alfadelta10010/AlphaOneSoC/docs/soc-architecture.md

# AlphaOneSoC — SoC architecture

The SoC around FyraCore: the address map, how it boots, the bus, the memory
controller and the QSPI engine. The overriding constraints are **area** (seven
TinyTapeout tiles, roughly 21 kGE of usable standard-cell area for everything)
and **booting NOMMU M-mode Linux from 16 MB of PSRAM**. Where the two pull
apart, this document says which one won and why.

## Address map

| Region | Base | Size | Attributes | Device |
|---|---|---|---|---|
| Flash | `0x2000_0000` | 16 MB | read, execute | W25Q128JV on QSPI CS0 |
| PSRAM | `0x8000_0000` | 16 MB | read, write, execute, LR/SC, AMO | 2x 8 MB PSRAM on QSPI CS1 (A) / CS2 (B), `addr[23]` picks the chip |
| CLINT | `0x0200_0000` | 64 KB | read, write, AMO | `src/clint.v` |
| PLIC | `0x0C00_0000` | — | reserved, not implemented (accesses fault) | — |
| UART | `0x1000_0000` | 64 KB | read, write, AMO | `src/uart.v`: 16550-compatible subset, byte registers, polled (`docs/pins-and-peripherals.md`) |
| GPIO | `0x1001_0000` | 64 KB | read, write, AMO | `src/gpio.v` + `src/spi.v`: GPIO at `+0x00`-`+0x0C` and the SPI controller (tiny_spi registers) at `+0x20`-`+0x30`, decoded on `addr[5:2]` (`docs/pins-and-peripherals.md`) |
| syscon | `0x1002_0000` | 64 KB | read, write, AMO | `src/syscon.v`: reboot, power-off, reset cause, boot mode, chip ID, straps (section "syscon") |

Everything else is unmapped: an access raises an access fault (cause 1 / 5 /
7) from the core's PMA check, before anything reaches the bus. The windows are
`fyracore` parameters (`PMA_ROM_*`, `PMA_RAM_*`, `PMA_IO0_*`, `PMA_IO1_*`);
the defaults are this map.

* **Flash is read-only.** A store, AMO or SC to it is a store access fault
  (cause 7) and an LR is a load access fault (cause 5): flash has no write
  path in the QSPI engine and no reservation set.
* **LR/SC work only in PSRAM**, the one region with a reservation set.
* PSRAM is at `0x8000_0000` because that is where Linux (`PHYS_RAM_BASE`),
  Spike (`DRAM_BASE`) and KianV all put RAM.

## Boot

**The SoC boots from flash, always.** There is no boot ROM and no strap: the
reset PC (the core's `boot_addr` input, tied off in `alphaone_soc`) is
`0x2000_0000`, the first byte of flash. Whatever was last programmed there is
the first thing the core runs, so nothing about the boot path is fixed in
silicon, and a bare assembly program runs by flashing it. Anything that runs
from PSRAM is put there by code in flash.

**While reset is held, the QSPI pins are released** (every output enable is
0), so the demo board's RP2040 can program the flash over the same Pmod pins
before it releases reset. The Pmod's 10 kΩ pull-ups hold every chip select
high meanwhile (`docs/qspi-memories.md` §1.2).

A program links with `plugins/helpers/link_soc.ld` (code and read-only data
in flash, `.data`/`.bss`/stack in PSRAM) and starts with
`plugins/helpers/boot_flash.S`, which copies `.data` to PSRAM, clears
`.bss`, sets `sp` and jumps to `_start`. (`plugins/helpers/link.ld`, at
`0x8000_0000`, is for the verification flow, which starts the core straight
in PSRAM.)

`mtvec` resets to 0. The spec leaves it unspecified, boot code must set it
before it can take a trap, and 0 matches Spike, so lockstep traces agree from
reset. A trap taken before `mtvec` is written jumps to 0, which is unmapped,
and faults there over and over: a cause-1 loop at 0 that rewrites mepc,
mcause and mtval on every pass, so the first trap's cause is lost, and the
QSPI bus goes quiet, since 0 is outside every window. Erased flash
(`0xFFFFFFFF`, an illegal instruction) at the reset vector ends this way.
Kept at 0 by decision (2026-09-29); the first thing boot code does is set
`mtvec`.

**A reboot restarts the SoC from flash exactly as a pin reset does.** A write
of `0x7777` to syscon's FINISH register holds the SoC in reset for two clock
edges (the shortest pin reset), releases the QSPI pins for those two clocks
and re-runs the start-up sequence. What it keeps is RESET_CAUSE (SOFT is
added), BOOT_MODE and the `rd_late` strap, which the flash loader reads to
decide what to boot (section "syscon").

## Bus fabric

**The core's own request/ready handshake, fanned out — not APB.**

APB needs a two-phase transfer (SETUP, then ACCESS with `PENABLE`) and a
bridge state machine to generate it, so every access costs at least two
cycles and a few registers. The core already has a request/ready port with a
held request (see `src/fyracore.v`), which is all a single-master bus needs.
`src/soc_bus.v` adds only:

* an address decode on a handful of bits — valid only because the PMA check
  has already refused anything outside the windows:
  `addr[31]` → PSRAM, `addr[29]` → flash, `addr[28]` → peripherals (then
  `addr[17:16]`), otherwise the CLINT;
* a read-data and ready mux.

It has no registers. Peripherals answer with combinational read data, and
in the cycle they are selected, so a peripheral access is one cycle -- except
for back-pressure: the UART holds a THR write, and the GPIO block a write to the SPI controller, until it is ready. An IO target may hold `ready` low only
on a cycle its own select is high, so the bus simply ANDs the IO readies. A
peripheral with a side effect (a UART RX pop, a THR load) acts only on the
cycle its select and its `ready` are both high; the request strobe
guarantees that cycle is one real access.

The instruction port goes straight to the memory controller: fetch is only
ever from flash or PSRAM.

## Memory controller (`src/mem_ctrl.v`)

Joins the core's two ports onto the one QSPI engine.

* **Arbitration: data first.** When both ports are waiting, the data request
  goes first. The pipeline only issues a new data request on the cycle
  *after* a fetch completes or after a fetch-word-reuse hit, so the core can
  make up to 4 data handshakes between two fetches (two back-to-back AMOs: a
  load and a store each), not one. The bound is what keeps a fetch from being
  starved: the formal harness `core_df` checks at most 4 data handshakes per
  held fetch (BOUNDED, 32 steps from reset), and the worst fetch latency of
  442/456 clocks (`rd_late` 0/1) is stated for that bound. Serving data first
  also avoids reading the next instruction before a load and then losing it
  while the load stalls the pipeline; fetch-first would do that on every load.
* **Chip select** from the address: flash if `addr[31]` is 0, otherwise PSRAM
  A/B by `addr[23]`.
* **Reads are always a whole word** from the word address, whatever the byte
  enables say. Memory reads have no side effects, and a whole word needs no
  lane steering: byte *k* of the transfer is lane *k*.
* **Writes send only the enabled bytes**, starting at the first enabled lane.
  RISC-V stores are naturally aligned, so the enables are always contiguous.
* **Fetches are 4 bytes from the halfword `pc`**, not from a word boundary:
  a QSPI read streams from any byte address, so a straddling 32-bit
  instruction costs nothing extra. The exception is a PSRAM fetch that crosses
  a 1 KB page (`pc[9:1]` all ones). Parts with row-boundary crossing
  (APS6404L-3SQR) run on into the next page; "compatible" parts without it
  wrap to the start of the page, and the Pmod may carry either. So that fetch
  is split into two 2-byte reads, the second at the next page. The carry out
  of the page number into bit 23 is the step from PSRAM A to B, so the A/B
  boundary (`0x807F_FFFE`) is just one instance. The QSPI engine's read shift
  register carries over between the two reads, so the split needs no extra
  storage.
* **Requests are sampled only while the engine is idle**, and it is never
  idle on the cycle it reports done. On its ready cycle the core still shows
  the request being completed (a fetch's old pc), so starting a transaction
  from it would read a stale address.

## QSPI engine (`src/qspi_ctrl.v`)

One transaction at a time: chip select low, command, 24-bit address, then
data. The **PSRAMs run in QPI mode**: the command, too, goes out on all four
lines. The **flash is unchanged**: its quad I/O read sends the command on
IO0 and the address and data on all four lines (the chip's default "SPI
mode", as opposed to QPI mode). `docs/qspi-memories.md` §9 compares the
modes, including QPI for the flash.

| Access | Command | Wire timing (SCK cycles) | 4 bytes |
|---|---|---|---|
| PSRAM read | `0x0B` fast read, QPI | 2 cmd + 6 addr + 4 wait + 2 per byte | 20 |
| PSRAM write | `0x38` quad write, QPI | 2 cmd + 6 addr + 2 per byte | 16 |
| Flash read | `0xEB` quad I/O read | 8 cmd (IO0) + 6 addr + 6 dummy + 2 per byte | 28 |

The PSRAM's 4 wait cycles are all released, a full four for the bus to turn
around. The flash reads the first two of its 6 dummy cycles as its mode
byte: the engine drives `1111` there (mode byte `0xFF`, so the flash never
enters continuous-read mode) and releases the bus for the other four.

* **SCK = clk / 2.** Output data changes as SCK falls. Read data is sampled
  one full SCK period after the falling edge that launched it, on the clock
  edge that drives SCK low again. The data then has two core clocks to cross
  the pad and device delays rather than one, which is what keeps the design
  robust against TinyTapeout's slow I/O. The device's output hold plus the pad
  delays cover the other side of that edge.
* **CS is high for at least two clocks** between transactions: 30 ns at
  66 MHz, above the PSRAM's minimum deselect time.
* **The pins are registered** where a glitch could matter (SCK, the chip
  selects, the output enable). The data outputs are combinational: they settle
  a full clock before the SCK edge that samples them.
* **Pinout** follows the TinyTapeout QSPI Pmod on `uio`: 0 CS0 (flash),
  1 SD0, 2 SD1, 3 SCK, 4 SD2, 5 SD3, 6 CS1 (RAM A), 7 CS2 (RAM B). The
  rest of the chip's pins are in `docs/pins-and-peripherals.md`.

* **Read latency is a strap**, `qspi_rd_late` (on `ui_in[0]`). At 0 a nibble is sampled two
  clocks after its launching edge, which covers a clock-to-output time plus
  pad round trip up to about 2 clocks. At 1 it is sampled three clocks after,
  which covers about 1 to 3 clocks, and chip select stays low one clock
  longer for the last nibble. TinyQV measured the TinyTapeout pad round trip
  at a little over 20 ns; at 50 MHz use 0, and at 62.5 MHz (the clock the
  3x4 harden closes at) and near 66 MHz use 1. It is a
  strap rather than a register because flash reads must work before any
  software runs, and it is sampled during reset and held, so a pin that
  changes later cannot move the sampling point mid-read. syscon latches it at
  the pin reset and holds it through reboots and power-off (a reboot does not
  re-read `ui_in[0]`, which is GPIO by then); software reads it in STRAPS. Measured in `tb_qspi` at a 10 ns clock: 0 passes 2–19 ns,
  1 passes 12–29 ns.
* **Writes never select the flash.** `0x38` is the PSRAM's quad write, but
  on the W25Q128JV-DTR it is Enter QPI. The PMA already faults stores to
  flash; this is the backstop.

A 4-byte PSRAM read is 20 SCK cycles, about 44 core clocks with the deselect
time (a flash read 28, about 60). That is the dominant cost of the whole
machine — see "Performance" below.

**Start-up sequence.** The Pmod is shared between designs on the demo board
and is not power cycled when the board switches to this one, so its devices
can be handed over in modes this engine does not speak. TinyQV, for example,
leaves the PSRAMs in QPI mode and the flash in continuous-read mode. The
PSRAM datasheet also asks for a reset after power-up. Before accepting its
first request the engine therefore sends the following, and leaves the
PSRAMs in QPI mode:

| Chips | Sent | Effect |
|---|---|---|
| CS1+CS2 | `F5h` in QPI form (2 clocks) | PSRAM exits QPI; a PSRAM in SPI mode sees an unfinished command |
| CS1+CS2 | `66h`, `99h` | PSRAM reset enable, reset (back to SPI mode, linear burst) |
| CS0 | 8 clocks of `1111` | flash leaves quad continuous-read mode |
| CS0 | 16 clocks of `1111` | flash leaves dual-I/O continuous-read mode (12 address + 4 mode clocks); must come after the 8-clock window, which a flash in quad continuous read needs first |
| CS0 | `FFh` in QPI form (2 clocks) | flash exits QPI (-DTR part); a flash in SPI mode sees an unfinished command |
| CS1+CS2 | `35h` | PSRAM enters QPI mode |

The flash steps separate the PSRAM reset from `35h` by far more than the
PSRAM's 50 ns tRST. The first step is also what takes a PSRAM we left in QPI
mode ourselves back to SPI at the next reset. The sequence starts 8 clocks
after reset is released, so a reset that lands just after the `99h` cannot
bring the restarted sequence's first command inside tRST. Each start-up
window ends with chip select rising while SCK is still high, SCK falling a
clock later: for a flash in continuous read the next falling edge would
start its data, and the two sides' pads would overlap for a moment. The
single two-clock `FFh` is the one Exit QPI that counts whether or not a
flash cancels Exit QPI on extra clocks (the datasheet does not say).

Not undone, and so the job of whatever programs the flash: a flash burst
wrap set with `77h`, deep power-down (`B9h`), and a cleared Quad Enable bit
(the "IM" part ships with QE = 0).

**Board prerequisites.** While reset is held the chip selects are released
(also for two clocks at every reboot, and for as long as the chip is powered
off);
the Pmod's 10 kΩ pull-ups (R1–R3) keep every chip deselected. The data lines
have no pull-ups. The TinyTapeout wrapper
(`src/tt_um_alfadelta10010_alphaone_soc.v`) makes this reset from `rst_n`: set
at once, clock or no clock, and released on the second clock edge after
`rst_n` rises. It releases the eight pins from that same reset, so they are
let go before the first clock edge and stay let go until the SoC has been
reset (`docs/pins-and-peripherals.md`).

**Device prerequisites.**
* The flash's Quad Enable bit (SR2 bit 1) must be set once. It is
  non-volatile; TinyTapeout's QA sets it on the Pmods it ships, and the
  "Configure and flash the QSPI Pmod" guide sets it on others.
* The devices' power-up time (150 µs for the PSRAM) has passed before reset
  is released. On the demo board it long has.
* PSRAM maximum chip-select-low time (tCEM) is 8 µs for the standard grade
  the Pmod carries (APS6404L-3SQR-SN). The longest transaction is about 60
  clocks, so the core clock must be above about 8 MHz.
* The flash is idle when reset is released: no program, erase or status
  write still running, and no erase or program suspended. While BUSY the
  flash ignores everything but status reads and suspend (-DTR §7.1.1; a
  software reset would end the operation and corrupt it, §8.2.45), for up
  to 400 ms after a sector erase, 2 s after a 64 KB block erase and 200 s
  after a chip erase. The engine has no 1-bit read path to poll it, so a
  flash handed over mid-write would be fetched from as floating lines.

## Timer and interrupts

* **`mtime` counts core clocks.** There is no prescaler, because it would cost
  a counter and a register and buy nothing Linux needs. The device tree's
  `timebase-frequency` must equal the core clock.
* **MTIP is registered** in the CLINT. That takes the 64-bit
  `mtime >= mtimecmp` compare out of the path into the core's interrupt and
  next-PC logic, at the cost of one flop and one cycle of latency.
* `mtimecmp` resets to all-ones, so no timer interrupt is pending out of reset.
* No PLIC. With a polled UART, Linux needs no external interrupt; the `0x0C00_0000`
  window is reserved for one if that changes. `docs/pins-and-peripherals.md`
  explains why interrupts would not make the console faster on this core.
* Registered MTIP is legal: Priv §3.2.1 says MTIP reflects the comparison
  "eventually, but not necessarily immediately". Linux's CLINT driver sets
  MTIE before it writes `mtimecmp` (low word, then high), with MIE off, and
  the handler clears MTIE, so the extra cycle is invisible to it.

## syscon (`src/syscon.v`)

One small register block at `0x1002_0000`: reboot, power-off, the simulation
exit code, the reset cause, a boot-mode note that survives a reboot, the chip
ID, the read-sampling strap and a watchdog. It is what Linux's generic `syscon`,
`syscon-poweroff`, `syscon-reboot` and `syscon-reboot-mode` drivers point
into.

| Offset | Name | Access | After a pin reset | At a reboot |
|---|---|---|---|---|
| +0x00 | FINISH | W; reads 0. A store with byte lanes 0 and 1 both written (`sh` or `sw`) acts on `wdata[15:0]`: `0x7777` reboot, `0x5555` power-off, `0x3333` fail (halts like power-off; `wdata[31:16]` is a code for the testbench). Any other value, or a narrower store, does nothing | - | - |
| +0x04 | RESET_CAUSE | R / W1C, lane 0. [0] PIN, [1] SOFT, [2] WDT | `0x1` | SOFT set, PIN kept |
| +0x08 | BOOT_MODE | R/W, lane 0, [7:0] | `0x00` | kept |
| +0x0C | CHIP_ID | R, the `CHIP_ID` parameter | `0x4131_5301` | - |
| +0x10 | STRAPS | R, [0] = `qspi_rd_late` as latched at the last pin reset | the pin | kept |
| +0x14 | CLK_GATE | reserved: reads 0, writes ignored | - | - |
| +0x18 | POWER | reserved: reads 0, writes ignored | - | - |
| +0x1C | - | reads 0, writes ignored | - | - |
| +0x20..+0xFC | - | read 0, writes ignored | - | - |
| +0x100..+0x1FF | WDT | the watchdog, below | 0 (TOP 15) | disabled |
| +0x200..+0xFFFC | - | read 0, writes ignored; no register is aliased | - | - |

CHIP_ID is ASCII "A1S" in [31:8] and the silicon revision `0x01` in [7:0].

**The whole 64 KB window is decoded.** Only +0x00..+0x1C and the watchdog window
+0x100..+0x1FF are registers; every other word reads 0 and ignores writes, with no alias of any register at any
offset. That includes the SoC test mailbox words at +0x7F0 (EVENT), +0x7F4
(VALUE), +0x7F8 (VALUE2) and +0x7FC (spare), which the testbench watches on
the core's data port (`tests/soc/periph.h`) and the hardware ignores. They sit
below +0x800 because a store offset is a 12-bit signed immediate, so
`sw x, 0x7F0(s11)` assembles from the same base as the real registers and
+0xF00 would not. syscon never holds `ready` low, so `soc_bus` needs no ready
port for it.

### Two resets

`alphaone_soc` has two resets. `rst` is the chip's reset (`rst_n` through the
wrapper). `rst_soc = rst | rq | off`, an output of syscon, is the reset of
every other block.

| Reset | Blocks on it | Why |
|---|---|---|
| `rst` | syscon's RESET_CAUSE, BOOT_MODE, strap flop, and the reboot and power-off flops (`rq`, `rq2`, `off`) | These must survive a reboot, and syscon must not reset itself in the middle of the write that asked for it |
| `rst_soc` | the core | A reboot restarts it at the reset vector |
| | `mem_ctrl` | It holds the old core's outstanding fetch |
| | `qspi_ctrl` | It must abort the transaction a reboot cuts and re-run its start-up sequence, so every device is back in a known mode |
| | the CLINT | `mtimecmp` must come back all-ones and `msip` 0, so no interrupt is pending at boot |
| | the UART | A break (`LCR.SBC`) must drop and the divisor return to its reset value for the boot loader |
| | the GPIO block | The OLED must go back into reset with its panel supply off, and a half-sent SPI byte must stop |

`rst_soc` is a function of `rst` and flops alone, nothing from the bus, and is
used only as a synchronous reset (the only asynchronous resets in `src/` are
the wrapper's own `rst_n` flops). syscon's bus writes are ignored while
`rst_soc` is high. The watchdog's flops are on `rst_soc` as well (see "Watchdog"). The reset tree
gains one OR at its root.

The generator is in the SoC, not in the wrapper: `alphaone_soc`'s ports do not
change, the SoC benches can test a reboot without the wrapper, and the
hardened wrapper is untouched.

### Reboot

A store of `0x7777` to FINISH sets `rq`, which holds `rst_soc` for exactly two
clock edges, the same as the shortest pin reset (the wrapper releases `rst` on
the second edge after `rst_n` rises). Every block therefore restarts from the
state it was already verified to start from. `rq` is a single flop held high
across both edges; its timer `rq2` does not feed the OR, so there is no
two-flop hand-over on the reset.

| Edge | `rst_soc` before it | At the edge |
|---|---|---|
| E0 | 0 | The store completes; `rq` <- 1, RESET_CAUSE.SOFT <- 1 |
| E1 | 1 | Every block but syscon resets: `ctl_oe` and `io_oe` <- 0 (QSPI pins released), `cs_n` <- 111, `sck` <- 0, `uo_out` = `0xB9`, pc <- the reset vector; `rq2` <- 1 |
| E2 | 1 | Still in reset; `rq` <- 0, `rq2` <- 0 |
| E3 | 0 | First running edge: `ctl_oe` <- 1 (SCK and the chip selects driven idle), the start-up sequence starts 8 clocks later, the core fetches `0x2000_0000` |

That is the shape of a pin reset after `rst_n` rises. In the acceptance run
(a flash-booted program that reboots once, `tb_soc_reboot`) both boots read
`mtime` as 531 at the same instruction, so the reboot restarts cycle for cycle
like a pin reset, and `ctl_oe` was low for 2 cycles. Two edges are the shortest
reset the blocks were verified with; nothing needs more.

### Power-off

A store of `0x5555` (or the fail value `0x3333`) sets `off`, which holds
`rst_soc` until `rst`:

* The QSPI pins are released. The Pmod's 10 kΩ pull-ups hold every chip
  select high, so the flash and both PSRAMs deselect and drop to standby.
* `uo_out` = `0xB9`: UART idle, RTS# not ready, the OLED in reset with its
  panel supply off.
* The clock keeps running. Nothing gates a clock yet, so only the clock tree
  and the flops' clock pins toggle; `mtime` stops, because the CLINT is in
  reset.
* Only `rst_n` wakes it.

**There is no flash deep power-down (`B9h`).** Waking the flash needs `ABh`
and tRES1 (3 µs, about 190 clocks) in the start-up sequence, which is a new
long counter in `qspi_ctrl`. A flash left in deep power-down is hidden state
on a Pmod shared between designs, which the next design or the RP2040's
programmer may not undo (`qspi_ctrl.v`'s header already lists `B9h` among the
states we leave alone). And the gain is microamps, on a chip whose clock keeps
running.

### FINISH

FINISH follows QEMU's `sifive_test` (`hw/misc/sifive_test.c`): only offset 0
acts, `status = val & 0xffff`, `code = val >> 16`; `0x3333` is FAIL, `0x5555`
PASS and `0x7777` RESET; reads return 0. The benches therefore use the same
codes as software built for QEMU's `virt` machine. syscon acts on a store
whose lanes 0 and 1 are both written (`sh` or `sw`), as `sifive_test` accepts
2- and 4-byte accesses. FINISH reads 0 because Linux's `regmap_update_bits()`
reads the register before it writes and skips the write if the value would not
change: reading back `0x5555` or `0x7777` would make the driver do nothing.

### RESET_CAUSE

There are three bits: PIN, SOFT and WDT (set when the watchdog fires).
**There is no power-on bit:** TinyTapeout has no power-on-reset cell, and a
power-on is always followed by an `rst_n` pulse from the board, so the chip
cannot tell it from a pin reset. All bits are sticky and cleared only by
writing 1 to them (lane 0) or by the pin reset that sets PIN again. A reboot
sets SOFT and keeps what was there, so after a reboot the register reads `0x3`
unless software cleared PIN first; after a watchdog reset it reads `0x5` if
nothing else set a bit since the pin reset (`0x7` after an earlier reboot): the
bits accumulate. Rule: software that wants the cause of the last reset alone
reads RESET_CAUSE at boot and then writes `0x7` to clear it; our kernel and
flash loader are to do so at every boot.

### BOOT_MODE and reboot-mode

BOOT_MODE is a byte software writes before it reboots; the flash loader reads
it after to decide what to boot. A pin reset clears it. Linux's
`syscon-reboot-mode` writes a mode's magic to it before calling the restart
handler. `reboot-mode.c` never writes a magic of 0, so the device tree's modes
are 1 and 2: BOOT_MODE 0 then means "pin reset, or no mode written", and a
"normal" reboot after a "bootloader" one does overwrite it.

### CLK_GATE and POWER

Reserved: they read 0 and ignore writes, instead of the R/W registers
`docs/ROADMAP.md` 1.2 proposed. No clock-gate cell is used anywhere yet (the
one ICG attempt failed TinyTapeout's lint with a multiple-driver error and
grew hold buffers), and ROADMAP 6.2 puts power measurement before any gating.
A register with no function would be flops and an ABI nobody can define. The
offsets are kept so the map does not move when they arrive.

### Strap

syscon owns the `qspi_rd_late` strap flop, loaded on every edge while `rst` is
high (the same window as before syscon existed) and drives `qspi_ctrl`'s
`rd_late` input: the live pin while `rst` is high, the latched value
otherwise. `qspi_ctrl.v` is unchanged: its `late` flop still reloads whenever
its reset is high, but during a reboot it sees the latched value, not
`ui_in[0]`, which is GPIO by then. A scratch run flipped the pin at a reboot
and the second boot still read flash; a version that follows the pin hangs in
the second boot.

### Area

syscon without the watchdog is **0.078 tile, 14 flops** (`rq`, `rq2`, `off`, the strap flop,
`cause[1:0]`, `boot_mode[7:0]`), from the audit's recipe (`docs/area-audit.md`), re-run on the
committed RTL 2026-10-24, with the TT cell set (882.1 µm²), within the 0.5-tile budget
`docs/ROADMAP.md` allows for new RTL. The reset tree's extra OR at its root is
the one thing a harden should check, at the slowest corner. The watchdog adds
0.072 tile and 9 flops (815.8 µm²), and the `~rst_soc` gate on `fire` about
10 µm² and no flop: 0.151 tile and 23 flops in all, 1,707.9 µm² (see
"Watchdog"). These are flat per-block figures; they are re-measured in context
at the area pass.

### Watchdog (`src/syscon.v`, +0x100..+0x1FF)

A minimal hardware watchdog in the Synopsys DesignWare WDT layout, so that
Linux's upstream `dw_wdt` driver (`snps,dw-wdt`, `CONFIG_DW_WATCHDOG`, which
depends only on `HAS_IOMEM`) runs it unchanged: there is no kernel code to
write or carry. On expiry it raises the same reboot request as a FINISH write
of `0x7777` and sets RESET_CAUSE.WDT. It is a 256-byte window inside syscon's
64 KB, decoded on `addr[15:8] == 8'h01`; it overlaps none of the registers
above, and the rest of the window stays read-0, write-ignored with no alias.
It gets its own device-tree node, beside the `syscon` node, not inside its
`reg`.

| Offset | Name | Access | After any `rst_soc` reset |
|---|---|---|---|
| +0x100 | WDT CR | Lane 0. [0] EN: a write with bit 0 = 1 sets it; nothing clears it but a reset. [1] RESP_MODE reads 0 and ignores writes | 0 |
| +0x104 | WDT TORR | [3:0] TOP, R/W, lane 0; reads `{TOP, TOP}` in [7:0]. A write also kicks | `0xFF` (TOP 15) |
| +0x108 | WDT CCVR | Reads 0 | - |
| +0x10C | WDT CRR | Lane 0: writing `0x76` kicks, any other value is ignored. Reads 0 | - |
| +0x110, +0x114 | STAT, EOI | Read 0 | - |
| +0x1F4 | COMP_PARAMS_1 | Reads `0x0000_0040` (USE_FIX_TOP: timeout TOP = 2^(16+TOP) clocks) | - |
| other +0x100..+0x1FF | - | Read 0, writes ignored | - |

Source: `drivers/watchdog/dw_wdt.c` and `snps,dw-wdt.yaml` (torvalds master,
read 2026-10-23). The driver writes CR (EN, RESP_MODE), TORR (`top | top << 4`),
reads CCVR for `get_timeleft`, writes `0x76` to CRR to kick, and reads
COMP_PARAMS_1 bit 6 to learn that the timeouts are the fixed powers of two.

**Timeout.** TOP *t* gives 2^(16+*t*) clocks, *t* = 0..15.

| TOP | 2^(16+TOP) clocks | at 62.5 MHz | at 50 MHz | TOP | at 62.5 MHz | at 50 MHz |
|---|---|---|---|---|---|---|
| 0 | 65,536 | 1.05 ms | 1.31 ms | 8 | 268 ms | 336 ms |
| 2 | 262,144 | 4.19 ms | 5.24 ms | 10 | 1.07 s | 1.34 s |
| 4 | 1,048,576 | 16.8 ms | 21.0 ms | 12 | 4.29 s | 5.37 s |
| 6 | 4,194,304 | 67.1 ms | 83.9 ms | 14 | 17.2 s | 21.5 s |
| | | | | 15 | 34.4 s | 42.9 s |

At 62.5 MHz `dw_wdt` has `min_timeout` 1 s (TOP 10), `max_hw_heartbeat_ms`
34,359 (TOP 15) and a default of 30 s (TOP 15); for longer timeouts the
watchdog core pings on the kernel's behalf.

**Timebase: a tap of `mtime`.** syscon takes `wdt_tap = mtime[29:14]` from the
CLINT. TOP *t* selects `mtime[14+t]`, whose rising edges come every
Pt = 2^(15+*t*) clocks. There is no prescaler and no extra counter. While any
reset is held the CLINT is reset too, so `mtime` sits at 0 and no tap moves.
The cost is that software can write `mtime`: a write that moves it backwards
delays the watchdog, and a loop that keeps rewriting it would keep it from
firing; and a write that toggles the tapped bit counts as a tick, so writes
can also make it fire early (three toggling writes fire it 10 clocks after a
kick). Linux's timer driver never writes `mtime` (it reads it and writes
`mtimecmp`), so this is accepted; a private prescaler would cost about 24
flops (+0.06 tile).

**Accuracy: never early unless software writes mtime, at most 1.5x late.** A
2-bit tick count, cleared by a kick, by a TORR write and while disabled, counts
the rising edges of the tap; the third one fires. The first edge comes within
(0, Pt] of the clear, so the reset comes in (2Pt, 3Pt] after it, which, with no
software write to `mtime`, is more than 1x and at most 1.5x the
2^(16+TOP) timeout (plus one clock, see TORR below). A 1-bit count would save
0.007 tile and allow up to 2x late. Linux pings at half the hardware timeout,
so neither matters to it.

**Kicks, TORR and the lock.**

* A kick is a CRR write whose lane 0 holds `0x76`: eight bits, not sixteen. CR
  and TORR writes take no key.
* Once enabled it cannot be stopped except by a reset. That is DesignWare
  behaviour, and `dw_wdt` expects it: with no reset controller its `stop` only
  marks the watchdog as still running and keeps pinging it. This is the lock,
  always on, with no extra bit.
* A TORR write kicks and makes no tick of its own. Changing TOP switches the
  tapped bit, which can look like a rising edge and make the next reset come
  one tick early (15 clocks against a floor of 16 in a scratch run), so a TORR
  write clears the count and forces the edge detector's previous value to 1
  for that cycle. The cost is one clock of worst case: a real edge in that
  cycle is swallowed, so the bound is 3Pt + 1.
* TORR resets to TOP 15 (reads `0xFF`): a program that sets EN without writing
  TORR gets 34 s, not 1 ms.
* RESP_MODE reads 0 and ignores writes: there is no interrupt line, and with
  no `interrupts` property the driver offers no pretimeout.

**CCVR reads 0**, so `/sys/class/watchdog/watchdog0/timeleft` shows 0 s. A real
readback needs a variable shifter, about +0.12 tile.

**SA-008.** A kick or a TORR write in the very cycle of the third tick does not
stop the fire. The reset still comes within the bound above; software that
kicks at the last instant of the timeout can lose the race, as with any
watchdog.

**Reset domains: no loop, no fire while off.**

* The watchdog's own flops (EN, TOP, count, tick edge) are on `rst_soc`. A
  pin reset, a reboot, power-off and its own expiry all leave it disabled
  with TOP back to 15.
* Its expiry is a one-cycle pulse `fire` ORed into the reboot request `rq`. It
  cannot repeat: the tick is an edge, gone the next cycle, and on the edge
  after that `rst_soc` clears EN.
* It cannot fire while any reset is held: `fire` is gated by `rst_soc`. That
  matters for one cycle. A FINISH store sets `rq` or `off` on its edge, but
  EN and the count clear only on the next edge, so a third tick in the cycle
  after the store would otherwise set WDT and raise `rq` (a reboot would read
  RESET_CAUSE `0x7`, not `0x3`). From that next edge `rst_soc` holds EN at 0
  and `mtime` at 0, through a reboot and for as long as the SoC is off.
* RESET_CAUSE bit 2 (WDT) is on `rst`, so it survives the reboot it caused.
  A fire in the same cycle as a W1C of bit 2 leaves it set (set wins). If
  `fire` and a FINISH reboot meet in one cycle, SOFT and WDT are both set and
  there is one reboot; with a power-off, `off` wins.

**Area.** syscon with the watchdog is **0.151 tile, 23 flops** (1,707.9 µm²,
the audit's recipe (`docs/area-audit.md`), re-run on the committed RTL
2026-10-24, with the TT cell set), against 0.078 tile and 14 flops
without. The watchdog is +815.8 µm², about +0.072 tile, +9 flops: EN, TOP[3:0],
count[1:0], the tick edge and RESET_CAUSE[2]. The alternative considered and
not taken, a custom keyed register with an out-of-tree driver, measured
+0.068 tile and needs a kernel patch carried for the life of the project.
Linux's `softdog` costs no area but catches only a hung userspace, not a hung
kernel or a CPU spinning with interrupts off.

### Linux

Device tree. `reg` is for a root with `#address-cells = <1>`; with `<2>` it is
`<0x0 0x10020000 0x0 0x20>`.

```dts
syscon: syscon@10020000 {
    compatible = "alfadelta10010,alphaone-syscon", "syscon", "simple-mfd";
    reg = <0x10020000 0x20>;
    reg-io-width = <4>;

    poweroff {
        compatible = "syscon-poweroff";
        offset = <0x0>;
        value = <0x5555>;
    };

    reboot {
        compatible = "syscon-reboot";
        offset = <0x0>;
        value = <0x7777>;
    };

    reboot-mode {
        compatible = "syscon-reboot-mode";
        offset = <0x8>;
        mask = <0xff>;
        mode-normal = <0x1>;
        mode-bootloader = <0x2>;
    };
};
```

* `syscon-reboot-mode` must be a child of a `"syscon", "simple-mfd"` node (its
  binding, `syscon-reboot-mode.yaml`). `syscon-reboot` and `syscon-poweroff`
  take the parent's regmap when they have no `regmap` phandle (current
  `syscon-reboot.c` and `syscon-poweroff.c`); an older kernel may need
  `regmap = <&syscon>;` in those two nodes, the form KianV's 6.8 device tree
  uses. Check the target kernel.
* `reg` covers the 8 implemented words only (`max_register = 0x1C`), so Linux
  cannot reach the mailbox or the watchdog window, which has its own node.
* The modes are 1 and 2 because `reboot-mode.c` never writes 0 (see
  BOOT_MODE above).
* Kernel options: `CONFIG_MFD_SYSCON`, `CONFIG_POWER_RESET`,
  `CONFIG_POWER_RESET_SYSCON`, `CONFIG_POWER_RESET_SYSCON_POWEROFF`,
  `CONFIG_REBOOT_MODE`, `CONFIG_SYSCON_REBOOT_MODE`.
* The `alfadelta10010` vendor prefix is not registered. That is fine for an
  out-of-tree device tree; `checkpatch` only warns.

The watchdog node, with a fixed clock for the core clock (`dw_wdt` needs
`clocks`; the binding requires only `compatible`, `reg` and `clocks`):

```dts
sysclk: sysclk {                      /* the core clock = timebase-frequency */
    compatible = "fixed-clock";
    #clock-cells = <0>;
    clock-frequency = <62500000>;
};

watchdog@10020100 {
    compatible = "snps,dw-wdt";
    reg = <0x10020100 0x100>;
    clocks = <&sysclk>;
};
```

* Kernel options: `CONFIG_WATCHDOG`, `CONFIG_DW_WATCHDOG`, `CONFIG_COMMON_CLK`
  (=y in the RV32 6.12 config of `localFiles/rv32-linux-soc`; confirm in the
  NOMMU config) and `CONFIG_WATCHDOG_HANDLE_BOOT_ENABLED=y`, so the kernel
  pings a watchdog the flash loader armed until userspace opens
  `/dev/watchdog`. Userspace: busybox `watchdog`.
* What the driver does here: probe clears RESP_MODE (already 0) and takes the
  timeouts from the fixed TOPs; start writes TORR, kicks, sets EN; ping writes
  CRR = `0x76`; stop cannot stop it and the core keeps pinging; timeleft is 0.
  Its restart handler (priority 128, below `syscon-reboot`'s 192) writes
  TORR = 0 and arms or kicks, for a reset in about 1 ms; `syscon-reboot` runs
  first.

### Verification

syscon is unreachable in the lockstep benches: they switch the IO window off
because Spike has no device at `0x1002_0000`, so a syscon access faults in the
DUT and in Spike alike, `rst_soc` equals `rst`, and the `run.sh soc` traces
are byte-identical with and without the block. Its tests are DUT-only, through
the SoC benches. Spike's device tree for the golden Linux boot leaves the
syscon node out (a Spike MMIO plugin, `--extlib`, could stand in later).

## Linux

* **The kernel runs from PSRAM, not in place from flash.** RISC-V's
  `XIP_KERNEL` is `depends on MMU` — in v6.1 exactly as in current kernels —
  so an older kernel does not change this. Boot code in flash copies the
  kernel image, its device tree and an initramfs into PSRAM and jumps to it.
* **The boot loader is ordinary code in flash.** It copies the images to
  PSRAM and enters the kernel with the hart ID in `a0` and the device tree's
  address in `a1` (or the kernel is built with `CONFIG_BUILTIN_DTB`). KianV
  does exactly this on the same map, and its SPI-framed copy of the image
  took about 20 s at 30 MHz; our PSRAM writes are QPI.
* A NOMMU M-mode kernel expects RAM at `0x8000_0000` (`PHYS_RAM_BASE`), loads
  at a 4 MB boundary on RV32, sets up PMP itself (`pmpaddr0 = -1`,
  `pmpcfg0 = 0x1F`), reads `mhartid` itself, and keeps time through CLINT
  MMIO. All of that holds on this map.
* **16 MB is the whole budget.** The kernel's text, data, initramfs and page
  cache all come out of the same 16 MB, so the kernel config has to be small.
  The flash holds the images compressed or not, whichever keeps the copy loop
  simple.

## Verification

* The core-level flow (river_core, `tests/directed`) runs the core on this
  map. The testbench models 16 MB of PSRAM at `0x8000_0000`, answers the flash
  window with zeros, and starts the core in PSRAM (`boot_addr =
  0x8000_0000`), where Spike starts.
* Spike is given `-m0x20000000:0x1000000,0x80000000:0x1000000`.
  **Spike has no read-only memory**, so a store to flash succeeds on Spike and
  faults on the core. That is a known, spec-legal divergence. No
  Spike-compared test stores to flash; `pma_flash` checks the flash faults
  DUT-only (LR cause 5; SC, AMO and stores of every width cause 7; mtval =
  the address).
* `tests/directed/run.sh soc` runs the same directed suite through the real
  memory path (bus fabric, memory controller, QSPI engine and a behavioural
  flash/PSRAM model, `tb/qspi_pmod_model.v`), compared against the same Spike
  references. The SoC boots from flash, so for a PSRAM-linked test the
  testbench loads the image into the model's PSRAM through the back door,
  forces the core's `boot_addr` to `0x8000_0000` and traces from there. The
  first fetch still goes through the fabric and the QSPI engine, and waits
  for the start-up sequence; every register is 0 on entry, as on Spike,
  which starts the hart at `--pc` with no boot ROM. MANIFEST mode `flash`
  tests are flash images, boot from the real `boot_addr` and are traced
  from reset (`flash_boot`: runs from flash, copies a routine to PSRAM,
  runs it there; `straddle_flash_end`: a 32-bit instruction at the last
  halfword of flash), so they exercise the order silicon uses. Tests that
  assume a fast memory -- timer periods of 37-100 clocks, reading `cycle`
  right after writing it -- are listed in `#soc-skip` lines; `t_irq_slow`,
  `irq_stress`, `t_ctl_slow` and `lrsc_trap_clear` (LR/SC under timer
  interrupts) cover interrupts at QSPI speed. MANIFEST `soc` lines run `flash_boot` and
  `irq_stress` again with the Pmod model's hostile hand-over states and with
  late sampling (`+RD_LATE`, a 25 ns round trip) on page-wrapping PSRAM.
* `make test-qspi` runs `tb_qspi` (every transfer shape, page and chip
  boundaries, arbitration) across device delays, the `rd_late` strap, a
  page-wrapping PSRAM and devices handed over in QPI / quad and dual
  continuous-read modes (one PSRAM in QPI and the other not, too), then
  `tb_qspi_stress` (core-shaped request streams, 400k clocks of random
  traffic against a shadow memory), twice more with resets dropped into
  the traffic and aimed at the start-up sequence (each run requires resets
  landing in it and in its 16-clock step). The Pmod model checks protocol, bus contention, tCEM, tCPH,
  tRST and SCK's period and duty per command as it goes, and closes the
  read data eye between its hold (`+QSPI_HOLD`) and delay.
* The peripherals are not reachable from the directed suite (its IO window
  is off, since Spike has no such devices), and Spike could not lockstep
  them anyway. They are checked self-checking instead:
  * `make test-uart`: `tb_uart` -- every offset, byte enable and DLAB
    state against a scoreboard, TX predicted on every clock from the 16x
    tick grid, RX from a reference transmitter across baud error, glitches,
    framing errors, breaks and overrun, RTS#, IIR, same-cycle priorities,
    divisor reload, constrained-random traffic.
  * `make test-gpio`: `tb_gpio` -- registers and pins every clock, the IN
    synchroniser's latency, a mode-3 SPI checker at every DIV, and the
    write back-pressure that keeps CS#/D/C still under a byte.
  * `make test-soc-periph`: `tb_soc_periph` runs flash-booted programs
    (`tests/soc/`) through the whole SoC against board models --
    `tb/rp2350_uart_model.v` (CTS-honouring terminal), `tb/ssd1331_model.v`
    (the OLED's serial timing, table 21) and `tb/keypad_model.v` -- with
    `req_hold_check` on both core ports: hello-world with and without
    polling, echo under flow control, a replay of the Linux 8250 driver's
    polled accesses, OLED bring-up, keypad scan, timer interrupts while a
    peripheral holds a store, every access width and AMO on the IO, and
    stores to every other target at the CLINT's offsets (`clint_decode`:
    only a CLINT store may write the CLINT).

## Area

Standard-cell area before placement, in tiles (1 tile ≈ 11,300 µm² at
TinyTapeout's 60% density). With the area cuts in `docs/area-audit.md`
applied, LibreLane's own synthesis (TT's flow, ttsky26c) puts the whole SoC at
**12.52 tiles, 2,238 flops** (16.58 tiles before the cuts), against about 7
tiles for a 4x2 slot. The yosys recipe the audit uses to rank cuts gives
10.07 tiles: it lets yosys use cells LibreLane excludes, so its figures run
about 20-24% low. The largest blocks, hierarchical with TT's cells: register
file 3.68, CSR 2.65, core glue 2.67, muldiv 0.93 tiles. The SoC blocks added
here cost about 0.7 tiles flat in the recipe (qspi_ctrl 0.24, mem_ctrl 0.07,
the UART 0.29 with 77 flops, GPIO with its SPI transmitter 0.12; soc_bus
mostly folds away). syscon with its watchdog adds 0.151 tile, 23 flops
(synthesised on its own with the TT cell set). The SoC hardens clean at 3x4
tiles and closes 62.5 MHz at every corner (see "Performance" below and
`macro/rf_top/README.md`). syscon and its reset rewiring came after that
harden, so the next harden re-checks fit and the `rst_soc` root at the slow
corner.

## Performance

Every fetch and every data access is a full QSPI transaction. With the
PSRAMs in QPI mode a 4-byte PSRAM read is 20 SCK cycles (about 44 core
clocks) and a flash read 28 (about 60). A taken branch also wastes the
fall-through fetch, because a redirect waits for the outstanding fetch to
complete.

Measured through the whole SoC (`tests/directed/run.sh soc`, clocks per
traced instruction, every test with at least 40 instructions): **77.3
before PSRAM QPI, 57.1 after, −26%**; the longest test, t_memstress (3,027
instructions of loads and stores), went from 77.0 to 55.8. flash_boot,
which runs from flash, moved only 5%. Re-measured by the 2026-09-29 area
review at `4b4ed8b`, the same suite gives 59.2 in aggregate (63.9 as a
mean of per-test figures, wfi_slow alone at 136), and a compiled-C
benchmark 56.1: about 0.89 MIPS at 50 MHz (0.53 MIPS at 30 MHz). Since EX
was split over three cycles the 3x4 harden closes at 62.5 MHz at every corner
(`macro/rf_top/README.md`), for about 1.1 MIPS; the split costs 0.7 % more
clocks through the pins. Per instruction: ALU 42 clocks; `lw`,
a taken branch and every M op 84; `sw` 76; `sb` 64.

Options not yet taken, roughly in order of payoff per gate:

1. **Keep the fetch stream open.** Leave chip select low after a fetch and,
   if the next fetch is sequential, keep clocking. The review estimates about
   1.6x, because every load, store and taken branch closes the one shared
   bus, for about 0.5–0.7 kGE. It also ends the refetching during WFI and
   M-op stalls. It must close the stream at every 1 KB PSRAM page and within
   tCEM, and it is the heaviest to verify.
2. **Stop the two wasted fetches (prototyped, for a follow-up branch).**
   A taken branch pays for the fall-through fetch already in flight, and an
   M op starts only after a fetch completes and then discards it, so both
   cost one extra QSPI read (about 42 clocks). Holding `imem_req` low while
   a branch or jump is in EX, and letting `muldiv_start` ignore only a
   pending fetch, fix both at 0.00 tiles with no change to the
   request/ready contract: a taken branch drops from 84 to 43 clocks, an M
   op from 84 to 42, a not-taken branch rises from 42 to 43, and the
   compiled-C benchmark goes from 56.1 to 48.3 clocks per instruction
   (−14%). Prototypes in `localFiles/area-audit/pr5/`; kept off this branch
   by decision (2026-09-29).

3. **SCK = clk.** Anywhere between no gain and 2x, depending on whether the
   core or the pads limit the clock. With a round trip over 20 ns it needs
   multi-cycle sampling and a gated clock output, and the TinyTapeout pads
   toggle at about 33 MHz at most, so it only helps at a core clock of 33 MHz
   or less.

Declined: flash continuous read or QPI (`docs/qspi-memories.md` §9.4, 28 →
20 or 16 SCK per flash read). The decision (2026-09-26, §9.3 there) is PSRAM
QPI only; the flash keeps the quad I/O `0xEB` read with mode byte `0xFF`.
