alfadelta10010/AlphaOneSoC/src/alphaone_soc.v

// AlphaOneSoC top level: FyraCore, the bus fabric, the memory controller and
// QSPI engine for the TinyTapeout QSPI Pmod, the CLINT, the UART and the
// GPIO block (with the SPI controller for the OLED and an SD card).
//
// Address map (docs/soc-architecture.md):
//
//   0x2000_0000  flash   16 MB  read, execute        QSPI CS0
//   0x8000_0000  PSRAM   16 MB  read, write, execute QSPI CS1 (A) / CS2 (B)
//   0x0200_0000  CLINT   64 KB
//   0x1000_0000  UART    16550 subset, byte registers (src/uart.v)
//   0x1001_0000  GPIO    OUT / IN / SPICTL, SPI controller at +0x20 (src/gpio.v, src/spi.v)
//   0x1002_0000  syscon  reboot, power-off, reset cause, boot mode, chip ID,
//                        straps, watchdog at +0x100 (src/syscon.v)
//
// Chip pins (docs/pins-and-peripherals.md): the UART's TX and RTS# are
// uo_out[4] and [5], and RX is ui_in[3]; gpio_out drives the other six
// uo_out pins (gpio_out[5:4] are always 0 -- those pins are the UART's),
// and gpio_in reads all eight ui_in pins, RX and the rd_late strap
// included. The TinyTapeout top level
// (src/tt_um_alfadelta10010_alphaone_soc.v) maps these to the pins.
//
// qspi_rd_late is a strap for the QSPI read-sampling point: 0 samples two
// clocks after the device's launching edge, 1 three (see qspi_ctrl.v). Pick
// it from the clock frequency and the measured pad round trip. syscon latches
// it at the pin reset and hands qspi_ctrl the latched value during a reboot.
//
// Two resets: `rst` (the chip's reset) resets only syscon's sticky state
// (RESET_CAUSE, BOOT_MODE, the strap, the reboot / power-off flops); syscon's
// rst_soc = rst | reboot | power-off resets every other block. A reboot
// (FINISH 0x7777) holds rst_soc for two clock edges, as the shortest pin reset
// does; power-off (0x5555, or 0x3333 fail) holds it until rst.
//
// Boot: from flash, always -- the reset PC is 0x2000_0000, the first byte of
// flash. There is no boot ROM: whatever was last programmed there is the
// first thing the core runs, and anything that runs from PSRAM is put there by
// code in flash. While rst or a reboot/power-off holds the SoC in reset every
// QSPI pin is released, so an external master (the demo board's RP2040) can
// program the flash first. A reboot restarts the SoC exactly like a pin reset,
// except that RESET_CAUSE, BOOT_MODE and the rd_late strap survive it.
//
// The PMA_* parameters default to the map above. They are exposed only so
// the verification testbench can size the CLINT window to Spike's and switch
// off the IO window Spike has no device behind.

module alphaone_soc #(
    parameter [31:0] MARCHID      = 32'h0000_0000,
    parameter [31:0] PMA_IO0_BASE = 32'h0200_0000,
    parameter [31:0] PMA_IO0_TOP  = 32'h0200_FFFF,
    parameter [31:0] PMA_IO1_BASE = 32'h1000_0000,
    parameter [31:0] PMA_IO1_TOP  = 32'h1002_FFFF,
    // UART divisor out of reset: 27 = 115200 baud at a 50 MHz clock
    parameter [15:0] UART_DIV_RESET = 16'd27
)(
    input  wire       clk,
    input  wire       rst,
    input  wire       qspi_rd_late,  // strap: sample QSPI read data a clock later
    // QSPI Pmod
    output wire       qspi_sck,
    output wire [2:0] qspi_cs_n,     // CS0 flash, CS1 PSRAM A, CS2 PSRAM B
    output wire       qspi_ctl_oe,   // output enable for SCK and the chip selects
    output wire [3:0] qspi_io_out,
    output wire       qspi_io_oe,
    input  wire [3:0] qspi_io_in,
    // UART
    input  wire       uart_rx,
    output wire       uart_tx,
    output wire       uart_rts_n,
    // GPIO (out[1] / out[3] are MOSI / SCK while the SPI controller is on)
    input  wire [7:0] gpio_in,
    output wire [7:0] gpio_out
);

    // ── Core ────────────────────────────────────────────────────────────────
    wire        rst_soc;                // syscon: reset for every block but itself
    wire [31:0] imem_addr, imem_rdata;
    wire        imem_req, imem_ready;
    wire [31:0] dmem_addr, dmem_wdata, dmem_rdata;
    wire [3:0]  dmem_be;
    wire        dmem_req, dmem_we, dmem_ready;
    wire        timer_irq, sw_irq;
    wire [63:0] mtime;

    fyracore #(
        .MARCHID     (MARCHID),
        .PMA_IO0_BASE(PMA_IO0_BASE),
        .PMA_IO0_TOP (PMA_IO0_TOP),
        .PMA_IO1_BASE(PMA_IO1_BASE),
        .PMA_IO1_TOP (PMA_IO1_TOP)
    ) cpu (
        .clk         (clk),
        .rst         (rst_soc),
        .boot_addr   (32'h2000_0000),     // flash
        .imem_addr   (imem_addr),
        .imem_req    (imem_req),
        .imem_rdata  (imem_rdata),
        .imem_ready  (imem_ready),
        .dmem_req    (dmem_req),
        .dmem_addr   (dmem_addr),
        .dmem_wdata  (dmem_wdata),
        .dmem_be     (dmem_be),
        .dmem_we     (dmem_we),
        .dmem_rdata  (dmem_rdata),
        .dmem_ready  (dmem_ready),
        .timer_irq   (timer_irq),
        .external_irq(1'b0),           // no PLIC
        .sw_irq      (sw_irq),
        .mtime_in    (mtime),
        .fencei_flush(),               // nothing caches instructions
        .dbg_pc      (),
        .dbg_retired (),
        .dbg_instr   (),
        .dbg_compressed(),
        .dbg_trap    ()
    );

    // ── Bus fabric ──────────────────────────────────────────────────────────
    wire        mem_d_req, mem_d_ready;
    wire [31:0] mem_d_rdata;
    wire        clint_sel;
    wire [31:0] clint_rdata;
    wire        uart_sel, uart_ready, gpio_sel, gpio_ready;
    wire [31:0] uart_rdata, gpio_rdata;
    wire        syscon_sel, qspi_late;
    wire [31:0] syscon_rdata;

    soc_bus bus (
        .d_req       (dmem_req),
        .d_addr      (dmem_addr),
        .d_rdata     (dmem_rdata),
        .d_ready     (dmem_ready),
        .mem_req     (mem_d_req),
        .mem_rdata   (mem_d_rdata),
        .mem_ready   (mem_d_ready),
        .clint_sel   (clint_sel),
        .clint_rdata (clint_rdata),
        .uart_sel    (uart_sel),
        .uart_rdata  (uart_rdata),
        .uart_ready  (uart_ready),
        .gpio_sel    (gpio_sel),
        .gpio_rdata  (gpio_rdata),
        .gpio_ready  (gpio_ready),
        .syscon_sel  (syscon_sel),
        .syscon_rdata(syscon_rdata)
    );

    // ── syscon ──────────────────────────────────────────────────────────────
    syscon syscon_inst (
        .clk          (clk),
        .rst          (rst),
        .rst_soc      (rst_soc),
        .sel          (syscon_sel),
        .we           (dmem_we),
        .be           (dmem_be),
        .addr         (dmem_addr[15:2]),
        .wdata        (dmem_wdata),
        .rdata        (syscon_rdata),
        .strap_rd_late(qspi_rd_late),
        .rd_late      (qspi_late),
        .wdt_tap      (mtime[29:14])
    );

    // ── Memory controller + QSPI engine ─────────────────────────────────────
    wire        q_start, q_we, q_idle, q_done;
    wire [1:0]  q_cs, q_nbytes_m1;
    wire [23:0] q_addr;
    wire [31:0] q_wdata, q_rdata;

    mem_ctrl memc (
        .clk        (clk),
        .rst        (rst_soc),
        .i_req      (imem_req),
        .i_addr     (imem_addr),
        .i_rdata    (imem_rdata),
        .i_ready    (imem_ready),
        .d_req      (mem_d_req),
        .d_addr     (dmem_addr),
        .d_wdata    (dmem_wdata),
        .d_be       (dmem_be),
        .d_we       (dmem_we),
        .d_rdata    (mem_d_rdata),
        .d_ready    (mem_d_ready),
        .q_start    (q_start),
        .q_cs       (q_cs),
        .q_addr     (q_addr),
        .q_we       (q_we),
        .q_nbytes_m1(q_nbytes_m1),
        .q_wdata    (q_wdata),
        .q_idle     (q_idle),
        .q_done     (q_done),
        .q_rdata    (q_rdata)
    );

    qspi_ctrl qspi (
        .clk      (clk),
        .rst      (rst_soc),
        .rd_late  (qspi_late),
        .start    (q_start),
        .cs_sel   (q_cs),
        .addr     (q_addr),
        .we       (q_we),
        .nbytes_m1(q_nbytes_m1),
        .wdata    (q_wdata),
        .idle     (q_idle),
        .done     (q_done),
        .rdata    (q_rdata),
        .sck      (qspi_sck),
        .cs_n     (qspi_cs_n),
        .ctl_oe   (qspi_ctl_oe),
        .io_out   (qspi_io_out),
        .io_oe    (qspi_io_oe),
        .io_in    (qspi_io_in)
    );

    // ── CLINT ───────────────────────────────────────────────────────────────
    clint clint_inst (
        .clk      (clk),
        .rst      (rst_soc),
        .addr     (dmem_addr[15:0]),
        .wdata    (dmem_wdata),
        .wmask    (dmem_be),
        .we       (clint_sel && dmem_we),
        .rdata    (clint_rdata),
        .timer_irq(timer_irq),
        .sw_irq   (sw_irq),
        .mtime_out(mtime)
    );

    // ── UART ────────────────────────────────────────────────────────────────
    uart #(
        .DIV_RESET(UART_DIV_RESET)
    ) uart_inst (
        .clk  (clk),
        .rst  (rst_soc),
        .sel  (uart_sel),
        .we   (dmem_we),
        .be   (dmem_be),
        .addr2(dmem_addr[2]),
        .wdata(dmem_wdata),
        .rdata(uart_rdata),
        .ready(uart_ready),
        .rx   (uart_rx),
        .tx   (uart_tx),
        .rts_n(uart_rts_n)
    );

    // ── GPIO + SPI controller ──────────────────────────────────────────────
    gpio gpio_inst (
        .clk  (clk),
        .rst  (rst_soc),
        .sel  (gpio_sel),
        .we   (dmem_we),
        .be   (dmem_be),
        .addr (dmem_addr[5:2]),
        .wdata(dmem_wdata),
        .rdata(gpio_rdata),
        .ready(gpio_ready),
        .in   (gpio_in),
        .out  (gpio_out)
    );

endmodule
