alfadelta10010/AlphaOneSoC/tb/formal/spi_core_props.sv

// SPI engine invariants (src/spi.v), proved by k-induction at length 1
// (WO-29 section 7). SPI-006..SPI-012, SPI-015, SPI-017 at the engine.
//
// White-box names, exposed from the committed RTL by run.sh (PRE) and mapped
// from WO-28 2.1 (no other reading of the RTL's behaviour was used):
//   WO-28 name   spi.v name      meaning
//   st           st              IDLE=0 A=1 B=2
//   cc           cc              clocks left in the half period
//   bc           bc              bits left in the byte (7 at a LOAD)
//   bba          bba             holding register full
//   sr, bb       sr, bb          shift register / holding register
//   p_sck,p_mosi p_sck,p_mosi    the pin flops (ports of spi)
//   cpol,cpha,baud               CONTROL / BAUD
//
// All inputs are free except the contract A-G with gpio (assumed here, each
// one asserted back as G1..G6 in spi_bus_props.sv):
//   AC1 at most one register strobe per cycle
//   AC2 wr_tx only when bba = 0
//   AC3 wr_ctl, wr_baud, wr_en, wr_out only when TXE (idle and bba = 0)
//   AC4 en changes only when TXE in the cycle before, or on a reset
//   AC5 en rises only on the edge of a wr_en strobe (and not on a reset)
//   AC6 a wr_en strobe (not on a reset) leaves en = 1
// `armed` is set by the first rst; every state invariant is gated on it, and
// the shadow registers (all reset by rst) make the post-reset state checked
// at the first step.
//   C1  st is IDLE, A or B
//   C2  busy -> cc <= baud
//   C3  en: SCK is A in A, ~A in B, cpol in IDLE (A = cpol ^ cpha)
//   C4  ph + cc = baud while busy; every exit from A or B is at ph = baud
//   C5  nab (A->B edges since the LOAD) = 7 - bc in A, 8 - bc in B; 8 at the end
//   C6  IDLE is entered only from B with cc = 0, bc = 0
//   C7  en: MOSI changes only on a launch (entry into A)
//   C8  sr[7-bc+i] = txs[i] (i <= bc); en: MOSI = sr[7] = txs[bc] while busy
//   C9  accounting: d = writes - LOADs = bba; a LOAD takes the last written byte
//   C10 IDLE with bba loads on the next edge
//   C11 B, cc = 0, bc = 0, bba loads on that edge (no gap)
//   C12 rxs: low 7-bc bits of sr; bb / sr get the completed RX byte
//   C13 an IDLE LOAD writes the old sr into bb
//   C14 since = clocks since the LOAD, closed form; the byte ends at 16(B+1)
//   C15 reset values
//   C16 en = 0, or en = 1 with an OUT strobe: the strobe moves no pin
//   C17 SCK moves only at the listed events
//   C18 not TXE -> baud, cpol, cpha stable
module spi_core_props (
    input  wire       clk, rst,
    input  wire       en, miso,
    input  wire [7:0] wdata,
    input  wire       wr_tx, wr_ctl, wr_baud, wr_en, wr_out
);
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
