alfadelta10010/AlphaOneSoC/(commit log)

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2024-11-04 updated testbench with correct symbos
    [tb_regFile.v]
2024-11-07 trying to fix imm shifts
    [signExt.v]
2024-11-07 it was correct without changes... removed old style
    [signExt.v]
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2026-04-05 Simplified register file and mux31
    Rewrote regFile to use a simple reg array with combinational read and
    synchronous write, removing the previous per-register instantiation
    approach. x0 is hardwired to zero on read. Named-port style throughout.
    Rewrote mux31 from a procedural always block to a single combinational
    assign using ternary operators — cleaner for synthesis and avoids
    inferred latches.
    Register file testbench completely rewritten with negedge-setup timing
    pattern (42 tests). The original testbench had 21 test failures caused
    by a Verilog simulation race: setting write signals at the same posedge
    as the always block meant the register file sometimes saw stale values.
    Switching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
2026-04-05 Rewrote FyraCore as 3-stage pipelined RV32IMCA+Zicsr+Zifencei core
    Complete rewrite of the top-level CPU module from a single-cycle RV32I
    design into a 3-stage pipeline:
    IF — Instruction fetch + RV32C decompression
    EX — Decode, register read, ALU, branch resolution, CSR read
    WB — Memory access, writeback, CSR commit, trap handling
    Pipeline hazard handling:
    - Register data forwarding from WB to EX: when the WB stage writes a
    register that EX reads, the writeback value is forwarded
    combinationally
    to avoid a stall.
    - CSR forwarding: back-to-back CSR write then read (e.g. CSRRWI followed
    by CSRR of the same address) forwards the WB write value to EX, since
    the CSR file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
2026-04-05 Restored memory controller to hardware-calibrated 8MB+8MB address map
    Replaced the 64KB single-range memory map with the original hardware
    address layout that was calibrated to use the full physical QSPI
    address space on the target FPGA:
    Instruction memory: 0x0000_0000 – 0x007F_FFFF (8 MB)
    Data memory: 0x0080_0000 – 0x00FF_FFFF (8 MB)
    GPIO output: 0x0100_0000 – 0x0100_0007
    GPIO input: 0x0100_0008 – 0x0100_000F
    SIM_MODE parameter selects between two generate blocks:
    - SIM_MODE=1: flat 16 MB byte-addressable SRAM array for simulation,
    no QSPI signals driven. Both IM and DM ranges map into the same
    array using dmem_addr[23:0] as the byte index.
    - SI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
2026-04-05 Added linker script and assembly test programs for all extensions
    Linker script (tests/linker.ld) places code at 0x0, data at 0x800,
    and stack at 0xFFF0 within a 64K RAM region. Test programs use the
    convention a0=0 on success, a0=test-number on failure, terminated by
    ECALL.
    Test programs:
    rv32i_basic.S — 31 tests for all base integer instructions: LUI,
    AUIPC, ADDI, SLTI, SLTIU, XORI, ORI, ANDI, SLLI, SRLI, SRAI,
    ADD, SUB, SLT, SLTU, XOR, OR, AND, SLL, SRL, SRA, SW/LW, SB/LB/
    LBU, SH/LH/LHU, BEQ, BNE, BLT, BGE, BLTU/BGEU, JAL, JALR.
    rv32m_test.S — 18 tests for M-extension: MUL, MULH, MULHSU,
    MULHU, DIV, DIVU, REM, REMU, plus edge cases for divide-by-zero,
    si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
2026-04-05 Added build scripts and Makefile for test automation
    Makefile targets:
    make test-alu, test-branchctrl, test-decoder, test-signext,
    test-controller, test-regfile, test-csr, test-compressed
    — individual component testbenches
    make test-components — runs all 8 component testbenches (379 tests)
    make test-cpu — compiles full CPU as a syntax/elaboration check
    make asm FILE=test.S — assembles and runs any .S file through the
    CPU testbench (options: QUIET=1, MAX_CYCLES=N, VCD=1)
    make benchmarks — batch-runs all .S files in tests/ and reports
    pass/fail for each
    make test-all — runs test-components + test-cpu
    make clean — removes build artifacts
    scripts/asm2he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
2026-04-06 Added CSR dual-port interface and address validation
    Split the CSR module from a single addr port into separate raddr
    (read, EX stage) and waddr (write, WB stage) ports. This prevents
    back-to-back CSR instructions to different addresses from conflicting
    on the shared port.
    Added csr_addr_valid output that signals whether raddr maps to a
    supported CSR. This enables the pipeline to trap on accesses to
    non-existent CSRs per the Zicsr spec: "Attempts to access a
    non-existent CSR raise an illegal instruction exception."
    The CSR testbench is updated to use the dual-port interface and
    includes 4 new validity tests covering known-valid, read-only,
    and non-existent CSR addresses.
2026-04-06 Added comprehensive pipeline trap handling, CSR forwarding, and memory handshake
    This commit addresses multiple ISA compliance and pipeline correctness
    issues in the FyraCore pipeline:
    Trap path fixes:
    - Added ifex_c_illegal pipeline register to carry compressed decoder
    illegal flags into EX stage for proper trapping (previously retired
    as NOP)
    - Added SYSTEM instruction field validation: ECALL/EBREAK/MRET now
    verify rd=0 and rs1=0, with ECALL/EBREAK additionally checking
    the rs2 field. Malformed encodings trap as illegal instructions
    - Added CSR access validation: accesses to non-existent CSRs and
    writes to read-only CSRs (address bits [11:10]=11) now trap.
    Read-only operations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
2026-04-06 Added memory ready signals to memController and memory_model
    Both memory backends now provide imem_ready and dmem_ready outputs
    to signal when instruction fetch and data access results are valid.
    In SIM_MODE (memory_model.v and memController SIM_MODE=1), both
    signals are tied to 1 since reads are combinational.
    In QSPI hardware mode (memController SIM_MODE=0), imem_ready is
    driven by ifetch_valid and dmem_ready reflects whether a data
    access is complete. The pipeline uses these to stall when memory
    responses are not yet available.
2026-04-06 Added halt loop termination and memory ready wiring in CPU testbench
    The testbench now supports two program termination mechanisms:
    1. ECALL/EBREAK trap — used by tests without trap handlers. When a
    trap handler is installed (mtvec != 0), ecall/ebreak are treated
    as test instructions handled by the trap handler, NOT as
    termination signals.
    2. Halt loop (j . = JAL x0, 0) — universal termination that works
    with or without trap handlers. The testbench detects the self-jump
    instruction encoding (0x0000006F) and terminates.
    This fixes false-positive test results where the testbench would
    terminate on an ecall that was supposed to be handled by a trap
    handler, before the hand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
2026-04-06 Added pipeline hazard test with 12 test cases
    Exercises the 3-stage pipeline's hazard handling mechanisms:
    Tests 1-3: WB→EX data forwarding on rs1, rs2, and both operands
    Test 4: Load-use stall (lw followed by immediate consumer)
    Test 5: Load→branch (stall then branch on loaded value)
    Test 6: Taken branch flush (post-branch instruction must not execute)
    Tests 7-8: JAL/JALR link register immediate consumer
    Tests 9-10: CSR write→read forwarding (same CSR and different CSR)
    Test 11: Store after taken branch must not execute (flush verification)
    Test 12: Chain of 3 dependent ALU ops (forwarding across 2 boundaries)
2026-04-06 Added atomic extension edge case tests (tests 16-22)
    Extends the RV32A test suite with 7 new edge case tests:
    Test 16: SC.W to different address than LR.W must fail
    Tests 17-18: AMOMIN/AMOMAX with boundary values (0x80000000 vs
    0x7FFFFFFF) verifying correct signed comparison
    Tests 19-20: AMOMINU/AMOMAXU with boundary values (0x00000000 vs
    0xFFFFFFFF) verifying correct unsigned comparison
    Test 21: Reservation invalidated by SB to reserved word
    Test 22: Reservation invalidated by SH to reserved word
    These test reservation tracking corner cases and signed/unsigned
    boundary conditions that the original 15 tests did not cover.
2026-04-08 Replace combinational multiply/divide with iterative multi-cycle unit
    - Add src/muldiv.v: shift-add multiplier + restoring divider FSM
    - 32-cycle multiply, 34-cycle divide, ~1000 gates vs 10000+ combinational
    - Handles all 8 RV32M ops (MUL/MULH/MULHSU/MULHU/DIV/DIVU/REM/REMU)
    - Edge cases: div-by-zero, INT_MIN/-1 signed overflow
    - Strip M-extension operators from src/alu.v (pure RV32I only)
    - Add isMulDiv signal to src/controller.v to route M-ext to muldiv
    - Integrate muldiv into src/fyracore.v:
    - muldiv_start/muldiv_stall wires with correct done-cycle behavior
    - When muldiv_done fires, stall drops so pipeline captures result this cycle
    - Forward-declare exwb_* regs and csr_rdata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
2026-04-08 Populate mtval with faulting address/instruction on traps
    - fyracore.v: add exwb_trap_val pipeline register
    - Misaligned load/store: mtval = ex_alu_result (faulting address)
    - Illegal instruction: mtval = ifex_instr (faulting encoding)
    - ECALL/EBREAK: mtval = 0 (per spec)
    - Wire exwb_trap_val to csr_unit.trap_val (was hardcoded 32'b0)
    - tests/trap_test.S: add tests 14-15 to verify mtval correctness
    - Test 14: misaligned LW → mtval = faulting address (0x1001)
    - Test 15: 32-bit illegal instruction → mtval = instruction encoding
    - Trap handler updated to save mtval into s5 for verification
    All 15 trap tests pass (a0=0).
2026-04-08 Add U-mode privilege support with CSR access control
    - Add priv_mode register (1=M, 0=U), resets to M-mode
    - Trap entry always switches to M-mode; MRET restores from mstatus.MPP
    - ECALL cause is 11 from M-mode, 8 from U-mode
    - CSR access with addr[9:8] != 00 traps as illegal from U-mode
    - mcounteren (0x306) gates U-mode access to cycle/instret counters;
    U-mode reads when the corresponding bit is 0 trap as illegal
    - Add umode_test.S: 5 tests covering M/U switch, ECALL cause,
    M-mode CSR denial, and mcounteren allow/deny for counters
2026-04-09 Add CLINT, timer/external/software interrupts, and WFI
    - src/clint.v: New SiFive-compatible CLINT module. Implements mtime
    (64-bit, increments every cycle), mtimecmp, and msip registers at
    offsets 0x0000/0x4000/0x4004/0xBFF8/0xBFFC from base 0x0200_0000.
    Outputs timer_irq (mtime>=mtimecmp) and sw_irq (msip[0]).
    Single always block for mtime avoids two-driver races; initial blocks
    ensure defined simulation start state.
    - src/csr.v: Add timer_irq/external_irq/sw_irq input ports. mip reads
    return live wire values for MTIP(7), MEIP(11), MSIP(3) bits rather
    than stored register. Add mie_out output port for per-bit IRQ gating
    in fyracore.
    - src/fyracore.v: Add timer_irq/external_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
2026-04-09 Add FENCE.I memory flush signal and remove unused utility modules
    7A — FENCE.I flush signal:
    - src/fyracore.v: Add fencei_flush output port, asserted for one cycle
    when a FENCE.I instruction executes in the EX stage (not stalled).
    Critical for self-modifying code and kernel module loading on Linux.
    - src/memController.v: Add fencei_flush input port; in hardware QSPI
    mode, assert invalidates ifetch_valid so the next fetch is forced
    back to QSPI rather than returning the stale buffered word.
    - tb/tb_cpu.v: Wire fencei_flush from CPU (informational in sim, as
    the memory_model has no instruction fetch buffer to invalidate).
    7B — Remove unused utility modules:
    - adder.v, and2.v, mu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
2026-04-09 Fix critical spec violations in privilege, interrupt, PMP, and CSR handling
    - MRET from U-mode now traps as illegal instruction (was privilege escalation)
    - U-mode interrupts no longer gated by MIE (spec §3.1.6.1)
    - Fix IRQ MPP save race: remove early priv_mode update on irq_inject so
    CSR unit reads correct pre-trap privilege for MPP
    - CSR forwarding now masks mstatus through writable-bit mask (0x1888)
    - AMO PMP access type changed from W-only to R+W (3'b011)
2026-04-10 Add CLINT to hardware-mode memController and fix Makefile SRC_FILES
    - Instantiate CLINT inside hw_mem generate block (SIM_MODE=0) so timer
    and software interrupts work on real hardware, not just simulation
    - Add in_clint_range decode (0x0200_0000-0x0200_BFFF); CLINT accesses
    are single-cycle on-chip, bypassing QSPI FSM entirely
    - Route CLINT reads into dmem_rdata mux, writes via combinational we
    - Add hw_timer_irq/hw_sw_irq output ports (tied off in sim mode where
    CLINT lives in memory_model.v)
    - Fix Makefile: remove stale legacy module references (adder, and2,
    mux21, mux31, or2), add clint.v
2026-04-11 Fix mcycle/minstret dual-driver synthesis failure
    Merge counter auto-increment and CSR write logic into single always
    blocks per counter. Two always blocks driving the same register is a
    synthesis error. Write-takes-priority ensures CSR writes override the
    auto-increment in the same cycle.
2026-04-11 Fix trap cause priority to match spec Table 3.7
    Move instruction access fault (cause 1) to highest priority in the
    trap cause if-else chain. Previously ecall/ebreak were checked first,
    so a PMP ifetch fault on an ECALL instruction would report the wrong
    cause.
2026-04-11 Fix CSRRS/CSRRC with rs1=0 performing spurious CSR write
    Gate exwb_csrWR with ex_csr_writes which is false when rs1/uimm=0 for
    CSRRS/CSRRC/CSRRSI/CSRRCI. The spec mandates no write in this case,
    and the spurious write interfered with counter auto-increment logic.
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2026-04-11 Forward mstatus MIE from WB stage for interrupt gating
    Without forwarding, a csrci that clears MIE takes effect one cycle
    late, allowing a spurious interrupt to slip through. Forward the
    pending MIE value from the WB CSR write to close the window.
2026-04-11 Fix csr_new forward reference error in counter always blocks
    Move csr_new wire declaration before the mcycle/minstret always blocks
    that reference it. Iverilog rejects wire forward references inside
    always blocks, causing 4 elaboration errors. Split the declaration
    from the assign to resolve ordering.
2026-04-11 Fix trap_target forwarding missing mtvec WARL mask, fix tb_csr ports
    trap_target used raw exwb_csr_wdata when forwarding mtvec from WB,
    bypassing the [1:0]=00 direct-mode mask. If software wrote mtvec with
    mode bits set and a trap fired in the next cycle, the CPU would jump
    to a misaligned address. Now masks [1:0] to match csr.v write behavior.
    Also connected previously-unconnected ports in tb_csr.v: priv_mode,
    timer_irq, external_irq, sw_irq, and the new mtime_in input.
2026-08-05 Wire RISCOF (riscv-arch-test) generator into FyraCore verification
    Adds the RISCOF compliance suite as a river_core generator alongside
    riscv_tests. 158/176 tests now pass (75 riscv_tests + 83 arch-test);
    remaining 18 failures are misalign/ebreak/clui DUT trap-handling gaps,
    not wiring issues.
    * plugins/generator_plugins/riscof_plugin/: river_core generator that
    clones riscv-arch-test at run time and drives `riscof testlist`.
    Linker script now sourced from the DUT env dir (no more hardcoded
    FyraCore boot.bo / _boot_start stub). Emits ignore_lines=5 per entry
    so the spike plugin strips the 5 bootrom retires from ref.dump.
    * plugins/riscof_plugins/fyracore/: minimal RISCOF DUT plugin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
2026-09-05 fix(rvc): decode C.LUI with rd=x0 as a HINT, not illegal
    The RVC chapter of the unprivileged spec defines C.LUI as: nzimm=0 is
    reserved for every rd; rd=x2 is C.ADDI16SP; and the remaining code points
    with rd=x0 are HINTs. The decoder was raising an illegal-instruction
    exception for rd=x0 instead of expanding it.
    Expand it like any other C.LUI. The result is LUI x0, nzimm, which retires
    with no architectural effect because the register file already suppresses
    writes to x0.
    riscv-arch-test clui-01 exercises this directly (c.lui x0, 0x1 at line 132
    of the generated test) and now matches the Spike reference trace exactly.
    Claude-Session: https://claude.ai/code/session_01HDhRmPTJN2ABqWmpikc1B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
2026-09-05 fix(trap): write the EBREAK address to mtval on a breakpoint trap
    mtval was left at 0 when a breakpoint exception was raised. The privileged
    spec requires mtval to hold the address of the breakpoint instruction
    itself, which is what Spike writes.
    Use ifex_pc, the EX-stage PC of the trapping instruction, so the 2-byte
    C.EBREAK and the 4-byte EBREAK are handled identically.
    riscv-arch-test ebreak and cebreak-01 both now match the Spike reference
    trace exactly.
    Claude-Session: https://claude.ai/code/session_01HDhRmPTJN2ABqWmpikc1By
2026-09-05 fix(tb): emit the AMO store marker in the trace, matching Spike
    The memory marker was written as `if (exwb_memRD) ... else if (dmem_we)`,
    which are mutually exclusive. An AMO reads and writes in the same retire, so
    only the read marker was ever emitted. Spike logs both on one line:
    mem 0x80003114 mem 0x80003114 0x77ffffff
    This was not caught by the comparison because river_core's compare_dumps
    pairs the change tokens two at a time; the reference line has an odd token
    count, so zip() silently discarded the trailing store value and both sides
    normalised to the same dict. An AMO computing or writing the wrong value
    would have compared equal on all 19 atomics tests.
    Emit the write marker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
2026-09-05 chore(agents): pin agent memory to an absolute path outside build/
    Both agents declare `memory: project`, which resolves relative to the
    current working directory. Both routinely cd into build/ during normal work
    — the reviewer to reproduce tests, the area optimiser to run synthesis — so
    their notes were written to whichever .claude/ was nearest.
    The design reviewer's findings from a full review landed in
    build/mywork/riscof/riscv-arch-test/.claude/agent-memory/. That path is
    inside the riscv-arch-test clone, which river_core generate deletes and
    re-clones on every run; it was already wiped once mid-review.
    State the absolute destination in each agent's memory-maintenance section,
    alon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
2026-09-05 docs(review): record design-reviewer findings from the 2026-09-05 review
    Notes rescued from the riscv-arch-test clone before the next
    river_core generate would have deleted them.
    Two are tapeout blockers, both confirmed by reading the RTL paths:
    - finding_wb_stall_drops_memory_op: wb_mem_stall feeds stall, and the stall
    arm of the EX/WB update clears exwb_valid/memRD/memWR. The stall condition
    then self-clears and the access is never retried, so a store is lost.
    wb_regWR has no dmem_ready qualifier, so a load also writes back during
    the not-ready cycle. Invisible today because memory_model.v hardwires
    imem_ready = dmem_ready = 1; fatal against external QSPI and PSRAM.
    - finding_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
2026-09-05 feat(verif): wire the rrag random-assembly generator into the flow
    Adds rrag (Random RISC-V Assembly Generator) as a third river_core
    generator alongside riscv_tests and riscof, to get constrained-random
    instruction streams rather than only directed suites.
    Plugin is from the upstream river_core plugin set (BSD-3, same as
    river_core itself).
    base_config.yaml is adapted for FyraCore: delegation is set to 0x0 because
    this is an M+U hart with no S-mode, so medeleg/mideleg are not implemented
    and rrag's default 0xfff would emit a prologue that traps illegal.
    code_start_address 0x80000000 already matches RESET_PC, and the signature
    window at 0x80091000 falls inside the 32 MB simulated memory. T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
2026-09-05 chore: pin the project to the rivercore pyenv
    Without a .python-version, the river_core and riscof shims resolve to
    whatever pyenv global happens to be, which is a different interpreter with
    different package versions. Pin it so the verification flow runs against
    the intended environment by default.
    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
2026-09-05 chore: pin the verification toolchain with a full requirements freeze
    river-core 1.9.7 declares ruamel.yaml>=0.16.0 with no upper bound, and
    ruamel 0.19 removed the module-level dump() that river_core/utils.py calls
    when it writes result_list.yaml. The result is a run that executes every
    test, passes, and then dies while saving results — leaving result_list.yaml
    empty and the HTML report showing every test as unavailable, which reads as
    a total failure rather than a clean pass.
    Freeze the whole set, ruamel.yaml==0.17.40 included, so the environment is
    reproducible and that failure mode cannot come back on a fresh install.
    Claude-Session: https://claude.ai/code/session_01HDhRmPTJN2ABqWmpi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
2026-09-05 feat(verif): allow rrag to be invoked from outside river_core's environment
    rrag is not on public PyPI, so it may not be installable into the same
    virtualenv river_core runs from. It is only ever used as a subprocess CLI
    and never imported, so it does not need to share the interpreter.
    Add an optional `rrag_path` key to [rrag]. When set, the plugin uses that
    executable for isa-update, setup, randomise-configs and every `rrag gen`
    command, and fails early with a clear message if the path is not executable.
    When unset the behaviour is unchanged and `rrag` is taken from PATH. The
    value is threaded to gen_framework through a new --rrag pytest option.
    Left commented out in river-config.ini: rra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
2026-09-05 fix(verif): tell Spike the core has 4 PMP regions, not 8
    Both [spike] and [riscv_tests] declared pmp_regions = 8. The RTL implements
    4: csr.v backs pmpcfg0 and pmpaddr0-3 with real registers, pmpcfg1-3
    (0x3a1-0x3a3) and pmpaddr4-15 (0x3b4-0x3bf) read as zero, and pmp.v is
    instantiated with exactly pmpcfg0 + pmpaddr0-3 for both the fetch and the
    load/store checker.
    With the reference model configured for twice as many regions as the DUT,
    any generated test that programs pmpcfg1 or pmpaddr4 upward would diverge:
    Spike would honour the entry, FyraCore would read back zero. Nothing in the
    current directed suites does that, so it has been latent -- but rrag and
    riscv-dv both generate CSR writes,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
2026-09-05 fix(verif): link rrag tests at the verification base so they actually run
    The rrag generator is the only user of plugins/helpers/link.ld, and that
    script placed code at the hardware memory map: flash at 0x0, RAM at
    0x0100_0000. The verification flow runs the core with RESET_PC = 0x8000_0000
    and the DUT plugin converts the ELF with
    objcopy -O verilog --change-addresses=-0x80000000
    so an image linked at 0x0 shifts to 0x8000_0000 and $readmemh rejects it:
    ERROR: ... address (0x80000000) is out of range [0x0:0x1ffffff]
    Spike could not load it either ("Memory address 0x4960 is invalid"), since
    it expects the payload at its DRAM base. Both dumps therefore came out
    empty, and an empty-v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
2026-09-05 feat(verif): raise rrag stimulus to what the RTL actually supports
    The stock base_config left most of the generator switched off. Three changes,
    each set from what FyraCore implements rather than from defaults:
    * exception-generation had every cause at 0, so the random generator produced
    no trap-path stimulus at all. Weighted across the nine synchronous causes
    the core can raise (1, 2, 3, 4, 5, 6, 7, 8, 11). Cause 0 is left at 0
    because misa.C=1 means IALIGN=16 and the RTL gates ex_inst_misalign on
    !misa_c, so instruction-address-misaligned is unreachable. Note rrag's
    `randomise-configs` re-rolls these weights per config, so the values here
    are a starting point rather than a pin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
2026-09-06 feat(verif): add a riscv-dv generator plugin using upstream's pyflow backend
    Drives upstream chipsalliance/riscv-dv through pyflow, its Python/PyVSC
    generator. That avoids the stock SV/UVM flow, which needs VCS, Questa or
    Xcelium -- Verilator cannot run UVM. The only extra dependency is pyvsc.
    Not derived from the plugin in the reference tree: that one does
    `from test_gen import generate_test` against `riscv-dv/euvm/build/` at module
    import, and that file exists only in a downstream fork, not upstream.
    Mechanics worth recording, all of which cost time to find:
    * pyflow imports its target as a module -- riscv_instr_gen_config.py does
    import_module("pygen_src.target." + target + ".risc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
2026-09-06 fix(verif): pick a riscv toolchain that exists for riscv-dv tests
    The plugin emitted riscv{XLEN}-unknown-elf-gcc, which for an rv32 ISA means
    riscv32-unknown-elf-gcc. Only the riscv64 multilib toolchain is installed
    here, so every riscv-dv test failed at the compile step -- all six in the
    current regression -- while the riscof and rrag plugins were unaffected
    because they name riscv64 directly.
    An rv32 ISA does not imply an rv32 toolchain: riscv64-unknown-elf-gcc builds
    rv32 correctly given -march/-mabi, which the entries already carry. Probe for
    an available compiler instead, preferring the xlen-matching name, and fail
    with a clear message if none is found rather than emitting a command th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
2026-09-07 fix(verif): patch upstream pyflow so riscv-dv can generate tests at all
    Before this, 1 of 13 riscv-dv streams generated. Now 12 of 13 do, and every
    generated .S assembles cleanly. Seven more defects in upstream pyflow on top of
    the three already carried, all documented with file:line in patches/README.md.
    Root cause of the SolveFailure that blocked most streams: get_rand_instr()
    builds a disallowed_instr list and never applies it. The SystemVerilog original
    constrains the draw with !(name inside {disallowed_instr})
    (src/isa/riscv_instr.sv:230-232); the Python else branch just calls
    random.choice(allowed_instr). C_ADDI16SP therefore stays in the pool, and its
    own constraint pins rd == SP whi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
2026-09-07 perf(tb): drop the duplicate 32 MB memory zero-fill
    memory_model.v already zero-fills all MEM_SIZE bytes in its own initial block
    before applying any compile-time INIT_FILE. tb_rivercore.v ran a second
    33.5M-iteration fill over the same array on every simulation.
    Removing it takes a no-op run from 24.9s to 14.6s: a 41% cut in the fixed
    startup cost paid by every test in the regression.
    The program load moves to #1 rather than time 0. Verilog does not define the
    relative order of initial blocks across modules, so loading at time 0 risked
    memory_model's fill running afterwards and erasing the program. #1 is strictly
    after every time-0 initial block, and reset is held until #25, so the core h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
2026-09-07 feat(verif): re-enable the twelve riscv-dv streams the pyflow patches unblocked
    All twelve generate and assemble cleanly with patches 01-10 applied. Iteration
    counts are weighted toward the streams most likely to find something:
    riscv_rand_instr_test at 8 for breadth, riscv_illegal_instr_test at 6 because
    the RTL resolves illegal-instruction last in its exception priority chain
    against Table 3.7 of the privileged spec.
    riscv_pmp_test stays at 0. pyflow implements none of the --pmp_* options and
    argparse rejects them outright, so PMP stimulus is unavailable from this
    generator as a missing feature rather than a defect.
    Claude-Session: https://claude.ai/code/session_01HDhRmPTJN2ABqWmpikc1By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
2026-09-07 fix(tb): raise the spin-abort threshold to 100000 retires
    20000 was tight enough to risk cutting short a legitimate wait. A test may
    park in a self-loop waiting for a timer or external interrupt --
    riscv_full_interrupt_test is the obvious candidate -- and aborting that would
    convert a passing test into a failure, which is far worse than letting a slow
    test be slow.
    100000 is still an order of magnitude below MAX_CYCLES, so a genuine hang is
    caught long before the timeout, and the dump stays bounded at roughly 4 MB
    instead of 21 MB. No plausible interrupt wait retires the same PC 100000 times
    consecutively.
    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
2026-09-07 fix(verif): correct 18 wrong CSR addresses in riscv-dv's privileged_reg_t
    Checked against src/riscv_instr_pkg.sv in the same checkout and against the
    privileged spec; the SystemVerilog enum is right and the Python port is not.
    * MCOUNTINHIBIT = 0x320F, should be 0x320. That is not a 12-bit CSR address,
    so any instruction generated for it fails to assemble. FyraCore implements
    mcountinhibit (src/csr.v, 12'h320), so this is on the live path.
    * MHPMCOUNTER16H..MHPMCOUNTER31H are each one too low, 0xB8F..0xB9E instead
    of 0xB90..0xB9F: an omitted entry shifted the block, so every name in it
    denotes its predecessor's register.
    * SCONTEXT = 0x7AA, should be 0x5A8. 0x7AA is fr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
2026-09-07 fix(verif): stop riscv-dv aiming load/store streams at reserved registers
    src/riscv_load_store_instr_lib.sv:54-56 constrains the base register of every
    load/store stream:
    constraint rs1_c {
    !(rs1_reg inside {cfg.reserved_regs, reserved_rd, ZERO});
    }
    The port left it commented out with a TODO, so nothing stopped the solver
    picking a register the stream must not touch:
    * rs1_reg == ZERO emits `la zero, region_1+3609`, which the assembler
    rejects -- the entire program is lost.
    * rs1_reg in cfg.reserved_regs, which is {cfg.tp, cfg.sp, cfg.scratch_reg}
    and whose members are themselves randomized per program, rewrites the
    register holding the stack pointer, thread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
2026-09-07 docs(verif): correct the riscv-dv testlist status header
    The header described a state that no longer holds: that only
    riscv_arithmetic_basic_test generated, that everything else died in a PyVSC
    SolveFailure, and that "the iterations below are therefore set to 0" -- which
    had not been true of the twelve enabled entries for some time.
    Record what actually blocked the flow instead: not the generator, but
    process_regression_list() queueing both the imported base_testlist entry and
    the local override for each test, so the upstream copy ran first and ate the
    whole generation budget. Also spell out why riscv_csr_test stays at 0: it comes
    from scripts/gen_csr_test.py and needs a YAML model of every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
2026-09-07 feat(verif): add a per-stream assemble check for riscv-dv output
    Generation exiting 0 is not evidence that a test is usable. pyflow decides
    which access widths are legal from its own model of the address it is about to
    emit, and picked base registers without applying the constraint saying which
    registers it may touch. Both produced programs that generated cleanly and then
    would not assemble:
    Error: illegal operands `c.swsp t2,23(sp)'
    Error: illegal operands `la zero,region_1+3609'
    Those stay silent until the compile stage, where they read as a toolchain
    problem rather than a generator one. This runs straight after `river_core
    generate` and attributes them correctly, per stream.
    It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
2026-09-08 fix(verif): pass instr_cnt explicitly for every riscv-dv stream
    pyflow's argparse default for --instr_cnt is 200, and patch 07 removed the
    `cfg.instr_cnt = 10000` that riscv_rand_instr_test.randomize_cfg() applied.
    test/riscv_instr_test_lib.sv:24 still does it, so that removal was a deviation
    from the oracle, not a restoration of it.
    Six entries relied on the default and got main_program_instr_cnt of ~193
    instead of ~9800. Two of them were silently producing nothing:
    insert_illegal_hint_instr() computes int(instr_cnt * ratio / 1000), which
    floors to zero at that size, so riscv_illegal_instr_test injected no illegal
    instructions and riscv_hint_instr_test no HINTs -- in every program, while
    s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
2026-09-08 fix(verif): disable the two riscv-dv streams that inject nothing
    riscv_illegal_instr_test and riscv_hint_instr_test draw from riscv_illegal_instr,
    whose constraint model is unsatisfiable under the installed pyvsc:
    insert_illegal_hint_instr() discards every draw and the generated program
    contains no illegal encodings and no HINTs at all.
    Measured directly rather than inferred: an unconstrained
    riscv_illegal_instr.randomize() fails 200/200 for this target, and 50/50 on the
    stock rv32imc and rv32i targets, so it is a pyflow/pyvsc incompatibility rather
    than anything about this core. pyvsc cannot produce an unsat core for it either
    ("internal error: system should solve").
    Patch 09's retry is s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
2026-09-09 fix(verif): set ignore_lines=5 for rrag
    Spike emits 5 bootrom instructions (0x1000-0x1010, ending in the jr to
    --pc) before reaching the program; the DUT starts directly at the reset
    PC. rrag never set ignore_lines, so it took river_core's schema default
    of 4 and one bootrom instruction survived at the head of every ref.dump,
    shifting the whole trace by one line.
    Every other generator plugin here already sets 5. Verified against this
    Spike build by tracing a minimal ELF linked at 0x80000000: the prologue
    is exactly 0x1000, 0x1004, 0x1008, 0x100c, 0x1010.
    Claude-Session: https://claude.ai/code/session_019j9wmoS4yeLwD1JNWAfPAa
2026-09-09 fix(verif): give each riscv-dv test its own work_dir
    work_dir was dirname(asm_file), and every iteration of a stream is
    generated into the same asm_test/ directory. So all N iterations of a
    stream shared one work_dir, and river_core writes dut.dump and ref.dump
    there -- each iteration overwrote the previous one's dumps.
    With 50 programs across 11 streams, 39 were generated, built, simulated
    and then silently clobbered; only 11 results survived to be compared.
    It was worse in the reference stage: several Spike processes wrote the
    same ref.dump concurrently and the file grew without bound, reaching
    tens of gigabytes at ~1.85 GB/min before being killed by hand.
    Claude-Session: https://claude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
2026-09-09 fix(verif): repair the ConfigParser access in the DUT post_run hook
    post_run read space_saver with config.get('river_core', {}).get(...),
    treating the ConfigParser like a dict. ConfigParser.get takes the option
    name as its second argument, so the {} was passed to optionxform and
    every run ended in:
    AttributeError: 'dict' object has no attribute 'lower'
    This fired after the comparison, so result_list.yaml and failed_list.yaml
    were already written -- but post_run runs before generate_report, so the
    final HTML report was never produced and river_core always exited with a
    traceback. The Spike reference plugin already indexes the section first;
    match it.
    Claude-Session: https://claude.ai/c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
2026-09-09 fix(verif): correct riscv-torture's ignore_lines for this Spike
    The p-mode entries skipped 4 leading ref.dump lines and the v-mode
    entries 13, leaving one Spike bootrom instruction at the head of every
    reference trace and shifting the whole comparison by one line.
    Verified by tracing a minimal ELF linked at 0x80000000 through this
    Spike build: the prologue is exactly five instructions, 0x1000, 0x1004,
    0x1008, 0x100c and 0x1010, the last being the jr to --pc. The v-mode
    figure is that prologue plus the same 9 setup instructions the previous
    value already accounted for.
    This is the last generator plugin still on the old counts; riscv_tests,
    riscof, rrag and riscv_dv all use 5 (and 14 for v-m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
2026-09-09 fix(verif): import signal in the riscv-torture generator framework
    This module has its own copy of sys_command, and its TimeoutExpired
    handler calls os.killpg(pgrp, signal.SIGTERM) without signal ever being
    imported. Every generation that hit the timeout raised NameError from
    inside the except block instead of killing the process group, so the
    real failure was masked and the sbt process was left running.
    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
2026-09-09 fix(verif): pin the riscv-tests checkout
    The clone tracked whatever master happened to be, and because it is
    skipped whenever the directory already exists, a machine keeps the
    revision it first cloned forever. Two machines could therefore sit on
    different commits indefinitely while both reporting a "full riscv_tests
    run", with no way to tell from the results which test set was used.
    gen() derives the test set from the isa/rv32* directory names and each
    directory's Makefrag, so an upstream reshuffle changes what is run.
    Pinned to the revision the current results were produced against; a
    fresh clone at this pin yields the same 75 tests, and the machines in
    use are already on it, so nothing c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
2026-09-09 fix(verif): bound spike, not gcc, with the run timeout
    The timeout prefixed compile_cmd, which ends in '&&', so `timeout N`
    applied to riscv64-unknown-elf-gcc -- a second's work -- and spike then
    ran unbounded:
    cd <wd> && timeout 605 gcc ... -o test.elf && spike --log ref.dump ...
    Seven generated riscv_dv programs never terminate under spike. Their
    processes survived the compile stage crashing, kept running for 8+ hours
    with nothing to reap them, and wrote 777 GB of partial traces until the
    disk was full, which killed the comparison stage.
    Move the timeout onto the simulator and add -k 10s, matching how the
    fyracore_iverilog DUT plugin already wraps vvp.
    Claude-Session: https://claude.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
2026-09-09 fix(verif): cap river_core's comparison log so a run can finish
    river_core's own comparison has never completed on this suite. Two
    defects in river_core/utils.py, neither fixable from this repo because
    river-core is pinned to a PyPI release, so ship an idempotent patch
    script to apply after `pip install -r requirements.txt`.
    1. sys_command() resolves os.getpgid(process.pid) in its TimeoutExpired
    handler *after* process.kill() and process.communicate() have reaped
    the child. The ProcessLookupError escapes the multiprocessing.Pool
    worker and aborts every verdict in the run, not just the one test.
    2. compare_dumps() builds its diagnostic string without bound: it starts
    from the en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
2026-09-10 fix(verif): bound the size of the reference trace
    The run timeout fixed in d402fab stops a non-terminating spike, but not
    soon enough. Re-running riscv_loop_test_0 -- one of the seven programs
    that never terminate -- shows ref.dump reaching 16 MiB in under a
    second, so a 600 s timeout still permits a multi-GB trace per test, and
    seven of them wrote 777 GB between them on 2026-09-09.
    Wrap the spike invocation in a subshell with `ulimit -f`. Exceeding it
    kills spike with SIGXFSZ and leaves a truncated ref.dump, which the
    comparison stage reports as a failure: a bounded loss instead of a full
    disk that takes the whole regression with it.
    The limit is max_dump_mb, default 512 MiB, 0 disables.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
2026-09-10 fix(verif): keep the testbench's diagnostics instead of discarding them
    The DUT simulation ran with `1> /dev/null`, which threw away everything
    tb_rivercore.v reports about how the run ended:
    --- Max cycles (%0d) reached ---
    ERROR: spinning at PC 0x%08h (same PC retired %0d times), aborting
    ERROR: no program loaded at reset PC from INIT_FILE=%0s
    The last of those is followed by $fatal(1) and is commented in the
    testbench as something that "must fail loudly" -- it was silent.
    A run cut off by MAX_CYCLES leaves a truncated dut.dump, which the
    comparison stage cannot distinguish from a genuine trace divergence.
    The one line that says which it was is exactly what /dev/null ate. This
    is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
2026-09-10 fix(verif): make the DUT retire budget configurable
    MAX_CYCLES was hardcoded at 1000000 in the plugin's vvp invocation, so
    the only way to change the retire budget for a run was to edit Python.
    It is the knob that decides how much of a non-terminating test gets
    simulated, and at 1e6 retires a runaway produces a ~50 MB dut.dump,
    so it wants to be reachable from the config.
    Read it from the [fyracore_iverilog] section, defaulting to the current
    1000000 so behaviour is unchanged. Guarded with .get() so an older
    river-config.ini without the key still works.
    Claude-Session: https://claude.ai/code/session_01DznpUxDT5W666v4chkeSiQ
2026-09-10 fix(verif): bound the size of the DUT trace
    Companion to f4b501d, which did the same for the reference side. A core
    that never terminates writes dut.dump until the disk is full; MAX_CYCLES
    bounds the retire count but nothing bounds the file, and a single test
    in the last run reached 51 MB.
    Wrap the vvp invocation in a subshell with `ulimit -f`, limit set by
    max_dump_mb (default 512 MiB, 0 disables). Exceeding it kills vvp with
    SIGXFSZ and leaves a truncated dut.dump, which the comparison stage
    reports as a failure -- a bounded loss rather than a full disk.
    Verified under /bin/sh, the shell make runs recipes with: max_dump_mb=1
    capped dut.dump at exactly 1048576 bytes with vvp exiting 153.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
2026-09-10 refactor(verif): make patch-river-core.py idempotent per edit
    The script checked whether the file was patched by testing for two
    sentinels from the first two edits, then applied all edits or none. That
    works exactly once: adding a new fix to the list leaves it unreachable on
    any environment already carrying the earlier ones, because the sentinel
    check short-circuits and reports "already patched".
    Check each edit on its own -- skip the ones whose replacement text is
    already present, apply the rest -- and report both sets. No change to
    what a pristine install ends up with.
    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
2026-09-10 fix(verif): guard compare_dumps' remove('mem') against ValueError
    river_core's compare_dumps normalises a commit's change field by
    dropping the literal token 'mem' whenever the token count is odd:
    if len(change1) % 2:
    change1.remove('mem')
    list.remove raises ValueError when the item is absent. An odd token
    count with no 'mem' token therefore throws, and the exception escapes
    the multiprocessing.Pool worker and aborts every verdict in the run
    rather than just that test -- the same failure class as the
    ProcessLookupError already patched here, which is what stopped the
    comparison stage completing at all.
    Add the membership test. Verdicts are unchanged where 'mem' is present,
    whic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
2026-09-10 fix: fault on unmapped addresses instead of aliasing them
    The simulation memory answers every address: tb/memory_model.v indexes
    its 32 MB array with addr[24:0], so all 4 GB alias into it and there is
    no bus-error path. Spike, given no -m at all, used its own default of
    2048 MiB at DRAM_BASE 0x80000000. The two models therefore disagreed
    about which addresses exist, and that single disagreement caused 884 of
    the 887 rrag failures in the 2026-09-09 run.
    The chain, identical on both models for 482 lines: random code reaches
    PC 0xFFFFFFFE, both raise illegal instruction with mepc=0xFFFFFFFE, the
    handler steps past the faulting instruction, 0xFFFFFFFE + 2 wraps to 0,
    MRET returns to PC 0. There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
2026-09-10 fix(verif): cut both traces at the tohost write
    All 50 riscv_dv tests failed for a reason that is not a divergence. The
    programs end with
    write_tohost: auipc x30, 1
    sw x29, tohost(x30)
    c.j write_tohost
    an intentional spin that expects the simulator to notice the store and
    stop. The DUT's testbench stops on it at once. Spike polls HTIF only
    every INTERLEAVE (5000) instructions, so it keeps spinning first.
    Measured on riscv_ebreak_test_0: the tohost store is at line 202 of
    *both* dumps, dut.dump ends at 206 lines, and ref.dump runs to 5121
    containing 1640 copies of that same store. The two models agree on every
    architectural fact and disagree onl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
2026-09-10 fix: give the core the SoC's real address map, remap in the testbench
    e31f4df added the PMA check but took its defaults from the verification
    flow, so fyracore's idea of the address map was Spike's, not the SoC's.
    Instantiated anywhere but tb_rivercore.v it would fault on every access
    to Flash at 0x00000000 and RAM at 0x01000000 -- the machine actually
    being built.
    Default to the real map, matching src/memController.v and
    docs/FyraCore_CPU_Reference.md:
    0x0000_0000 - 0x00FF_FFFF Flash 16 MB XIP code (QSPI CS0)
    0x0100_0000 - 0x01FF_FFFF RAM 16 MB stack/heap/.data (QSPI CS1)
    0x0200_0000 - 0x0200_BFFF CLINT 48 KB
    0x0300_0000 - 0x0300_000F GPIO 16 B
    Flash and RAM are cont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
2026-09-10 fix(verif): hand the DUT its retire budget
    Wire +MAX_INSTR through from the config so c56d5ee's retire budget is
    reachable without editing the testbench, and raise the cycle backstop
    default to 3,000,000 to match.
    max_instr is the bound that normally fires. max_cycles stays only as the
    backstop for a hung pipeline that retires nothing, which an instruction
    bound can never catch.
    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
2026-09-10 fix(verif): stop spike on the same instruction as the DUT
    The two models were bounded by different things entirely: the DUT by its
    retire budget, spike only by the ulimit that caps ref.dump. For a
    non-terminating program that meant a 200k-line dut.dump against a 512 MiB
    ref.dump -- not a divergence, just two different stopping rules.
    spike supports --instructions=<n>. Measured against this build, it yields
    exactly n logged lines and counts the boot ROM prologue, so the value
    passed per test is max_instr + that test's ignore_lines and the prologue
    is stripped afterwards as before.
    Verified on riscv_loop_test_1, the infinite-loop case:
    before dut 249,993 lines ref 536,870,658 bytes (5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
2026-09-10 fix(verif): tighten the dump size cap to 64 MiB
    512 MiB was chosen before the retire budget existed, when a
    non-terminating program could only be stopped by running out of file
    quota. With ab7bc82 bounding both models at 200,000 retires, the largest
    dump either side can now produce is far below that: the biggest
    legitimate ref.dump in the suite is 3.7 MB, and a 200k-retire dump
    measures ~9 MB.
    64 MiB keeps ~7x headroom over anything observed while removing the
    worst of the compile stage's tail. Previously each capped reference cost
    four sed -i passes plus an awk over 512 MB, single-threaded, then a
    diff -iw against it -- which is why the machine went quiet with one core
    pegged near the end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
2026-09-12 fix(tb): fail loudly when a run hits its retire or cycle budget
    Both watchdogs and the spin detector end in $finish, i.e. exit status 0,
    and leave a dut.dump that is simply short. Since the reference is bounded
    at the same retire count, a program that never terminates produced two
    equally truncated traces, which compared equal and were reported as
    Passed. That is true as far as it goes -- 200,000 retires did match --
    but it is not what a pass is read to mean, and five of the fifty riscv-dv
    programs are in exactly that state.
    Append a DUT-ABORT line to the dump instead. river_core's compare_dumps
    parses every differing line with its commit-log regex and already treats
    a line it cannot parse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
2026-09-12 fix(tb): emit the AMO store marker only when the store happens
    The marker was printed from the decode alone -- exwb_isAmo && amo_phase --
    so the dump recorded the value the core intended to write whether or not
    the write reached the bus. A dropped AMO store would still have matched
    Spike line for line, which is precisely the failure the trace exists to
    catch, and the WB-stall defect can drop exactly that store.
    Gate it on dmem_we. Measured on two rrag programs: the AMO line count is
    unchanged (67 and 116), so the marker still fires on every real store.
    Claude-Session: https://claude.ai/code/session_01XZ2tQzws4U4jwEJufNgrkb
2026-09-12 fix(verif): bound the reference by trace lines, not --instructions
    Spike's --instructions is not a retired-instruction budget. sim_t::idle()
    charges a whole INTERLEAVE (5000) chunk per call while processor_t::step()
    returns early on every trap, so each trap forfeits the rest of its window.
    Measured with the flow's own flags: a program taking 39 traps still
    reaches its end under --instructions=200005 and one taking 40 does not,
    stopping at 248 lines. All 12 rrag programs sampled take 81-699 traps and
    stop at ~3.7-4.1k reference lines against the 9k-75k they actually retire.
    End to end through the DUT and compare_dumps, those programs are Failed
    with the flag and Passed without it -- so the n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
2026-09-12 fix(verif): truncate the traces at a tohost store, not any tohost access
    The awk pattern was the tohost address alone, which also matches a load of
    tohost -- Spike logs a load as "mem 0x<addr>" with no value. A program that
    polls tohost before writing it would have had both traces cut at that first
    read, silently dropping everything after it from the comparison while still
    reporting a pass.
    Match "mem 0x<addr> 0x", i.e. an access carrying a value, on both sides.
    No enabled generator reads tohost today; riscv-torture's v-mode runtime
    does, and it is already tracked in-tree.
    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
2026-09-12 fix(verif): pin the riscv-dv checkout, and enforce it every run
    version was empty, so a fresh box cloned upstream master. The 25 patches
    in the plugin's patches/ directory apply to b7a0b4b and to nothing beyond
    it, so a machine set up today would either fail to apply the series or
    apply it to code that had moved underneath it. The local checkout has been
    sitting on that revision since April, which is the only reason this has
    not bitten yet.
    Honouring version only at clone time would not have been enough either --
    that is the same mistake the riscv-tests pin made. Check HEAD against the
    pin on every run, fetch the revision if it is missing, and check it out
    after the reset that precedes the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
2026-09-12 fix(verif): report the tests a generator failed to produce
    Both plugins built their test list from whatever .S files happened to
    exist and threw away pytest's exit status. A stream that fails to generate
    therefore vanishes from the test list and from the results -- and the run
    looks *better* for it, because a failing stream stops contributing
    failures. Two of thirteen riscv-dv streams were lost to generation
    timeouts in one earlier run with no trace of it in the verdicts.
    Compare what was produced against what was asked for (the testlist's
    iteration counts for riscv-dv, configs x count for rrag) and log the gap.
    Deliberately not fatal: a partial suite is still worth running, as long as
    nobo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
2026-09-12 chore: pin pyvsc, in the file that calls itself a freeze
    pyvsc was the one unpinned entry in requirements.txt. It is the constraint
    solver riscv-dv's pyflow generator runs on, and several patches in the
    riscv-dv patch series exist because of how this exact release solves --
    or fails to solve -- riscv-dv's constraints. An unpinned solver means the
    stimulus can change without anything in the repo changing.
    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
2026-09-12 fix(verif): enforce the riscv-tests pin on an existing checkout
    The pin was applied inside the "not already cloned" branch, so it only
    ever reached a machine that had no checkout yet. Every box set up before
    it stayed on whatever revision it was cloned with -- the exact situation
    the commit that added it described and meant to prevent.
    Check HEAD against the revision on every run and check it out when it
    differs. Also fail the run when the clone or the checkout fails, instead
    of continuing against an absent or wrong test set.
    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
2026-09-12 feat(verif): fail a test that signalled failure through tohost
    Nothing in the flow has ever looked at the value a test writes to tohost.
    Every generator here writes 1 for success, and riscv-tests writes
    (testnum << 1) | 1 when its own self-check fails -- so a test that failed
    identically on both models produced matching traces and was reported as
    Passed. The same applies to any generated program that exits through an
    error path rather than completing.
    Append a DUT-FAIL line to the dump when the value is not 1, reusing the
    mechanism the testbench's abort marker uses: compare_dumps cannot parse
    the line and returns Failed. Verified under make against word and byte
    stores of 1 (untouched), a f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
2026-09-12 fix(verif): keep an injected instruction stream in order
    mix_instr_stream(..., contained=1) draws an insert position per injected
    instruction from an inclusive randint(0, current_instr_cnt), sorts them,
    then overwrites the last with current_instr_cnt - 1. That overwrite can
    drop the last position below an earlier one, so the positions are no
    longer sorted and the stream is emitted out of order.
    For a loop that is fatal: build_loop_instr_stream() hands over
    [init, init, target, update] + body + [branch], and when the update lands
    after the branch the counter is never updated inside the loop, so the loop
    cannot exit. Modelled over the generator's own num_of_instr_in_loop range
    (1..25), the or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
2026-09-12 fix(verif): size spike's runaway guard from the retire budget
    10,000,000 steps looked comfortably large but is only 2000 INTERLEAVE
    windows, so it re-creates the same cliff at 1999 traps instead of 39. The
    densest rrag program measured takes one trap per 108.9 retires, which is
    ~1840 traps to reach max_instr -- 9% clear of the ceiling, i.e. one
    config draw away from truncating the reference again.
    Derive it as 5000 x max_instr, the worst case the mechanism allows: every
    retire followed by a trap, each forfeiting a whole window. It then cannot
    be crossed at any trap density, and costs ~0.6 s on a program that traps
    forever, which is the only case the knob exists for. An explicit ini value
    st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
2026-09-12 docs(verif): correct which watchdog fires first, and the dump-cap coupling
    The comment claimed max_instr normally fires before max_cycles. It binds
    only above IPC 0.067, and memory-heavy programs run below that --
    riscv_loop_test_0 stopped on max_cycles at 162,309 retires, IPC 0.054.
    Harmless now that either bound marks the dump, but the note was wrong.
    Also record that max_dump_mb and max_instr are coupled: at 47-54 bytes per
    commit-log line, 64 MiB holds ~1.24M lines, so raising max_instr past
    ~1.1M would let the file cap truncate a trace before it reaches the retire
    budget and fail a passing test on length.
    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
2026-09-12 fix(verif): anchor the reference-side self-loop strip
    The DUT side deletes lines ending in (0x00000063) or (0x0000006f); the
    reference side matched those digits anywhere in the line. A commit-log
    line whose register or memory value happens to be 0x00000063 was therefore
    deleted from ref.dump and kept in dut.dump -- a one-sided deletion, which
    the comparison then reports as a divergence against the core.
    Anchor both. Checked under make against a trace containing both the
    self-loop instructions and the same digits as data: identical output on
    the two sides.
    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
2026-09-13 feat(verif): make an unexpected trap fail the riscv-dv test
    The exception handler's fall-through -- every cause it cannot resume from,
    so access faults, misaligned accesses, an ecall from U -- jumps to
    test_done, which sets gp to 1 and exits through the success path. The
    program reports a pass having run only as far as the fault, and both
    models take the same path so the traces agree. That is how 30 of the 41
    passing riscv-dv tests on the last run each verified a median of 7
    instructions of their generated body, and it is what hid the operand
    aliasing defect for three regressions.
    Exit with tohost = (mcause << 1) | 1 instead, the riscv-tests failure
    convention, jumping straight to write_toh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
2026-09-13 feat(verif): re-enable the illegal-instruction and HINT streams
    Both sat at iterations: 0 because the generator injected nothing into
    them. Patch 31 makes the draw work, so the core's illegal-instruction and
    HINT paths get random stimulus again.
    riscv_illegal_instr_test at 6 iterations because the RTL resolves
    illegal-instruction last in its exception priority, which is exactly what
    this stream walks into; riscv_hint_instr_test at 4, which now covers the
    C.LUI rd=x0 case this branch changed the decoder to treat as a HINT.
    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
2026-09-13 fix(verif): point spike at the FyraCore device tree
    Hands spike the tree added in the previous commit, so the reference stops
    answering at the PLIC and UART addresses the DUT faults on. The key already
    existed and is interpolated into the spike command line verbatim, so this
    is a one-value change; emptying it restores stock behaviour.
    The comment records the two things the tree cannot change, both measured:
    spike ignores the CLINT's reg size and always maps 0xC0000 from its base,
    and the boot ROM at 0x1000 is added after the tree is parsed and holds the
    reset vector, so --disable-dtb removes the reset vector too and spike then
    hangs with an empty log.
    Claude-Session: https://claude.ai/code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
2026-09-13 fix(tb): size the CLINT window to the aperture spike actually maps
    Spike maps CLINT_SIZE = 0xC0000 from the CLINT base and ignores the reg
    size in its device tree, so every address in 0x02000000-0x020BFFFF answers
    loads and stores there: the registers at 0x0000/0x4000/0xBFF8 and plain
    zeros in between. The DUT's IO0 window stopped at 0x0200C003, so all of
    that padding faulted on the core and succeeded on the reference -- 24 of
    the 73 address/operation cells where the two models disagreed.
    Widen IO0 to match, and give memory_model the same shape: the registers
    below offset 0x10000, zeros above, writes above dropped. The offset gate
    matters -- clint_inst is addressed with 16 bits, so without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
2026-09-14 docs(verif): note the open riscv-dv stimulus gaps for the design reviewer
    The design-reviewer note listed what the riscv-dv generator exercises
    without saying where that stimulus is weaker than a test's name suggests.
    An assembly audit of the current suite found open generator defects: M-mode
    boot skips its CSR setup, about half of the injected illegal/HINT words
    never execute, corner values never reach all-ones/INT_MIN, jump streams
    have no compressed jumps, and several solves are skewed. Record them so a
    passing riscv-dv test is not read as full coverage.
    Claude-Session: https://claude.ai/code/session_01NzWCZU3VZduh6Bymwxa7F3
2026-09-14 test(riscv-dv): boot riscv_pmp_locked_exec_test in M-mode
    The test locks region 1 with X=0 so that fetching main faults even in
    M-mode. Without +boot_mode the boot mode is random (M:U = 6:4), and a
    U-mode seed faults the same way on an unlocked X=0 entry, so it cannot
    show that the lock binds M-mode. The assembly audit of the last sandbox
    run found exactly that: of the two seeds, only the M-boot one exercised
    the lock.
    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
2026-09-14 feat(verif): pin riscv-dv to the generator audit fixes
    Moves the riscv_dv plugin's fork pin from ea5573d to abc8431 on
    pyflow-fixes. The fourteen commits in between fix the generator defects an
    assembly audit of the last sandbox run found, where tests passed but did not
    exercise what they are named for: M-mode boot skipping its mode-switch
    routine, injected illegal/HINT words placed where they never execute, main
    not 4-byte aligned, corner values without all-ones/INT_MIN, jal streams
    without compressed jumps, lost compressed stream markers, unconstrained
    mstatus.VS, and pyvsc solution skews (loops that never iterate,
    10-instruction sub-programs, bimodal call trees, five HINT encodings,
    rd bi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
2026-09-15 feat(verif): pin riscv-dv to the call-reach branch clamp
    Moves the riscv_dv plugin's fork pin from abc8431 to 8b3facf on
    pyflow-fixes, the fork branch tuned to expose the most core defects (the SV
    behaviour lives on the fork's sv-faithful branch). The new commit keeps
    random forward branches from skipping sub-program calls: on same-seed
    programs the executed body rose from 53.6% to 72.4% and every sub-program
    was entered (110 of 110, was 72).
    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
2026-09-15 chore(verif): re-pin riscv-dv to the re-signed pyflow-fixes
    The riscv-dv fork's pyflow-fixes branch was rebuilt so that every commit is
    signed: 15 commits after 3eb424f had been recreated without signatures by a
    message-rewriting helper, and the 3 after them were rebuilt on top. Trees,
    authors, dates and messages are unchanged apart from abbreviated SHAs of
    the rebuilt commits, so the generator at 8b3facf is identical to the code
    the previous pin named. The pins before this one named fork SHAs that no
    longer exist; localFiles/rdv-survey/fix-tools/resign-map-2026-09-15.json
    (kept out of git) maps every one of them to its re-signed commit.
    Claude-Session: https://claude.ai/code/session_01NzWC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
2026-09-22 feat(tb): give the sim memory configurable wait states
    imem_ready and dmem_ready were hardwired to 1'b1, so no simulation this
    project has ever run exercised the core's memory handshake. The tapeout
    target is external QSPI flash and PSRAM, neither of which can answer in
    the cycle it is asked, so every stall and retry path was effectively
    untested — which is how 176/176 arch-test passes coexisted with a core
    that drops stores.
    memory_model now generates ready itself:
    IMEM_WAIT / DMEM_WAIT N wait states per port; ready asserted one
    cycle in every N+1. 0 keeps the historical
    always-ready behaviour, so existing runs are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
2026-09-22 fix(core): hold EX/WB across a data-memory stall instead of bubbling it
    The EX/WB register was cleared on every stall cycle, and `stall` contains
    `wb_mem_stall`, which is itself derived from `exwb_memRD`/`exwb_memWR`. So
    the first cycle the data memory was not ready, the bubble dropped those
    bits, dmem_addr/dmem_we were withdrawn before dmem_ready, the stall
    condition self-cleared, and nothing ever retried the access: stores were
    lost and loads returned whatever happened to be on dmem_rdata.
    Hold EX/WB while the access is on the bus instead. Every other stall
    source still bubbles — by then the WB instruction has committed, and
    holding it would commit it twice.
    Holding turns the one-shot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
2026-09-22 fix(core): commit MRET exactly once, not once per stall cycle
    ex_is_mret is a combinational EX decode with no stall qualifier, and
    csr.v applies the whole MRET mstatus update on every cycle its `mret`
    input is high. Across a two-cycle stall that ran twice: the first pass
    set MPIE=1, the second reloaded MIE from that freshly-set MPIE, so MIE
    came out 1 where it should be 0. priv_mode was already !stall-gated, so
    it sampled an MPP csr.v had forced to 00 on the first pass and the hart
    dropped to U-mode instead of returning to M.
    Gate the commit the way fencei_flush already is. priv_mode now samples
    csr_mstatus_mpp on the same edge csr.v updates mstatus, so it sees the
    pre-update MPP.
    `flush`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
2026-09-22 fix(decode): stop illegal LOAD/STORE/JALR encodings requesting side effects
    The LOAD, STORE and JALR blocks assert their control outputs before the
    funct3 case that decides whether the encoding is legal at all, and the
    default arm only sets `illegal`. So an unrecognised funct3 still left
    memRD/memWR asserted (with memSize at the block default, word) or doJump
    asserted, and the instruction went on to compute an address or a target
    and raise an exception for it.
    That is how an illegal load encoding at a misaligned address reported
    cause 4 instead of cause 2 -- the address exception is real, it just
    should never have been reachable, because the instruction does not decode
    to a load.
    Clear the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
2026-09-22 fix(trap): rank illegal instruction above the address exceptions
    The synchronous-exception chain resolved causes in the order
    1 > 0 > 11/8 > 3 > 4 > 6 > 5 > 7 > 2
    with cause 2 reached only as the fallthrough. Priv spec v1.12 Table 3.7
    puts illegal instruction directly below instruction access fault and
    above instruction-address-misaligned, the environment calls, breakpoint
    and every address-misaligned/access-fault cause.
    Collect the illegal-instruction sources into ex_illegal_insn (ex_trap now
    uses it too, so the two lists cannot drift apart) and test it second. The
    fallthrough arm becomes cause 7, which is the only ex_trap source left
    once every other arm has been tested.
    Stopping i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
2026-09-22 fix(trap): report the faulting encoding in mtval on illegal instruction
    mtval was written as 0 for cause 2, with a comment claiming the reference
    model does the same. It does not: Spike writes the instruction bits, for
    both 32-bit and compressed encodings. Priv spec §3.1.16 permits either,
    so this was never a conformance failure, but it is a permanent lockstep
    divergence and it throws away the one piece of information a handler
    would want.
    ifex_raw_instr carries the fetched encoding -- the 16-bit halfword for a
    compressed instruction, the full word otherwise -- which is exactly what
    Spike reports in each case.
    DUT mcause/mtval, now identical to Spike on all five directed cases:
    .word 0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
2026-09-22 fix(core): do not inject an interrupt while the pipeline is stalled
    irq_inject excluded muldiv_busy, wb_busy and wfi_active but not
    load_use_hazard, if_mem_stall or wb_mem_stall. An interrupt arriving
    during a memory stall was therefore injected on two consecutive cycles:
    the EX/WB register is rewritten on each, so csr.v ran trap entry twice,
    and the second pass latched MPIE from the MIE the first pass had already
    cleared. The following MRET then restored MIE=0 and the hart took no
    further interrupts. The injection path also overrides the EX/WB hold, so
    it tore down whatever memory access was in flight.
    Use stall_other, which subsumes wb_busy and wfi_active and adds the three
    missing source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
2026-09-22 fix(csr): give the EX forwarding path the WARL masks csr.v applies
    csr_fwd_data exists so a csrr in EX reads back what a csrw still in WB
    will actually commit. Four CSRs that csr.v masks had no arm in it at all,
    so the forwarded read returned the raw write data, and the mepc arm was
    missing the IALIGN mask.
    Back-to-back csrw/csrr, so the read is served by the forwarding path:
    CSR write before after Spike
    mcountinhibit -1 0xffffffff 0x00000005 0x00000005
    mepc (C=0) ..102 0x80000102 0x80000100 0x80000100
    mcounteren -1 0xffffffff 0x00000007 0x00000007
    mie -1 0xffffffff 0x00000888 0x00000888
    The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
2026-09-22 fix(csr): stop claiming Spike's marchid in the RTL default
    marchid 5 is the architecture ID RISC-V International allocated to Spike.
    Hard-coding it means silicon would identify itself as the reference
    simulator. Make it a parameter defaulting to 0 -- the encoding for "no
    registered architecture ID" -- and have the testbench override it to 5 so
    the lockstep trace still matches. Same pattern the PMA windows already
    use.
    csrr marchid RTL default 0, tb override 5, Spike 5.
    mvendorid and mimpid were already 0 on both sides.
    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
2026-09-22 docs(rtl): correct three comments that describe the wrong behaviour
    * The PMA comment claimed that faulting a fetch from the CLINT "is also
    what the reference model does". It is not -- Spike reads the device and
    reports cause 2 with the fetched bits in mtval. Cause 1 is the
    defensible hardware behaviour, so the RTL is right and the comment was
    wrong; say so explicitly, since this is a divergence somebody will hit
    again in a lockstep run.
    * ex_inst_misalign cited Priv spec §3.1.15 for a rule that lives in the
    unprivileged RV32I control-transfer section.
    * misa_reg described U as a writable toggle. It is not writable.
    No functional change.
    Claude-Session: https://claude.ai/code/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
2026-09-22 fix(pma): fault LR/SC aimed at an IO window
    lr.w and sc.w to the CLINT succeeded. A reservation needs a reservation
    set to track, which an IO window does not have and cannot have -- the
    accesses are not idempotent. The reference model agrees: its reservable()
    covers main memory only, so lr.w/sc.w there fault while amoadd.w
    succeeds, and on this the DUT was the wrong side.
    Split ex_pma_data_ok into its memory and IO halves and exclude LR/SC from
    the IO half. LR takes cause 5 and SC cause 7, which falls out of
    ex_misalign_is_store already treating SC as a store.
    lr.w / sc.w / amoadd.w at 0x02004000, causes logged one nibble per trap:
    before after Spike
    a4 0x00 0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
2026-09-22 fix(muldiv): hold the result until the pipeline can take it
    MUL/DIV livelocked forever whenever instruction fetch had two or more
    wait states -- the operating point of the actual hardware, since the SoC
    executes out of external QSPI flash.
    muldiv_done is a one-cycle pulse, and the only thing that latches
    muldiv_result is the final `else` arm of the EX/WB register, which needs
    !stall. On the done cycle muldiv_stall has already dropped -- busy is 0
    and start is blocked by !muldiv_done -- so `stall` is just stall_other.
    One coincident if_mem_stall and the result is discarded, whereupon
    muldiv_start relaunches the whole operation.
    The latency is fixed and the memory model's wait counter free-r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
2026-09-22 fix(csr): commit a CSR write that lands the same cycle as an MRET
    `csrw <any CSR>; mret` silently discarded the write. csr.v's write block
    was `if (trap) ... else if (mret) ... else if (we)`, and `mret` is the
    EX-stage decode, so a csrw sitting in WB alongside an MRET in EX lost the
    `we` arm entirely -- for every CSR, not just the privileged ones. The
    csrw is the older instruction and Zicsr requires its effect to be
    complete before anything later observes state.
    Two separate defects, the second only visible once the first was fixed:
    1. The write itself was skipped. Restructured so the write commits first
    and the trap/MRET transform is applied afterwards, computed from
    mstatus_after_w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
2026-09-22 fix(atomics): an AMO to the reservation address invalidates it, like a store
    The guard was `exwb_memWR && !exwb_isAmo`, so a plain store to the
    reservation address cleared the reservation but an AMO to the same
    address did not. Both are local writes overlapping the reservation set,
    and two paths were independently deciding the same semantics and
    disagreeing. Nothing in the code said that was intentional.
    Neither clear is architecturally required -- the must-fail list covers
    writes from another hart and from devices, not from this one -- but
    conservative clearing is explicitly permitted, and neither can threaten
    the forward-progress guarantee: a constrained LR/SC sequence may not
    contain loa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
2026-09-24 docs: hand off the riscv-dv generator work
    Four lockstep failures that belong in the generator, not the RTL: unconstrained
    LR/SC sequences, U-mode tests missing the head.S PMP prologue, misa M/A writes,
    and no mtimecmp init before mip is read. In each case both models are
    conformant and changing the core to match Spike would make it less correct.
    Points at localFiles/riscv-dv-svf, branch sv-faithful, with the symptom,
    the spec reasoning, the change and an acceptance test for each -- plus an
    explicit "NOT generator work" list so the testbench items are not picked up
    here by mistake.
    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
2026-09-24 fix(muldiv): do not wait on an M instruction that is trapping
    Since 2e6718b, muldiv_stall is muldiv_want && !done-or-ready, which no
    longer depends on muldiv_start. muldiv_start is gated on flush, and
    flush contains ex_trap, so an M instruction that traps in EX never
    starts -- and then stalls forever waiting for its result. The trap
    never reaches WB; only reset recovers.
    Reachable whenever a fetch fault's word decodes as MUL/DIV: a jump to an
    unmapped alias of a mul (PMA, cause 1), or U-mode jumping into an
    execute-denied region holding one (PMP, cause 1). Before 2e6718b both
    trapped correctly.
    muldiv_want now excludes ex_trap. ex_trap depends on neither stall nor
    flush, so this adds no co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
2026-09-24 fix(core): only redirect to the trap vector when EX is not stalled
    next_pc took trap_target whenever ex_trap was high, with no stall term.
    During a load-use or AMO-read stall the instruction in EX computes its
    address from wb_data, which is dmem_rdata before dmem_ready. On a real
    bus that is zeros or stale data, so the address can land outside the
    PMA windows or misaligned for a cycle: ex_trap rises, pc is redirected
    to mtvec while IF/EX holds the instruction, the data arrives, ex_trap
    drops, the instruction retires normally -- and fetch continues from the
    handler with no trap taken, running it with stale mcause/mepc.
    Every other redirect (branch, fence.i) was already gated on !stall, and
    t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
2026-09-24 fix(atomics): clear the reservation when a trap commits, not in EX
    The trap/interrupt clear was `if (ex_trap || irq_inject)`, an EX-stage
    condition with no stall term. With EX/WB now held across a data-memory
    stall, an sc.w can sit in WB waiting for dmem_ready while the next
    instruction is already in EX. If that instruction traps, the clear lands
    mid-handshake: sc_success drops, wb_mem_write and dmem_we are withdrawn
    before ready, and rd reads 1. A bus that latches a request on its first
    cycle has already performed the store, so software sees a failure and
    retries an atomic update that happened. The EX clear could also fire on
    a trap that is never taken, when EX briefly sees not-yet-valid
    fo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
2026-09-24 fix(irq): an interrupt taken at an MRET suppresses the MRET
    irq_inject suppresses the side effects of whatever instruction is in EX
    and records its PC as mepc, and next_pc already prefers the interrupt
    over the MRET redirect. ex_mret_commit, though, had no !irq_inject term,
    so an MRET in EX with an interrupt pending both committed: csr.v applied
    the MRET transform (MPP<-U, MIE<-MPIE) and the next cycle the interrupt
    trap saved that state. The handler entered with mstatus 0x0080 (MPP=U)
    and mepc = the MRET's own PC, so its return re-executed the MRET from
    U-mode and took an illegal-instruction trap.
    Reachable only when MRET runs with MIE=1 and an interrupt pending; Linux
    always has MIE=0 the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
2026-09-24 fix(make): fail the unit-test targets when a testbench reports FAIL
    Every component testbench prints FAIL (or TIMEOUT) lines and then calls
    $finish, which exits 0, so `make test-all` printed "All tests completed
    successfully" over tb_csr and tb_controller failing six checks between
    them for most of this branch's history.
    A run_tb helper now tees each testbench's output to build/<tb>.log and
    fails the target if any line starts with FAIL or TIMEOUT. Checked both
    ways: test-components exits 0 on the current tree, and an injected wrong
    expectation in tb_csr makes test-csr exit 2.
    Claude-Session: https://claude.ai/code/session_01NX7fjmEL1UuLvQWDUbscqj
2026-09-24 refactor(csr): compute each CSR's post-write value once, in csr.v
    The WARL rules were implemented four times: csr.v's write case, the
    csr_fwd_data forward in fyracore.v, a third mtvec/mepc mask on the trap
    and MRET targets, and the testbench's csr_committed. Every copy that
    drifted produced a defect (pmpcfg NA4, the mcountinhibit/mepc/mie
    forwards, mip's live bits), and fyracore reached into csr_unit.mstatus
    by hierarchical reference from synthesizable RTL to do it.
    csr.v now computes `wval`, the value the CSR at waddr reads back once
    the write in WB has committed, and stores it (mepc and mip store a
    little more than they read back, noted where it happens). It is
    exported as wval_out, and f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
2026-09-24 fix(tb): print the value the CSR holds, and only writes Spike logs
    The trace's CSR commit values came from csr_committed/mstatus_committed,
    a fourth copy of the WARL rules kept in the testbench. It had drifted:
    it printed mepc without the IALIGN mask (0x80000102 where the register
    reads 0x80000100 with misa.C=0) and printed the written value for a
    locked pmpcfg0/pmpaddr, so the trace claimed state the DUT never held.
    The value is now cpu.csr_wval, csr.v's own post-write value, and both
    copies are deleted. Which writes appear also follows Spike, measured
    with a probe on spike 1.1.1-dev:
    - a PMP write that a lock discards entirely is not logged (pmpcfg0 only
    when all four bytes are locked;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
2026-09-24 fix(irq): gate interrupts on mie as it stands after a pending write
    Interrupt gating in EX read the committed mie register, while a csrw to
    mie commits one stage later in WB, so the instruction right after an
    mie write was gated by the old value. Priv §3.1.9: the interrupt trap
    conditions "must also be evaluated immediately following ... an
    explicit write to a CSR on which these interrupt trap conditions
    expressly depend (including mip, mie, mstatus ...)". mstatus.MIE was
    already forwarded; mie was not.
    Both directions were wrong (msip pending, MIE=1, 0 wait states):
    - enabling: `csrs mie, MSIE` took the interrupt one instruction late
    (mepc 0x80000030; Spike and now the core: 0x8000002c)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
2026-09-24 fix(csr): mip has no writable bits on an M+U core
    mip stored every written bit except MSIP/MTIP/MEIP (mask ~0x888), so
    `csrw mip, -1` read back 0xfffff777. With no S-mode, SSIP/STIP/SEIP are
    read-only zero (Priv §3.1.9), and LCOFIP is read-only zero without
    Sscofpmf; the remaining bits are reserved. mip has nothing writable at
    all: a write is accepted and ignored, and a read returns only the live
    MSIP/MTIP/MEIP wires.
    mip_reg (29 live flops) is deleted, and wval for 0x344 is the live
    value, so a forwarded read and the trace agree with a plain read.
    Verified against Spike, full trace, with mtimecmp set to -1 first so
    MTIP agrees (the two models reset mtimecmp differently): csrw mip,-1
    then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
2026-09-24 fix(csr): forward a counter write to an adjacent read of its U-mode alias
    cycle, instret and their high halves (0xC00/0xC02/0xC80/0xC82) read the
    same registers as mcycle/minstret (0xB00/0xB02/0xB80/0xB82), but CSR
    forwarding matched on the exact address only. A read of the alias in
    the instruction right after a write to the M-level name therefore saw
    the old counter:
    csrw minstret, 0x1000; csrr a0, instret DUT 0x2, Spike 0x1000
    csr_fwd now also matches an 0xC.. read against an 0xB.. write with the
    same low byte, restricted to the four counter aliases (time, 0xC01, is
    the CLINT and has no M-level CSR).
    Verified against Spike, full trace: all four pairs (instret, instreth,
    cycle, cycle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
2026-09-24 fix(csr): make a misa.C write visible to the very next instruction
    Every misa.C consumer read the committed register, one or two stages
    ahead of the csrw that changes it:
    - compressed decode applied !misa.C at IF, two stages before the write
    commits, so `csrci misa, 4; c.addi; c.addi` executed both compressed
    instructions (Spike raises cause 2 on the first), and the reverse
    trapped two instructions after C was set;
    - the mepc read mask and the branch-target alignment check ran in EX
    against the pre-write value.
    Zicsr: "the full consequences of any such side effects are observable
    by the very next instruction". csr.v now exports misa.C as it stands
    after a pending WB write (like the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
2026-09-24 fix(pmp): refetch after a PMP CSR write so the next access sees it
    Both PMP checkers run in EX against the committed pmpcfg0/pmpaddr
    registers, while a csrw to them commits one stage later in WB. The
    instruction right after the write was therefore fetched and executed
    under the old configuration. Found while fixing the misa.C lag -- the
    same EX-consumes/WB-commits family -- and not in any earlier review.
    Measured against Spike, M-mode, locked NA4 entries:
    - csrw pmpcfg0 (L, no R) ; lw from that word
    DUT: load succeeds (0x1234) Spike: load access fault, cause 5
    - csrw pmpcfg0 (L, R+W, no X) over the next instruction
    DUT: executes it Spike: fetch access fault, cause 1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
2026-09-24 fix(pmp): compare in the 34-bit physical address space
    On RV32 a pmpaddr register holds bits 33:2 of a 34-bit physical
    address. pmp.v used pmpaddr[29:0] only, so a region bound above 4 GB
    wrapped into the 32-bit space:
    TOR, pmpaddr0 = 0x4000_0000 (top = PA 0x1_0000_0000)
    covers all of memory; the DUT matched nothing and denied U-mode.
    Every compare is now on word addresses, waddr = {2'b00, addr[31:2]}
    against the full 32-bit pmpaddr: TOR bounds, NA4 equality and the NAPOT
    comparison. The hart only issues 32-bit addresses, so PA[33:32] is 0.
    Verified against Spike, full trace: the 4 GB TOR case diverged (U-mode
    fetch fault on the DUT only) and now matches; pmpcfg, mprv2, both PMP
    adj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
2026-09-24 feat(core): request strobes on both memory ports, with a held request
    The memory ports had no request strobe. dmem_addr showed the WB ALU
    result on every cycle, so a controller could not tell a load from an
    lui that happened to compute a device address, and a UART RX FIFO
    behind such a bus would be popped by instructions that never loaded
    from it. A failing sc.w issued no write but still waited for
    dmem_ready, which on a request/ready bus never comes for a request
    that was never made. And nothing guaranteed the fetch address was
    held while a fetch was outstanding: the MRET redirect was the one
    next_pc arm not gated on !stall, so it moved imem_addr mid-fetch.
    The contract, now in fyracore.v'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
2026-09-24 fix(csr): legalise a write of MPP=01/10 to U, not to the old MPP
    MPP is WARL; on an M+U core its legal values are 00 and 11. A write of
    01 (S, not implemented) or 10 (reserved) kept the previous MPP. That is
    a legal choice, but Spike legalises both to U, so every such write --
    riscv-dv's random mstatus writes produce them -- diverged in lockstep
    from then on (MPP=11 kept vs 00).
    MPP now becomes U unless both bits are written 1: {2{new[12] & new[11]}},
    one AND gate instead of a compare-and-hold. U is the least-privileged
    mode, which is also what MRET leaves in MPP.
    Verified against Spike, full trace: csrw mstatus with MPP=10 and with
    MPP=01 over MPP=11 read back 0x1800 on the DUT and 0 on S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
2026-09-24 fix(csr): reset mstatus to 0 (MPP=U), matching the reference
    mstatus reset to 0x1800 (MPP=M). Priv §3.4 requires only MIE and MPRV
    to reset to 0; MPP's reset value is implementation-defined, so both
    are legal. Spike resets it to 0, and every trace that writes mstatus
    with csrs/csrc before setting MPP logged a different value from the
    first instruction (0x1808 vs 0x0008 on `csrsi mstatus, 8`), masking
    whatever came after -- the mie-forwarding repro diverged at line 7 on
    exactly this.
    No boot path depends on it: Linux sets MPP explicitly before any MRET,
    and a bare-metal MRET without setting MPP now returns to U, which is
    what MRET itself leaves behind. tb_csr's reset expectation is updated.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
2026-09-24 docs(rtl): describe the muldiv term of irq_inject as it is
    The comment above irq_inject still described a muldiv_busy gate and
    reasoned about the first cycle of a multiply, from before 2e6718b
    replaced it with !muldiv_want. It now says what the term does: no
    interrupt while any M instruction is in EX, and why muldiv_stall cannot
    be used there. Comment-only.
    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
2026-09-24 test(directed): fix tests that diverged for reasons outside the core
    Six directed tests could not pass a full-trace comparison with Spike, and
    one tested nothing, for reasons unrelated to the RTL:
    - lrsc_io read mtimecmp, whose reset value differs between the models
    (all ones here, 0 on Spike); it now targets msip, which both reset to 0.
    - t_csrmret's control case returned to U-mode with no PMP entry, which
    the core correctly faults (PMP resets off) and Spike does not (it
    resets permissive); the case now returns to M.
    - t_warl locked entry 0 without programming pmpaddr0, so the lock froze
    a reset value that differs between the models; it now writes 0 first.
    - mprv relied on PMP's re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
2026-09-24 test(directed): compare full traces, and run every test from a manifest
    The runner reported "20/20 directed tests match Spike" while every M
    instruction after the first returned the wrong result. It compared only
    the final value of a few named registers, so a test whose trace
    diverged still passed; a register absent from both dumps compared ""
    equal to ""; and it ran 17 of the 34 tests, leaving out the two (t_div,
    t_memstress) that exposed the bug.
    run.sh now reads MANIFEST, one run per line:
    - `<name> spike [+PLUSARG...]`: the DUT's commit log must equal
    <name>.ref line for line;
    - `<name> expect <reg>=<hex>... [-- +PLUSARG...]`: DUT only, for a
    spec-legal divergence from Spike (reserv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
2026-09-24 chore(verif): re-pin riscv-dv to the rebased pyflow-fixes
    The fork's pyflow-fixes was rebased onto chipsalliance master 0d71c2b
    (was b7a0b4b), so every commit on it has a new sha and the old pin
    8b3facf is no longer on the branch.
    The six new upstream commits touch only requirements.txt and
    .github/workflows/run-tests.yml; no generator code changed. The rebase
    was checked patch-identical -- every commit's patch-id matches before
    and after -- and the generator tree at a280b50 is byte-identical to
    8b3facf, so this re-pin changes no stimulus. a280b50 itself only
    records the new base in docs/pyflow.
    Upstream's requirements.txt now pins pyvsc==0.9.1.10086043874. Nothing
    here installs that file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
2026-09-24 docs: bring the CPU reference up to date with the RTL
    Most sections described behaviour this branch changed or never had:
    muldiv stalling "until muldiv_done", mstatus writable bits 0x1888,
    pmpcfg NA4 "masked to OFF", an always-ready memory model, U-mode WFI
    always illegal, the old irq_inject formula and mstatus_mie_eff
    forward, mimpid 1, misa without U, mip writable, "overlapping" LR/SC
    invalidation, and no request strobes.
    Rewritten against the current RTL: the stall/flush equations and the
    redirect-only-when-not-stalled rule; how EX sees CSR state (csr.v's
    post-write value wval, post-write mstatus/mie/misa.C exports, the PMP
    refetch); the request/ready memory contract; PMP's 34-bit compar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
2026-09-24 docs(claude): describe the CSR, stall and memory rules as they now are
    CLAUDE.md's architecture notes told the next session to add a
    forwarding entry in csr_fwd_data for every new CSR, that three copies
    of the pmpcfg masking must agree, that misa.C was still open, and that
    the sticky muldiv fix was correct -- all now wrong.
    It now says: new CSRs go in csr.v only (read case and wval); anything
    new read from CSR state in EX needs a post-write export or a refetch
    (the family behind six bugs); every redirect is taken only on a
    non-stalled cycle; the request/ready memory contract and its checker;
    how muldiv_have/muldiv_want work and why; PMP and LR/SC rules; the new
    mstatus and mip invariants. I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
2026-09-24 test(directed): add a regression test for every defect fixed on the branch
    26 tests, each the reproduction that showed a defect, each failing on
    the RTL before its fix and matching Spike after it (or, where the
    behaviour is a legal divergence, checked against the core's policy):
    - muldiv: mul_chain (C1, four fetch timings), mul_fetchfault and
    mul_pmpx (C2, fetch-faulting M-op words)
    - pipeline: ptrchase and amo_chase under zero and garbage not-ready data
    (C3, the stalled trap redirect)
    - atomics: sc_trap (M1, SC withdrawn by a trailing trap), lr_sb_sc
    (reservation is the aligned word; policy check)
    - interrupts: mret_irq (M2), mie_enable and mie_disable (M3)
    - memory handshake: mret_f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
2026-09-25 fix(core): do not request a fetch outside the executable window
    imem_req was tied high, so the core requested whatever PC pointed at:
    - a jump into an IO window put a read on the device's bus -- a read can
    have side effects (an 8250 RBR read pops the RX FIFO) -- even though
    the instruction then faults in EX;
    - a jump to an address with nothing behind it waited for an imem_ready
    that a real controller has no reason to give, and hung the core
    before the fault could be raised.
    imem_req is now high only while pc lies in PMA_MEM_*. Outside it no
    fetch is requested, if_mem_stall does not wait, and the fetched bits
    are forced to 0 (a doomed instruction decodes to something harmless,
    and X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
2026-09-25 fix(core): do not pulse fencei_flush for a FENCE.I that does not execute
    fencei_flush, the memory controller's fetch-buffer invalidate, was
    ex_is_fencei && !stall, so it also fired when the FENCE.I was replaced
    by a fetch-fault trap on its word or by an interrupt taken instead of
    it. An extra invalidate only costs a refetch, so this was harmless, but
    the output now means what its comment says: a FENCE.I that executed.
    Raised by the verification review.
    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
2026-09-25 docs: describe the fetch request and byte lanes as they now are
    The reference and CLAUDE.md still said imem_req is always high. It is
    high only while PC is in the executable window (d83bff7), and loads
    now drive dmem_be too (c641e76). The reference's memory-interface
    section also gains the controller requirements from the port comment:
    don't starve the data port while the stalled pipeline re-requests the
    same fetch, keep the last fetched word, and return anything for the
    bytes past the window of a straddling fetch.
    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
2026-09-25 docs(review): record the 2026-09-24 and 2026-09-25 design reviews
    The riscv-design-reviewer's notes from two passes over this branch:
    the 2026-09-24 review that found the muldiv regressions (C1/C2), the
    stalled trap redirect (C3), the SC withdrawal, the MRET+interrupt
    double commit, the missing request strobes and the CSR gaps; and the
    2026-09-25 verification pass over the fixes, which found no regression
    and raised the PMP R=0/W=1, CSR false-path, load byte-lane and fetch
    request items (all since fixed). Earlier findings are marked fixed,
    and the LR/SC policy, Spike behaviours and KianV/PLIC notes are
    updated.
    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
2026-09-25 feat(core): take the reset vector from a boot_addr input
    The reset PC was a parameter, so where the machine starts was fixed when
    the core was built. The SoC needs to choose at reset time between
    booting from flash and booting a program loaded straight into PSRAM, and
    the user wants nothing about the boot path fixed in silicon: no boot ROM,
    and the first instruction is whatever was last programmed.
    RESET_PC becomes the input boot_addr. pc is loaded from it on every
    cycle rst is high, so it only has to be stable by the last reset cycle;
    a strap pin can drive it directly. When the SoC ties it to one of two
    constants, synthesis reduces it to the reset values of the pc bits that
    differ.
    tb_riv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
2026-09-25 feat(soc): add a memory controller joining fetch and data onto QSPI
    The core has two memory ports and the Pmod has one bus. mem_ctrl sits
    between them and the QSPI engine and is two flops of state:
    - Data first. The pipeline only issues a data request on a cycle a
    fetch completes, so the fetch port cannot starve, and serving the
    load first avoids reading the next instruction before it and losing
    it while the load stalls the pipeline. The grant is latched, so a
    request that appears mid-transaction cannot redirect its reply.
    - Chip from address bit 31 (flash / PSRAM) and bit 23 (PSRAM A / B);
    the core's PMA check has already refused everything else.
    - Fetches read 4 bytes from the h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
2026-09-25 test(soc): check the memory path against a QSPI Pmod model
    tb/qspi_pmod_model.v models the Pmod: a flash on CS0 and two PSRAMs on
    CS1/CS2. It implements exactly the commands qspi_ctrl issues, 0xEB and
    (PSRAM only) 0x38, and stops the run on anything else: an unknown
    command, a flash mode byte of 0xAx, more than one chip selected, the
    host not driving during command/address/write data, host and device
    driving IO together, or a PSRAM chip select held low past tCEM (8 us).
    Its data goes out +QSPI_DELAY ns after each falling SCK edge, standing
    in for clock-to-output plus both pad delays.
    tb/tb_qspi.v drives mem_ctrl + qspi_ctrl the way the core drives its
    ports and checks every transfer shape t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
2026-09-25 feat(soc): add the AlphaOneSoC top level
    FyraCore, soc_bus, mem_ctrl + qspi_ctrl for the QSPI Pmod, and the
    CLINT, on the map flash 0x2000_0000, PSRAM 0x8000_0000, CLINT
    0x0200_0000, IO 0x1000_0000 (UART/GPIO/syscon reserved, reading 0).
    There is no boot ROM. boot_sel drives the core's boot_addr: 0 boots from
    flash at 0x2000_0000, 1 from PSRAM at 0x8000_0000. While rst is high the
    QSPI engine releases every pin, so an external master can program the
    flash or load a program into PSRAM before releasing reset; the first
    instruction the core runs is always whatever was last written there,
    and a bare assembly program can be run either way.
    No PLIC: external_irq is tied 0. The PMA_IO* parameters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
2026-09-25 test(soc): run the directed suite through the whole SoC
    `tests/directed/run.sh soc` builds tb_rivercore with -DSOC_TB, which
    swaps the core + ideal memory_model for alphaone_soc driving the
    behavioural QSPI Pmod: every fetch, load and store goes through the
    bus fabric, mem_ctrl and qspi_ctrl, and the trace is compared against
    the same Spike references as the core-level run. The program is loaded
    into the model's PSRAM and the SoC boots from there (boot_sel = 1).
    The trace logic is shared between the two builds: it reads the core
    through a `CPU macro (cpu, or soc.cpu) and the image through `MEMARR
    (memory_model's array, or the model's PSRAM), and in SoC mode the
    tb-level port wires are views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
2026-09-25 chore(soc): remove memController.v, superseded by mem_ctrl + qspi_ctrl
    memController.v was never instantiated. Its hardware path predated the
    core's request/ready contract: it inferred a read from nonzero byte
    lanes, which the core never drove for loads, so every load would have
    returned 0 (2026-09-24 review), and its map put flash at 0. mem_ctrl.v
    and qspi_ctrl.v replace it on the current map and contract.
2026-09-25 fix(qspi): never select the flash for a write
    0x38 is the PSRAM's quad write. On the W25Q128JV-DTR -- the "JVSIM"
    part the TinyTapeout QSPI Pmod guide names -- 0x38 is Enter QPI, after
    which the flash ignores every SPI-mode read until it is power cycled or
    sent Exit QPI. One misrouted write would therefore take the boot flash
    off the bus.
    The core's PMA check already faults every store, AMO and SC aimed at
    flash, so no write request should ever carry cs_sel = 0. The engine now
    masks CS0 out of the chip selects whenever we is set, so a write that
    did arrive goes nowhere instead of reconfiguring the flash. It costs one
    gate.
    Found by the 2026-09-26 design review (finding A2).
2026-09-25 test(soc): make the QSPI Pmod model harder to fool
    Things the model now checks or can emulate, from the 2026-09-26 design
    review:
    - Hand-over state. The Pmod is shared between designs on the demo board
    and not power cycled, so it can arrive in a state the controller does
    not speak. +PSRAM_QPI starts the PSRAMs in QPI mode (only a QPI-form
    0xF5 gets them out), +FLASH_CRM the flash in continuous-read mode
    (only 8 clocks of 1111 end it), +FLASH_QPI the flash in QPI mode (only
    0xFF in QPI form). Any other traffic in those states stops the run.
    - The commands a start-up sequence needs: PSRAM 0x66/0x99 (also with
    both PSRAMs selected at once, which is otherwise an error) and flash
    0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
2026-09-25 feat(qspi): put the Pmod's devices into a known state after reset
    The QSPI Pmod on the demo board is shared between designs and is not
    power cycled when the board switches to this one, so the devices can be
    handed over in a mode this engine does not speak. TinyQV, for one, leaves
    the PSRAMs in QPI mode and the flash in continuous-read mode; every read
    here would then return garbage from the first fetch on. The PSRAM
    datasheet also asks for a reset after power-up.
    Before it accepts its first request the engine now sends:
    CS1+CS2 F5h in QPI form (2 clocks) PSRAM Exit QPI; a PSRAM already
    in SPI mode sees two bits of an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
2026-09-25 feat(qspi): add a read-latency strap for slow pads at high clock rates
    Read data was sampled at one fixed point, two clocks after the device's
    launching SCK edge. That leaves little margin once the clock nears the
    TinyTapeout I/O's limits: TinyQV measured the pad round trip at a little
    over 20 ns and made its read latency a reset-time strap; at 66 MHz our
    fixed point leaves about 3 ns (2026-09-26 design review, finding A4).
    The new rd_late input selects the sampling point:
    0 two clocks after the launching edge (as before): round trip plus
    clock-to-output up to about 2 clocks
    1 three clocks after: between about 1 and 3 clocks. The engine samples
    on the rising-edge clocks of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
2026-09-25 docs: describe the SoC, its memory map and the decisions behind them
    docs/soc-architecture.md is new: the address map, how the SoC boots
    (no boot ROM, boot_sel, pins released in reset, link_soc.ld and
    boot_flash.S), why the bus fabric is the core's own request/ready
    handshake rather than APB, the memory controller and QSPI engine
    (framing, sampling, the start-up sequence, device prerequisites), the
    timer decisions, what booting Linux in 16 MB implies (no XIP on
    NOMMU even in older kernels; the RP2040 can preload PSRAM), how it is
    verified, and the performance options not yet taken, ranked.
    CLAUDE.md and the CPU reference replace the old flash-at-0 map, the
    PMA_MEM_* window and RESET_PC with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
2026-09-25 test(directed): let the SoC run skip fast-memory tests and accept either legal outcome
    Through the whole SoC every instruction costs about 90 clocks, and four
    kinds of directed test turned out to assume a fast memory:
    - t_irq, t_irq2, t_mulirq, t_ctl rearm a 40-clock timer from their
    handler. At QSPI speed the handler cannot finish before the next
    interrupt, so the loop never advances and the run hits its retire
    budget. Legal behaviour, meaningless test.
    - cnt_alias reads `cycle` right after writing mcycle. The csrr waits in
    EX through a ~57-clock fetch and reads mcycle when it executes,
    0x2039 rather than 0x2000; Spike counts one per instruction. The
    forwarding it checks is the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
2026-09-25 fix(qspi): send the flash its Exit QPI in QPI form at start-up
    The start-up sequence's one flash step was 8 clocks of 1111 on CS0. That
    ends continuous-read mode, as the W25Q128JV-DTR datasheet recommends,
    but Exit QPI (FFh) is specified as a 2-clock QPI-form command followed
    by chip select rising; nothing says it still takes effect with more
    clocks after it. A flash handed over in QPI *and* continuous-read mode
    was not recovered: `tb_qspi +FLASH_QPI +FLASH_CRM` failed its first
    flash load (got xxxxxxxx), which with boot_sel = 0 is the first fetch.
    A fifth step now sends FFh in QPI form on CS0 after the 8-clock one. A
    flash already in SPI mode sees two bits of an unfinished command and
    igno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
2026-09-25 fix(qspi): drive the pins idle for a cycle before the first chip select
    While rst is high every QSPI pin is released so the demo board's RP2040
    can use the Pmod. On the first cycle out of reset the engine switched
    SCK and the chip selects from floating to driven on the same clock edge
    that pulled the first chip select low for the start-up sequence, so the
    devices saw CS fall with no settled SCK-low / CS-high state before it.
    The IDLE -> CMD transition now also waits for ctl_oe, which is set on
    the first clock after reset: one cycle with the pins driven idle, then
    the first select. The cost is that cycle, once, at boot.
    Found by the 2026-09-26 RTL review (minor 3).
2026-09-25 fix(qspi): sample the rd_late strap during reset and hold it
    rd_late was read combinationally on every cycle: it selects the capture
    enable of the read shift register and whether a read ends through
    S_TAIL. It comes from a pin, so a change -- or a glitch -- in the middle
    of a read would move the sampling point by a clock and silently shift
    the word by a nibble.
    It is now captured into a flop while rst is high and held after reset,
    the way TinyQV latches its latency setting. One flop.
    Found by the 2026-09-26 RTL review (minor 2).
2026-09-25 fix(soc): reset the PSRAMs at start-up only when booting from flash
    The start-up sequence reset both PSRAMs (66h/99h) on every boot. With
    boot_sel = 1 the point is that an external master -- the demo board's
    RP2040 -- has just loaded a program (or a kernel, device tree and
    initramfs) into PSRAM, and the APS6404L datasheet says what a reset
    does to the device's registers but not whether the array survives it.
    Resetting there could wipe the image the core is about to run.
    qspi_ctrl gains a psram_reset strap, sampled during reset; when it is
    low the sequence skips 66h/99h and still sends the QPI-form F5h (Exit
    QPI is only a mode change). alphaone_soc drives it from !boot_sel:
    booting from flas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
2026-09-25 docs: record the RTL review's findings and the measured area
    soc-architecture.md now matches the RTL after the 2026-09-26 RTL review:
    the five-step start-up sequence (PSRAM reset only when booting from
    flash, the flash's QPI-form Exit QPI, a cycle of idle pins before the
    first select), rd_late sampled during reset, the flash states the
    sequence does not undo, the board questions (chip-select pull-ups in
    reset, a reset synchroniser in the TinyTapeout wrapper), the corrected
    arbitration timing (a data request follows a fetch by a cycle), the
    tests that cover all of it, and a new performance option (abort the
    fall-through fetch on a taken branch, ~58 clocks each).
    It also records the area: abo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
2026-09-25 test(directed): check read-only flash faults and timer interrupts at SoC speed
    Two gaps the 2026-09-26 RTL review found in the directed suite:
    - pma_flash: nothing checked the flash PMA, because Spike maps flash as
    plain RAM and every flash write succeeds there. This DUT-only test
    does LR, SC, AMO and a store to 0x2000_0000 and a plain load, and
    records each trap: causes 5, 7, 7, 7 in order (x18 = 0x5777), mtval
    the flash address every time (x20 = 0), the load returns 0, and
    LR/SC on PSRAM still succeed (x30 = 0).
    - t_irq_slow: the SoC run skips the timer tests because their 40-clock
    period is shorter than a QSPI-speed handler. This one rearms at
    3000 clocks, takes three inter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
2026-09-26 docs(area): record the area baseline and the reductions measured so far
    The area-optimizer's notes from 2026-09-26: yosys + the sky130 hd
    library put the whole SoC at 148,728 um^2 (2,617 flops) against about
    79,000 um^2 for seven TinyTapeout tiles, with a per-block breakdown and
    the recipe to reproduce it.
    Its measured prototypes (scratch copies only, nothing in src/):
    compliance-preserving -- latch register file -22.7k, unified mul/div
    -10.6k, CSR read-side masking -5.9k, pipeline-register sharing -3.8k
    (the prototype still fails t_warl), one shifter + one adder in the ALU
    -1.2k; together 104,966 um^2. Spec-legal trades that need a decision --
    PMP 4 -> 0 entries -14.8k, drop C -3.4k, and s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
2026-09-26 docs: add a reference for the QSPI Pmod's flash and PSRAMs
    The flash, PSRAM and board facts the QSPI engine depends on, in one
    place: the QSPI-Pmod v2.2 netlist (pinout, 10k CS pull-ups, cuttable
    CS traces, the optional 22 pF SCK cap, no pulls on SD0-3), both
    packages, command tables counted in SCK cycles for SPI, QPI and DTR
    forms, mode state machines, what survives a reset, AC timing checked
    against qspi_ctrl at 50 and 66 MHz, and the hand-over states other
    designs leave behind.
    Three things the datasheets turned up:
    - The board carries a W25Q128JVSIM. The Rev F datasheet added to
    docs/ covers the -IQ/-JQ parts and defers QPI, C0h and continuous
    read to the W25Q128JV-DTR datasheet, w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
2026-09-26 docs(qspi-memories): compare the implementation cost of each flash mode
    Against the PSRAM-QPI baseline the engine gets anyway: QSPI as today
    needs a per-chip command width; SPI continuous read adds one flop and a
    command skip for 8 SCK off every flash read; plain QPI removes the
    per-chip mux but adds two start-up steps (one with a parameter byte)
    and the aligned-fetch path for the same 20 SCK; QPI with continuous
    read costs both for the last 4 SCK. Estimates, not synthesis.
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2026-09-26 feat(soc): boot from flash only
    The SoC had a boot_sel strap that could start the core in PSRAM, for a
    program an external master (the RP2040) had loaded there. The user has
    decided the SoC boots from flash only: the reset PC is 0x2000_0000, and
    anything that runs from PSRAM is put there by code in flash.
    - alphaone_soc: boot_sel is gone; boot_addr is tied to 0x2000_0000.
    - qspi_ctrl: the psram_reset strap is gone. It existed only so a PSRAM
    preloaded for boot_sel = 1 would not be reset; now nothing is in the
    PSRAMs at start-up, so they are always reset (66h/99h), as the
    datasheet asks after power-up.
    - fyracore keeps boot_addr as an input: the core-level testbench still
    starts it i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
2026-09-26 test(soc): teach the QSPI Pmod model the PSRAM's QPI mode
    The PSRAMs are about to run in QPI mode, so the model has to speak it,
    per the APS6404L-3SQR datasheet:
    - SPI mode: 0x35 Enter Quad mode (broadcast to both PSRAMs allowed).
    - QPI mode, every command as two nibbles: 0x0B fast read (6 address
    nibbles, 4 wait cycles, data), 0x38/0x02 write, 0x66/0x99 reset (back
    to SPI mode), 0xF5 Exit Quad mode. Anything else stops the run, as
    before; a read or write with both PSRAMs selected still does.
    Read wait cycles now follow the command: 4 for QPI 0x0B, 6 for 0xEB.
    The header lists what is accepted per chip and mode. The engine as it
    stands (SPI-form commands only) still passes tb_qspi un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
2026-09-26 docs: flash-only boot, PSRAM QPI, and the measured speed-up
    - soc-architecture.md: the Boot section describes flash-only boot (no
    strap, no boot ROM, pins released in reset, the Pmod's chip-select
    pull-ups); the QSPI section the PSRAMs in QPI mode and the flash's
    unchanged quad I/O read, the six-step start-up with 35h, and the board
    and device prerequisites docs/qspi-memories.md answered (CS pull-ups,
    standard-grade PSRAM, QE set by TT QA); the Linux section drops the
    PSRAM-preload boot; Verification describes the SoC testbench's flash
    stub; Performance gives the measured result -- 77.3 -> 57.1 clocks per
    instruction through the SoC, -26% -- and re-ranks what is left.
    - CLAUD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
2026-09-26 docs(qspi-memories): make the doc agree with the decision
    d8194db recorded the decision -- PSRAM QPI only, flash QSPI only -- in
    §9.3, but other passages still presented flash QPI as the plan:
    - §5: the "Recommended read" row becomes "Decided read": quad I/O EBh
    with mode byte FFh for the flash, QPI 0Bh for the PSRAM.
    - §7.3: titled and flagged as the option not taken (the sequence in use
    is §7.2); its PSRAM steps no longer mention the removed psram_reset.
    - §7.4: our design leaves the flash in SPI mode with continuous read
    off, so the flasher reaches it; the QPI release is kept as what flash
    QPI would have needed.
    - §8.1 and §8.6: the QPI-only requirements and the QPI-CRM ha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
2026-09-26 docs: plan the chip pinout and the peripheral RTL
    Fixes what every TinyTapeout pin does and lists the RTL still to build
    behind them, so the tt_um wrapper, UART and GPIO can be written against
    one agreed layout.
    Pinout: uio stays the QSPI Pmod's (its wiring puts CS0/SCK/CS1/CS2
    there, and the RP2350 programs the flash through those pins). The UART
    uses TinyTapeout's first listed pair, ui_in[3] RX / uo_out[4] TX, the
    RP2350's plain UART1 pins, plus RTS# on uo_out[5] (RP2350 UART1 CTS).
    The remaining outputs serve the OLED (primary, via a PmodTPH2 with D/C
    moved to the Pmod's NC slot, PMODEN tied to 3V3 and VCCEN tied to RES#)
    or the keypad (splitter cable, rows on ui_in[4..7]), never both.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
2026-09-26 test(qspi-model): require each PSRAM's power-up reset (66h then 99h)
    The APS6404L needs a user-issued reset to finish initialising after
    power-up (datasheet section 7), and 99h resets only when it immediately
    follows 66h (section 12). The model accepted any command at any time and
    treated a bare 99h as a reset, so a controller that never reset the
    PSRAMs -- or sent 99h before 66h -- passed every test.
    The model now keeps, per PSRAM, whether it has been reset and whether
    the previous command was 66h. Until 66h-then-99h reaches a chip, anything
    but 66h, 99h and Exit QPI stops the run with "PSRAM command before its
    power-up reset (66h, 99h)". It insists on this whatever state +PSRAM_QPI
    hands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
2026-09-26 feat(uart): add a 16550-compatible UART for the Linux console
    The UART of docs/pins-and-peripherals.md: byte registers at consecutive
    offsets (reg-shift 0), the layout Spike and QEMU virt use at 0x1000_0000,
    fixed 8N1, baud = clk / (16 x divisor), polled (no interrupt line).
    No FIFOs; a FIFO-less 16550 polled by Linux moves one character per
    timer tick. Instead:
    * TX back-pressure: a THR write while a frame is in flight holds ready
    low until it has gone, so the driver's 16-byte poll burst is paced by
    the bus. The byte goes straight into a {stop, data, start} shift
    register whose all-zero state is idle, so there is no holding register
    and no bit counter; THRE = TEMT.
    * RX flow contr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
2026-09-26 feat(gpio): add GPIO OUT/IN and the OLED's SPI transmitter
    The GPIO block of docs/pins-and-peripherals.md at 0x1001_0000:
    0x00 OUT bit i drives out[i]; bits 4-5 are the UART's pins, read 0
    0x04 IN in[7:0] through a two-flop synchroniser
    0x08 DATA one byte out on MOSI, MSB first; a write while busy stalls
    0x0C CTRL EN (SPI drives out[1] MOSI / out[3] SCK), DIV (SCK =
    clk / 2^(DIV+1)), BUSY (bit 8, read only)
    The transmitter makes each OLED byte a single store instead of ~100
    instructions a bit through spi-gpio. SPI mode 3 (SCK idles high). MOSI
    is its own flop and changes only on SCK's falling edge, so the device
    gets half an SCK period of both setup and hold wha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
2026-09-26 feat(soc_bus): take ready from the IO targets
    The UART holds a THR write, and the GPIO block a SPI DATA write, until
    its transmitter is free (docs/pins-and-peripherals.md), so an IO access
    is no longer always single-cycle. Each IO target returns a ready that
    may be low only on a cycle its own select is high, which lets the bus
    AND them rather than decode which one to listen to:
    d_ready = is_mem ? mem_ready : (uart_ready && gpio_ready)
    The CLINT and syscon never stall. alphaone_soc ties both readies high
    until the peripherals are instantiated, so behaviour is unchanged here.
2026-09-26 test(qspi-model): model released pins and check SCK is low before CS falls
    qspi_ctrl drives SCK and the chip selects idle for one cycle after reset
    before the first chip select falls, because a released SCK floats on
    the Pmod and a device selected on the same edge SCK starts being driven
    sees a clock of unknown level. No testbench could see that fix: each
    fed the model `ctl_oe ? cs_n : 3'b111` and the raw SCK, so a released
    SCK read as the controller's register value (0), and removing the fix
    still passed.
    The model now takes the raw pins plus host_ctl_oe and applies the Pmod
    itself: released chip selects are pulled up, released SCK is X. A chip
    select may fall only once SCK has been driven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
2026-09-26 feat(soc): wire the UART and the GPIO block into the SoC
    alphaone_soc instantiates src/uart.v at 0x1000_0000 and src/gpio.v at
    0x1001_0000 behind soc_bus, with their readies now live, and gains the
    ports the pinout needs (docs/pins-and-peripherals.md):
    uart_rx, uart_tx, uart_rts_n ui_in[3], uo_out[4], uo_out[5]
    gpio_in[7:0], gpio_out[7:0] ui_in, the other uo_out pins
    gpio_out[5:4] are always 0 (those pins are the UART's), and gpio_out[1]
    and [3] carry MOSI and SCK while the SPI transmitter is enabled. The pin
    mapping itself is left to the TinyTapeout wrapper, which is not built.
    UART_DIV_RESET (default 27, 115200 baud at 50 MHz) is exposed so a
    testbench can pick a faster reset ba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
2026-09-26 docs: record the UART, GPIO and SPI transmitter as built
    pins-and-peripherals.md: status, the measured sizes (UART 0.28 tiles /
    73 flops, GPIO with the SPI transmitter 0.12 tiles / 39 flops, each
    synthesised on its own against the repo's sky130 hd tt lib), and what
    the RTL chose where the plan left room: THR and RBR are the shift
    registers (THRE = TEMT), a frame that starts while RBR is full is
    dropped with OE, a 0 stop bit drops the frame, LSR read clears OE, LCR
    stores only DLAB, divisor resets to 27, writes wait for ready, MOSI
    changes only on SCK's falling edge. The tt_um wrapper is marked not
    built.
    soc-architecture.md: the map rows point at the RTL, the bus section
    describes the IO ba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
2026-09-26 test(qspi-model): take FLASH_FILE paths up to 1023 characters, fail on a bad one
    The model read +FLASH_FILE= into reg [1023:0], 128 characters.
    $value$plusargs keeps the tail of a longer path, $readmemh of what is
    left only warns, and the flash stays zero-filled -- so a flash-booting
    test under a deep work directory ran zeros from reset.
    The buffer is now 1024 characters, as tb_rivercore's INIT_FILE and
    DUMP_FILE. A path that fills it, or a file that cannot be opened, stops
    the run with an ERROR line.
    Checked on the SoC testbench with flash_boot: from a 370-character path
    the old model printed "$readmemh: Unable to open dddd.../flash_boot.hex"
    (the path cut to its last 128 characters) and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
2026-09-26 docs(pins): give earlycon the core clock, or no baud at all
    The planned `earlycon=uart8250,mmio,0x10000000,115200` would garble the
    console. earlycon.c's parse_options reads an optional clock after the
    baud, and register_earlycon falls back to uartclk = BASE_BAUD * 16
    (1.8432 MHz) without one; 8250_early.c's init_port then programs
    DIV_ROUND_CLOSEST(1843200, 16 * 115200) = 1, which here is clk/16,
    3.1 Mbaud at 50 MHz. Given no baud, early_serial8250_setup leaves the
    divisor alone ("assume the device was initialized"), which on this
    UART is 115200 at 50 MHz from reset.
    Checked against torvalds/linux master, drivers/tty/serial/earlycon.c
    and drivers/tty/serial/8250/8250_early.c.
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2026-09-27 fix(gpio): hold every register write while a SPI byte is shifting
    Only a DATA write waited for the shifter, so an OUT write -- CS# is OUT
    bit 0 and the OLED's D/C bit 2 -- completed in the middle of a byte.
    The SSD1331 samples D/C on the byte's 8th rising SCK edge and needs CS#
    and D/C held 60 / 40 ns after it (datasheet 7.1.3, table 21). The
    design review reproduced it through the core running from flash:
    `sw DATA(0xA5); sw OUT(D/C=1); sw DATA; sw DATA; sw OUT(CS#=1)` sent
    the command byte with D/C = 1 and raised CS# six bits into the last
    byte, at DIV = 2 and 3. Whether it bites depends only on how fast the
    code between the stores runs (45-60 clocks per instruction today, 65-
    129 clocks pe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
2026-09-27 fix(gpio): reset OUT to 0x09, CS# deselected and SCK idle-high
    OUT reset to 0, which drove the OLED's CS# low (selected) and put SCK
    (OUT bit 3) at 0, not SPI mode 3's idle-high. Enabling the shifter then
    made a rising SCK edge with CS# low. That was harmless only while RES#
    (bit 6) is also low; software that releases RES# before raising CS# and
    enabling the shifter would clock a stray bit into the SSD1331 (the
    design review's capture model logged "CS# rose mid-byte after 1 bits").
    0x09 sets CS# high and SCK high and keeps bit 6 low, so the OLED is
    still held in reset with its panel supply off. On the keypad two
    columns sit high and two low until software scans, which nothing reads.
    Area-ne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
2026-09-27 fix(uart): change TX only on baud ticks, so the first start bit is full
    The baud generator free-runs (the receiver shares it), and the TX pin
    was driven straight from the shift register, so a THR write that found
    the transmitter idle started its start bit anywhere inside a 16x tick:
    up to one divisor period short. The design review measured 8,120 ns
    against 8,640 ns nominal at divisor 27 (-6% of a bit), which eats into
    the far end's sampling margin on one side. Back-to-back frames were
    already exact.
    The tx flop now updates only on ticks. The start bit begins at the
    first tick after the write and every bit is exactly 16 ticks; the pin
    lags the shift register by up to one tick, so THRE/TEMT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
2026-09-27 docs(pins): record the GPIO review fixes and the DIV=2 margin
    OUT now resets to 0x09 (a99b80b): CS# deselected and SCK at mode 3's
    idle-high, RES# still low. Every GPIO register write now waits for a
    shifting byte plus half a period (edae17c), so `DATA; OUT` back to back
    holds CS# / D/C past the SSD1331's 8th-edge sample. DIV=2 meets the
    SSD1331's 75 ns minimum SCK phase exactly at 53 MHz with no margin for
    pad distortion, so the doc now says about 48 MHz.
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2026-09-27 test(gpio): add a self-checking unit testbench for GPIO and the SPI shifter
    tb/tb_gpio.v drives src/gpio.v the way the core does and checks it
    against a model written from the gpio.v header and
    docs/pins-and-peripherals.md:
    - every read predicted: OUT with bits 4-5 reading 0 (reset 0x09), IN as
    the input stood two edges before the read completes (never one),
    DATA reading 0, CTRL with the read-only BUSY;
    - every output pin on every clock: bits 7-6, 2, 0 from OUT, 5-4 zero, and
    3/1 from OUT while EN = 0 or SCK/MOSI while EN = 1 (idle-high SCK, MOSI
    holding the last bit sent -- also after bytes shifted with EN = 0);
    - a mode-3 SPI checker on the pins for DIV 0-3: every SCK phase inside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
2026-09-27 build: add test-uart and run it with the component tests
    Builds tb/tb_uart.v against src/uart.v with -g2012 and fails the target
    through run_tb on any FAIL or TIMEOUT line. The default run takes about
    30 s (0.93M checks); +SEED= and +NRAND= are there for longer soaks.
    `make test-uart` fails today on purpose: the "divisor reload" check
    (see 7233dd5) reports that a byte arriving right after the divisor is
    lowered is lost, because the baud counter keeps counting down the old
    divisor. It passes once src/uart.v reloads the counter on a divisor-latch
    write.
2026-09-27 fix(uart): restart the baud counter when a divisor latch is written
    tb_uart's "divisor reload" check (7233dd5) failed: after DLL/DLM were
    lowered from 1000 to 1, the baud generator kept counting down the ~1000
    clocks it had loaded from the old divisor, so a byte the far end sent at
    the new rate straight away was lost, and a THR write's start bit came
    995 clocks late. A 16550 does not do that: "Upon loading either of the
    Divisor Latches, a 16-bit baud counter is immediately loaded. This
    prevents long counts on initial load." (PC16550D, programmable baud
    generator.)
    A write to DLL or DLM now clears the counter, so the next cycle ticks
    and reloads from the new divisor. The cost is one early 16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
2026-09-27 test(uart): model the TX pin from the tick grid, restarted by divisor writes
    bbae28c makes a DLL/DLM write restart the baud generator (the next clock
    ticks, then one tick per new divisor), as a 16550 reloads its counter.
    The old reference model assumed a free-running tick and a fixed
    start-bit-to-frame-end schedule, so every divisor rewrite in the middle
    of a frame (the random run rewrites the divisor with its own value, and
    the back-pressure test writes DLL while TX is busy) made it lose sync.
    The TX model now keeps the tick grid itself -- learnt from the first
    start bit after reset, moved to "the clock after the write" by every
    completed DLL/DLM write -- and predicts the pin on every cloc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
2026-09-27 test(soc): add a model of the RP2350's UART, with CTS flow control
    The demo board's RP2350 is the far end of the chip's console
    (docs/pins-and-peripherals.md: UART1 on GPIO20/37, CTS on GPIO38 = the
    chip's RTS#). tb/rp2350_uart_model.v decodes every frame on the chip's
    TX at its configured bit time -- start bit re-checked at mid-bit, stop
    bit checked -- and also checks every edge inside a frame lies on a whole
    number of bit times from the start edge, so a short or long bit is an
    error, not just a wrong byte. It sends queued bytes on RX, 8N1; with
    flow control on it checks CTS before each character, as the PL011 does,
    and never starts one while RTS# is deasserted. Flow control off makes
    overr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
2026-09-27 test(soc): add a SoC testbench for the peripherals, with the board's devices
    tb/tb_soc_periph.v runs alphaone_soc at 50 MHz, booting a test program
    from the QSPI Pmod model's flash with the IO window at its default, so
    the UART and GPIO are reachable, and puts the demo board's devices on
    the pins: the RP2350 UART model (TX, RX, CTS = RTS#), the SSD1331 model
    and the keypad model; gpio_in[3] is the UART RX line, as on the chip.
    UART_DIV_RESET = 4 makes a character 640 clocks, slower than a store
    loop running from flash, so back-pressure really stalls.
    Programs (tests/soc/, linked by tests/soc/link.ld into flash) use the
    mailbox in tests/soc/periph.h -- stores to the reserved syscon window,
    w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
2026-09-27 test(soc): uart_hello -- print through back-pressure alone, then polled
    Hello, world twice from flash at the UART's reset divisor: first one
    store per character with no LSR polling, the THR store waiting while the
    previous character is on the line; then polling LSR.THRE before each
    store. The testbench checks the RP2350 got both lines intact, that the
    unpolled stores waited and the polled ones never did.
    Result: PASS in 27,572 cycles; 14 of 15 unpolled stores waited (3430
    clocks), 0 polled ones. With soc_bus ignoring the UART's ready the
    RP2350 gets "Hlo ol!" -- the test catches it.
    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
2026-09-27 test(soc): periph_access -- every load, store and AMO shape on the IO
    Byte, halfword and word loads and stores to the UART and GPIO with the
    values and sign extension checked; the 64 KB window aliases; a word
    store writing THR and setting DLAB (THR taken under the old DLAB); SCR
    reading 0; AMOs -- amoor.w on UART offsets 4-7 (ignored write-back) and
    on offset 0 (pops RBR, writes the byte back to THR), amoor/amoand/
    amoxor/amoswap on OUT with the pins checked, amoadd/amoor on CTRL,
    amoswap.w on DATA while a byte shifts (reads 0, the write waits),
    amoand.w clearing EN while a byte shifts (waits for it); misaligned
    loads and stores to the UART trap with the right cause and mtval and
    reach nothi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
2026-09-27 build: add test-soc-periph and run it with the component tests
    Builds tb/tb_soc_periph.v with the whole SoC and the board models,
    assembles each tests/soc/*.S into a flash image, and runs all seven:
    uart_hello, uart_echo, uart_linux, oled_spi, keypad, irq_stall and
    periph_access. Every run goes first; the target then fails if any run
    printed FAIL, ERROR or TIMEOUT or no PASS line (an assembly failure
    counts too). Output goes to build/soc_periph.
    All seven pass today in 59 s (27k to 364k cycles each).
    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
2026-09-27 docs: point at the peripheral testbenches, and list what stays open
    soc-architecture.md's verification section now says how the UART, GPIO
    and SPI transmitter are checked (make test-uart / test-gpio /
    test-soc-periph and the board models) and why not through run.sh soc:
    its IO window is off to match Spike, which has no such devices and
    could not lockstep them. CLAUDE.md lists the three targets.
    pins-and-peripherals.md closes open item 5 (the testbench models) and
    adds two found on the way: the IO ready is now in the core's stall
    path (check in STA), and GPIO IN's two-clock synchroniser means keypad
    software must discard one read after each column write.
    Claude-Session: https://claude.ai/co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
2026-09-27 docs: add the whole-design area audit, in tiles
    Where the area goes, what can be cut, and what each cut costs, from
    an area-optimizer pass over every block. Prototypes were measured at
    605b9d0 with one fixed yosys + sky130 hd tt script, each delta the
    mean of two file orders. The SoC was re-measured at b4f3f20 for the
    difference. Units are TinyTapeout tiles (1 tile = 11,300 um^2 at 60%
    density).
    - The UART and GPIO add +0.39 tiles (+112 flops). Flat SoC goes from
    13.15 to 13.54 tiles.
    - Keeping the full ISA (RV32IMAC, M+U, 4 PMP entries), the verified
    cuts reach 8.85 tiles, which fits 6x2 at 72%:
    - latch register file with one read port
    - one shared adder for multiply/divide
    - CSR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
2026-09-27 chore(agent-memory): record the area-optimizer's 605b9d0 audit results
    The area-optimizer agent's own notes from the whole-design audit:
    - a new baseline (13.15 tiles, 2,619 flops, with the ABC file-order
    noise of +-0.45k um^2)
    - every prototype's measured delta, and its core/SoC sim status
    - the items measured at ~0 that should not be tried again
    - the user's request to report area in tiles
    docs/area-audit.md is the write-up.
    Claude-Session: https://claude.ai/code/session_01TPbR2N3BvrJ87Ahes6ztPH
2026-09-27 fix(atomics): keep the reservation across same-hart stores and AMOs
    A store or AMO from this hart to the reserved word cleared the
    reservation, so the next SC failed. Spike keeps the reservation there and
    the SC succeeds. Both are legal -- the must-fail list covers stores by
    other harts and writes by other devices, and this SoC has neither -- but
    the difference cost most of the random suite: every unconstrained
    LR..store..SC sequence diverged at the SC, and comparison ends at the
    first divergence.
    Measured on the 2026-09-27 sandbox regression (3 rounds x 1000 rrag
    programs): 1594 of 1594 rrag failures were this one case, confirmed per
    test by finding the LR and a write to its word before th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
2026-09-27 fix(csr): an explicit minstret/minstreth write replaces the increment
    A write to minstreth kept the low half's increment: minstret =
    {new, minstret_next[31:0]}. A write to minstret kept the high half of the
    incremented value, so a carry out of the low half survived the write.
    Zicsr says the opposite: "If a CSR access instruction writes such a CSR,
    the explicit write is done instead of the update from the side effect."
    Writing either half of minstret is a write to minstret, so the writing
    instruction must not be counted at all; the half that is not written
    keeps its current value.
    riscv-tests rv32mi-instret_overflow checks exactly this (test 3:
    minstret=0xffffffff; minstreth=0xffffffff; nop;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
2026-09-27 fix(csr): an explicit mcycle/mcycleh write replaces the increment
    Same rule as the minstret fix, for the cycle counter: a write to either
    half is done instead of that cycle's increment (Zicsr: "the explicit
    write is done instead of the update from the side effect"), so the
    unwritten half keeps its current value. Before, a write to mcycleh kept
    the low half's increment and a write to mcycle kept a carry out of the
    low half in the high half.
    Spike models mcycle with the same wide-counter class as minstret, so it
    applies the same rule there (51835fd7).
    Claude-Session: https://claude.ai/code/session_01YadUBpZL5q8eFadm8snZkU
2026-09-27 verif: stop skipping boot-ROM lines in the reference trace
    Upstream Spike (7ab2efd6, now the reference on both machines) starts the
    hart at --pc directly -- sim_t sets state.pc = start_pc since c76d96d9
    (2026-03) -- so the five boot-ROM instructions at 0x1000 are neither
    executed nor logged. ref.dump now begins with the first program
    instruction, like dut.dump.
    Every generator plugin set ignore_lines = 5 to drop those lines; with the
    new Spike that deletes the first five real instructions and every test
    diverges on line 1. Measured on one rrag program: dut 17065 lines, ref
    17060, first hunk "1,5d0". Set ignore_lines = 0 explicitly in each plugin
    (river_core's schema defaults it to 4, so lea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
2026-09-27 test(soc): boot PSRAM-linked tests by forcing boot_addr, not a flash stub
    The SoC testbench reached a PSRAM-linked test through a two-instruction
    stub in flash -- lui t0, 0x80000; jr t0 -- traced from 0x8000_0000. That
    left t0 = 0x8000_0000 on entry, which matched the boot ROM of the Spike
    of the time. Upstream Spike starts the hart at --pc with every register
    0, so the stub now diverges on any test that reads t0 before writing it.
    Force the core's boot_addr to 0x8000_0000 for those tests instead: the
    first fetch goes through the fabric and the QSPI engine to PSRAM, every
    register is 0 on entry, and minstret no longer counts two untraced stub
    instructions. qspi_ctrl masks idle/done with ini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
2026-09-27 test(directed): compare the LR/SC policy tests against Spike
    lrsc_policy and lr_sb_sc were `expect` tests because the core cleared
    the reservation on a same-hart store or AMO to the reserved word and
    Spike did not. The core now keeps it too, so both run as full-trace
    `spike` comparisons: own word store, byte store and AMO leave the SC
    succeeding; a trap and an intervening SC still make it fail.
    Measured with Spike 7ab2efd6: both pass at the core level (lrsc_policy
    also under +DMEM_WAIT=3) and through the whole SoC.
    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
2026-09-27 test(directed): add cnt_xhalf -- read the other counter half right after a write
    The suite had no test for an instruction that reads one half of
    minstret/mcycle directly behind a write to the other half, which is the
    case the counter-write change got wrong (fixed in 97105f2/4c8ce94): the
    read port returned the increment the write had discarded. Written by the
    design reviewer; covers both counters, a no-carry and a carry case each,
    and rv32mi-instret_overflow's test 3. Spike-compared at the core level.
    SoC-skipped: its mcycle reads count clocks, tens per instruction at QSPI
    speed, while Spike counts one per instruction.
    Claude-Session: https://claude.ai/code/session_01YadUBpZL5q8eFadm8snZkU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
2026-09-28 chore(agent-memory): record the 2026-09-26 whole-branch review
    The riscv-design-reviewer's notes from its pass over the whole branch at
    bc0baec: no Critical or Major findings. The QPI framing, flash-only boot
    and start-up sequence are verified, along with the SoC-speed WFI and
    irq_stress probes. It lists the model blind spots its mutations found
    (flash mode bits M5-4, no PSRAM power-up reset requirement, chip select
    falling before the pins are driven) and the residual device state (flash
    77h wrap, the PSRAM wrap-32 claim). 1a18b60, 0930e03, b38b80b, 4d04809
    and d25a644 closed most of these. The flash 77h wrap is still open.
    The index gains the review, and two patterns: audit a protocol mode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
2026-09-28 chore(agent-memory): record the 2026-09-27 peripheral review
    The riscv-design-reviewer's notes on uart.v, gpio.v, soc_bus's IO ready
    and the top level at 4d04809. There were no Critical findings. The UART
    and the Linux 8250 driver's use of it are verified: the bus contract,
    held THR stores and interrupts, AMOs, RX baud tolerance and CTS.
    Its findings, all fixed on this branch:
    - MAJOR: SPI DATA vs OUT (D/C, CS#) ordering race (edae17c)
    - MINOR: OUT reset value (a99b80b)
    - MINOR: zero margin at DIV=2 and 53 MHz (0ee6704)
    - NIT: first start bit short (0b52fae)
    Still open: the IO ready in the stall path, to check in STA. The notes
    also carry the measured area knobs (8-bit divisor -0.058 tiles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
2026-09-28 chore(agent-memory): record the counter and LR/SC keep-policy review
    The riscv-design-reviewer's review of dce9568 (same-hart stores keep the
    reservation), f4e4975/4f4e071 (a counter write replaces the increment)
    and the SoC testbench's boot_addr force:
    - The keep policy is legal, per the must-fail list and the RVWMO
    commentary. The trap clear is now the only protection a bare-metal
    interrupt handler has, so it must not become an area cut.
    - The counter storage rule is correct, but the review found a MAJOR:
    the read port still returned the unsuppressed increment for the other
    half. It was reproduced against Spike 7ab2efd6 and fixed in 97105f2
    and 4c8ce94, with cnt_xhalf as the tes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
2026-09-28 chore(agent-memory): record what upstream Spike 7ab2efd6 does differently
    The reviewer's probed-behaviour notes now describe the reference in use
    since 2026-09-27:
    - There is no boot ROM. The hart starts at --pc with every GPR and
    minstret 0, so ignore_lines is 0.
    - A write to either counter half suppresses the whole 64-bit increment
    (51835fd7).
    - A toggling mcountinhibit write counts per the old value, the same as
    the DUT.
    - Writes to unimplemented pmpaddr4+ are logged.
    The pinned Feb-2025 behaviours these notes replace are marked
    superseded.
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2026-09-29 test(qspi-model): hand the flash over in dual-I/O continuous read
    +FLASH_DCRM starts the flash in the mode Fast Read Dual I/O (BBh) leaves
    it in when its mode bits M5-4 are 10 (W25Q128JV-DTR 8.2.11): each chip
    select window is 12 address clocks on IO1:0, then 4 clocks of mode bits,
    then dual data. Mode bits other than 10 end the mode; a window cut short
    before them leaves it set; undriven mode bits fail, since the device
    would latch whatever the lines float to. If the window goes on past the
    mode bits, the flash drives dual data into the transaction, and the run
    stops.
    `make test-qspi` gains a +FLASH_DCRM run. Mutant: the start-up sequence
    before d3cdb07 (8 + 2 clocks on CS0) stops with "fl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
2026-09-29 test(qspi-model): cancel a pending output enable when the chip is deselected
    The first read nibble scheduled `dev_oe <= #(delay_ns) 1`, which nothing
    could cancel. A chip select that rose less than delay_ns after that
    falling edge -- a reset in the middle of a read -- turned the output off
    after TCHZ_NS and then back on for good, and the next broadcast stopped
    the run with "host and device both driving IO": a false failure the
    2026-09-29 review hit with mid-transaction resets at a 25 ns delay.
    The enable is now a forked task that fires only if no deselect happened
    in between (a deselect counter). Proven with the reset stress added next:
    without the cancel, 5 of 6 seed/config pairs stop with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
2026-09-29 test(qspi): drop resets into tb_qspi_stress's random traffic
    No bench ever reset the memory path in the middle of a transaction, so
    the start-up sequence was only ever run from the model's clean hand-over
    states, never from a transaction cut short by a reset.
    With +RESETS, tb_qspi_stress drops a reset of 1-4 clocks into the random
    traffic about once per 4,096 clocks, wherever it lands: mid-command,
    mid-data, mid-start-up. The engine must rerun its start-up sequence
    from whatever state the cut-off transaction left and carry on; every
    fetch and load is still checked, and all of PSRAM compared at the end.
    A store the reset cut off may or may not have written its bytes, so the
    shadow takes the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
2026-09-29 fix(core): ignore boot_addr bit 0 when loading the reset pc
    The memory port contract says imem_addr is the pc and is halfword-
    aligned, and every pc source inside the core clears bit 0 -- except the
    reset vector, which went into pc as given. An odd strap or testbench
    value would have produced an odd fetch address that the memory
    controller is allowed to assume never happens.
    pc now resets to {boot_addr[31:1], 1'b0}. It costs nothing: the SoC ties
    boot_addr to 0x2000_0000 and the core-level testbench drives
    0x8000_0000, so bit 0 is a constant 0 in both. Found by the PR #5 review
    (core slice, n1).
2026-09-29 fix(uart): reset RBR to 0
    RBR had no reset. Linux's 8250 startup reads RX unconditionally
    (serial8250_clear_interrupts) before any byte has arrived, so an
    X-accurate simulation of a Linux boot, or a gate-level one, pulled X
    from RBR into the register file. Harmless in silicon, but it hides real
    X propagation in exactly the simulations meant to find it.
    RBR now resets to 0 (8 reset flops). tb_uart reads it after both
    resets it applies and wants 0; with the reset removed it fails at both
    ("got 000000xx" after power-on, the old byte 0x77 after the mid-run
    reset). Found by the PR #5 review (peripherals slice, n3).
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2026-09-29 feat(uart): detect a received break (LSR.BI)
    A frame whose stop bit read 0 was dropped whatever its data, so a break
    looked like line noise: no BI bit, no character. Linux counts breaks and
    takes the magic SysRq key from BI (serial8250_rx_chars ->
    uart_handle_break), so SysRq over the console was impossible.
    A frame whose every bit, stop bit included, samples 0 is now a break
    (rx_zero tracks it; one flop). As on a 16550 it sets LSR bit 4 (BI) and
    loads one zero character: DR with RBR = 0, or OE if RBR was already
    full. Reading LSR clears BI, as it clears OE, and a set on the same edge
    wins. A framing error -- stop bit 0 with any data bit 1 -- is still
    dropped and sets nothing. Either way th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
2026-09-29 test(uart): stop a hung tb_uart run after 5 ms without a bus transfer
    The only timeout was 400 ms of simulated time, about 40 times a normal
    run, so a mutant that hangs the bench -- a checker waiting for a CTS that
    never comes -- cost about 40 minutes of wall time before it reported.
    A watchdog now stops the run if no bus transfer completes for 5 ms,
    naming the section it was in. The longest quiet stretch in a passing run
    is 0.48 ms (transmit timing at divisor 300, seeds 1-3) and a whole run
    is about 10 ms. The every-stop-bit-0-is-a-break mutant, which hangs
    waiting for CTS, now fails in about 20 s. The 400 ms cap stays as a
    backstop. Found by the PR #5 review (peripherals slice, n5).
2026-09-29 test(soc): check that only a CLINT store writes the CLINT
    soc_bus selects the CLINT on address bits and the CLINT decodes
    addr[15:0], so a decode slip that let every store through -- the review
    tried `.we(dmem_req && dmem_we)` -- would have a PSRAM store rewrite
    mtimecmp and a GPIO write set msip. That mutant passed all 7 SoC
    peripheral programs and 13 SoC directed tests.
    clint_decode (make test-soc-periph) programs msip, mtimecmp and mtime,
    then stores to GPIO, the UART, the syscon window and PSRAM at the CLINT
    registers' offsets (0x0000, 0x4000/4, 0xBFF8/C), with values harmless
    to each target but visible in the CLINT, and checks that msip, mip.MSIP,
    mtimecmp and mtime are what they were.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
2026-09-29 fix(keypad): discard two IN reads after a column write, not one
    The doc and keypad.S said one discarded IN read is enough after driving
    a column. It is not at pipeline speed: the column pin changes on the
    edge the OUT store completes and IN is two synchroniser flops behind the
    pins, so only a load completing three or more clocks later sees the new
    rows. A zero-wait bench (the PR #5 review's) with `sw OUT` then three
    back-to-back IN loads read the old rows twice. keypad.S only worked
    because an instruction takes about 57 clocks through the QSPI memory;
    the testbench measured its first IN read 58 clocks after the OUT write,
    so it could never see the difference.
    keypad.S now discards two reads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
2026-09-29 test(directed): SoC-only MANIFEST lines, and run.sh soc build / soc one
    The SoC run takes each test once, from the first MANIFEST line that
    names it, so there was no way to run a test through the SoC a second
    time with the SoC's own plusargs -- the QSPI Pmod model's hand-over
    states and delays, the rd_late strap -- and every SoC run used the
    friendliest timing (the review, V4).
    A line `<name> soc <spike|expect ...>` is now SoC only and always run
    there; the core-level run skips it. `./run.sh soc build` and
    `./run.sh soc one <name> [+PLUSARG...]` now work: `soc` used to take the
    place of the subcommand, so there was no way to build or run one test
    for the SoC without running the whole suite.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
2026-09-29 test(directed): exercise LR/SC under timer interrupts at SoC speed
    t_ctl was the only test of an LR/SC loop under a timer interrupt, and
    the SoC run skipped it: its 100-clock period is shorter than a handler
    through the QSPI memory. Since same-hart stores keep the reservation,
    the trap clear is all that protects an LR/SC sequence from an interrupt
    handler's stores, and it was never exercised at the SoC's timing. The
    skip reason also said "a 40-clock timer period" for t_ctl; the periods
    are 40, 37, 50 and 100 clocks.
    t_ctl_slow runs t_ctl at a 2000-clock period through the SoC (a soc
    line) and wants the loop to finish, an interrupt taken and an SC failed
    by one. t_ctl.S now reports those two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
2026-09-29 test(directed): check minstret writes under memory waits and through the SoC
    cnt_xhalf, the test for 97105f2/4c8ce94 (an explicit counter write
    replaces the increment, and the other half reads what the write left),
    runs once, at zero wait, at core level only: its mcycle cases count
    clocks, so the SoC run skips it. Nothing wrote and read minstret under
    memory waits, where the stalls move the write and the read apart.
    cnt_instret is minstret only, so it compares with Spike under any
    timing: a low-half write at the carry edge followed by a read-modify-
    write of the high half and alias reads; a high-half write before an
    alias read and a CSRRC; a write before a load-use stall; a write before
    an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
2026-09-29 docs(core): bring the CPU reference up to the SoC as built
    The review found the reference behind the branch (core slice m1, m2):
    * The memory map still called the UART and GPIO windows reserved
    (reads 0); both are built. The file tables lacked uart.v, gpio.v,
    tb_uart, tb_gpio, tb_soc_periph and the board models, and described
    the Pmod model without its newer checks and hand-over states.
    * The mip row called MTIP a live wire, and 8.4 said nothing of the
    registered MTIP's lag. Both now say that mip.MTIP keeps its old value
    for two instructions after an mtimecmp store, why that is legal, why
    Linux never meets it, and that mtip_stale pins it.
    * mtvec's reset value: 0, as on Spike, w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
2026-09-29 docs: CLAUDE.md describes the SoC testbench's boot_addr force, not the old stub
    The verification paragraph still said the SoC testbench puts a jump to
    0x8000_0000 in the model's flash; 6889a33 replaced that with forcing
    boot_addr. It now says so, and mentions flash tests and the SoC-only
    MANIFEST lines. The invariants note the registered MTIP's two-
    instruction lag and mtvec's reset to an unmapped 0; the UART line gains
    break support, and the command list the SoC run and one SoC test.
    Found by the PR #5 review (core slice m2).
2026-09-29 docs(pins): the UART's break support, RBR reset, and the boot-time IRQ error
    The UART section now describes LCR.SBC (send a break), LSR.BI (a
    received break loads a zero character and sets BI; a framing error is
    still dropped), that reading LSR clears BI as well as OE, and that RBR
    resets to 0 -- the changes in 9d6ca63, 805324c and 3f0d708. The block
    table and size note use the re-measured UART: 0.28 tiles (3,207 µm²),
    76 flops, up from 73.
    The device-tree note explains the "IRQ index 0 not found" error that
    every boot logs with no `interrupts` property, so nobody chases it
    (the review, peripherals slice n1).
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2026-09-29 docs(soc): start-up, board prerequisites, verification, area and performance as of the review fixes
    * Start-up: the 16-clock dual-I/O continuous-read step and why it
    follows the 8-clock one.
    * Device prerequisites: the flash must be idle, nothing suspended, when
    reset is released (the engine cannot poll BUSY).
    * Boot: what mtvec's reset to 0 does when something traps before boot
    code sets it -- a silent cause-1 loop, the QSPI bus quiet -- kept by
    decision.
    * Verification: the flash-end straddle, t_ctl_slow, the hostile SoC
    lines, the model's new checks and hand-over states, resets in
    tb_qspi_stress, clint_decode, and every store width in pma_flash.
    * Area: the Area section still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
2026-09-29 docs(area): re-measure after the review, correct the noise floor and the 4x2 claim
    The review's area pass found the audit's noise threshold too tight (six
    file orders span 0.07 tiles, one stack pair 0.11; the doc said 0.04 and
    treated 0.05 as noise), the per-block flop table summing to 2,765 under a
    2,731 header (a hierarchical run; flattening merges 34), and a 4x2 fit
    claimed at 89-96% that placement growth would push past 100%.
    It also found two cut rows whose cycle notes change with the pipeline
    fixes kept for a follow-up branch: #3's multiply "hidden behind the
    fetch" holds only once M ops stop refetching, and #9's "0 SoC cycles"
    becomes +1 per branch once branches hold the fetch.
    A ne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
2026-09-29 fix(qspi): wait 8 clocks after reset before the start-up sequence
    A reset that lands just after the start-up sequence's PSRAM reset (99h)
    restarted the sequence one idle clock after it was released, so the
    restarted F5h reached the PSRAMs 30-60 ns after the 99h, inside the
    APS6404L's 50 ns tRST. The resets aimed at the start-up sequence in the
    next commit hit it in every run ("PSRAM selected within tRST of its
    reset"). Harmless in practice -- a PSRAM just reset is in SPI mode and
    the sequence resets it again two steps later -- but it is a datasheet
    violation, and the model is right to stop on it.
    The sequence now starts 8 clocks after reset is released; with the at
    least one clock of reset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
2026-09-29 test(uart): pin BI against an LSR read on the edge it is set
    The same-cycle priority section covered DR against an RBR pop and OE
    against an LSR read, but not BI: a mutant that let the LSR read's clear
    win over a break setting BI on the same edge passed the whole bench,
    and on silicon that loses a break -- a SysRq press -- whenever it lands
    on a console poll of LSR (the fix-round review, m3).
    Case (f) lines an LSR read up with a break's stop-bit sample: the read
    sees BI (and DR) clear, the next read sees them set (0x71), the one
    after sees BI cleared, and RBR holds the break's zero. The mutant now
    fails "(f) BI and DR set after that read".
2026-09-29 fix(uart): report a break that begins inside a character; want half a bit of mark after one
    Two gaps against a 16550 in the break detection added in 3f0d708 (the
    fix-round review, n2):
    * A break that began inside a character was never reported. The
    character ended in a framing error, and the receiver then only waited
    for the line to go high. Now, after a framing error, it counts one
    more frame of line from the bad stop bit's sample (rx_chk, one flop;
    the bit counter does the counting): if the line stays low through its
    stop sample, that is a break -- BI, and a zero character (DR, or OE if
    RBR is full). The moment the line is high it is back looking for a
    start bit, exactly as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
2026-09-29 test(directed): check the trap clear of LR/SC by construction; relax t_ctl_slow
    t_ctl_slow wanted an SC failed by an interrupt (x19 = 1), which depends
    on exactly where interrupts land in its loop -- pipeline timing that the
    fetch fixes kept for a follow-up branch will move, making the test fail
    with no bug (the fix-round review, n3).
    lrsc_trap_clear puts the interrupt inside the pair by construction:
    after an LR it makes the timer pending with a store to mtimecmp (a
    same-hart store, which keeps the reservation), sets MIE and waits, so
    the SC must fail (x10 = 1). A control runs the same sequence with MIE
    off first, and that SC succeeds (x12 = 0), so the stores are not what
    fails it. It hold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
2026-09-29 docs: the fix-round review's corrections, and the second round of fixes
    * MTIP's lag is two clocks -- two instructions only when the fetch is
    fast -- not "two instructions", and mtip_stale now pins both ends of
    it (CPU reference, CLAUDE.md).
    * A BUSY flash: the worst case is a chip erase, up to 200 s (a 64 KB
    block 2 s, a sector 400 ms), not 400 ms; and while §7.1.1 says it
    ignores everything but status reads and suspend, §8.2.45 has a
    software reset end a running erase, corrupting it (qspi-memories,
    soc-architecture). The board prerequisite stands.
    * The start-up sequence waits 8 clocks after reset, ends each window
    with SCK high, and relies on its clean two-clock Exit QPI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
2026-09-29 docs(area): re-measure after the second round of review fixes
    SoC 13.61 tiles, 2,736 flops (mean of four file orders; 13.64 / 2,735
    before, within noise). The UART is 0.29 tiles, 77 flops (3,321 µm²),
    with rx_chk for breaks that begin inside a character; qspi_ctrl 2,763
    µm², still 0.24 tiles and 54 flops, the reset wait reusing its counter.
2026-10-01 perf(core): start an M instruction during the fetch wait
    muldiv_start waited for !stall_other, which includes the pending
    instruction fetch, so a MUL/DIV started on the cycle its successor's
    fetch completed; muldiv_stall then dropped that fetch and the same word
    was fetched again. It now waits only for the non-fetch stalls
    (stall_nofetch); the result is still captured with !stall_other.
    SoC (PSRAM QPI): mul/mulh/div 84.2 -> 42.0 clk each. 0.00 tiles.
    Core directed 116/116, SoC directed 75/75 on this step.
    Claude-Session: https://claude.ai/code/session_01Djq9xhUoipY8bjatJd2QWZ
2026-10-01 feat(core): drop the register file reset; boot stub zeroes x1-x31
    x1-x31 are UNSPECIFIED after reset (Priv spec, Reset), so the
    synchronous clear of 992 flops bought only a mux in front of each.
    plugins/helpers/boot_flash.S now clears x1-x31 first (31 c.li, 62
    bytes), so flash-booted software still starts from zeroes, as Spike
    does. Simulation keeps a zero initial block; +RF_X leaves the registers
    X so a read of a never-written register shows up. tb_regFile checks
    that reset now leaves the registers alone.
    -0.38 tiles in the stack (-0.31 alone). Core 116/116, SoC 75/75; a
    flash-booted probe ORing every register the stub does not set stores 0
    with +RF_X, X with the old stub (negative control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
2026-10-01 feat(core): stall after a CSR write instead of forwarding it
    EX read CSRs through post-write forwarding (wval, the mtvec/mepc
    forward muxes) to save the cycle after a CSR write, which the QSPI
    fetch wait already hides. The instruction after a CSR write now waits
    one clock for the write to commit. One flop skips the mcycle increment
    the cycle after an mcycle/mcycleh write, so rdcycle right after
    csrw mcycle still equals Spike. csr_wval stays wired for tb_rivercore.v
    (pruned in synthesis).
    mtip_stale: the instruction after the MIE write now waits a clock, by
    which time MTIP has cleared, so the legal spurious interrupt no longer
    happens; its MANIFEST pins change to x18 = 0, x12 = -1 (both outc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
2026-10-01 feat(core): time-share one PMP checker between fetch and data
    Two PMP checkers evaluated every cycle. The fetch verdict is now taken
    in a stalled EX cycle and latched, the same way the upper half of a
    straddling instruction already was, so one checker serves both.
    -0.25 tiles. Cost: +1 EX clk per instruction only in U-mode or with a
    locked entry (+1 more when straddling); M-mode with unlocked entries
    pays nothing. Core 116/116, SoC 75/75.
    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
2026-10-01 feat(core): one register file read port, rs2 read in a stalled EX cycle
    The register file had two 32:1 read muxes. It now has one; an
    instruction whose rs2 field is not x0 spends one stalled EX cycle
    reading rs2 into rs2_hold, which snoops register-file writes so it
    always holds the architectural value. tb_regFile reads the two
    registers of each check one after the other.
    -0.48 tiles (+33 flops for rs2_hold/rs2_held). Cost: +1 clk per rs2
    instruction on zero-wait memory; on the SoC it is hidden behind the
    fetch except for branches with rs2 != x0 (43 -> 44 clk; compiled-C
    bench 48.30 -> 48.42 clk/instr, +0.25%). Not suite-run on its own; the
    next commit's tree (which contains it) passes core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
2026-10-01 chore(agent-memory): record the area-optimizer's corroboration at 10a37c3
    Baseline at 10a37c3 (13.60 tiles, 2,736 flops), each audit cut re-measured
    on main, the no-latch stack (10.04 tiles), the ICG register-file evidence,
    and the SoC cycle counts with the performance fixes.
    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
2026-10-04 docs: describe the area-cut core and record the applied stack
    CLAUDE.md and FyraCore_CPU_Reference.md described the pre-cut core: WB->EX
    CSR forwarding and the wval/trap_target/mret_target forwards, two PMP
    checkers, a two-port reset register file, decompression in IF, separate
    multiply/divide datapaths and an ALU shifter, and the speculative fetch
    behind branches. They now describe the core on this branch: the CSR-write
    stall and the *_legal wires, one time-shared PMP checker, the one-port
    register file with its rs2 phase and no reset (boot_flash.S zeroes
    x1-x31, +RF_X), decompression in EX, the shared-adder muldiv that also
    shifts (34 / 36 / 2 + shamt EX cycles, matching muldiv.v), the fet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
2026-10-04 docs(core): update the hazard list and the mstatus_after_we comment
    The fyracore.v header still listed the old hazards: it now names the
    fetch hold behind a branch or jump, the rs2 read cycle, the stall after a
    CSR write, the fetch PMP check cycles and muldiv starting during the
    fetch wait. csr.v said a trap or MRET can coincide with a csrw to
    mstatus; since the CSR-write stall it never does. Comments only.
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2026-10-04 chore(core): drop the dead exwb_instr; fix comments left from forwarding
    exwb_instr was written and never read (the trace uses exwb_raw_instr):
    32 flops synthesis already removed. Comments and docs still described
    the CSR forwarding the stall replaced: the PMP-refetch comment (now says
    why the refetch is still needed with a single, time-shared checker),
    csrfwd.S's header, cnt_alias's soc-skip note, and section 12.6 of the
    reference. The rs2-phase wording now says it applies to formats with an
    rs2 field (R, S, B, AMO), since decoder.v gives every other format
    rs2 = x0. From the area-cut design review (n2, n3).
2026-10-04 perf(core): hold the fetch behind ECALL, EBREAK, MRET, FENCE.I and PMP writes
    Branches and jumps already kept imem_req low while in EX. ECALL, EBREAK,
    MRET, FENCE.I and a PMP CSR write also always decide the next pc (trap,
    return, or refetch of the fall-through), yet each waited in EX for the
    speculative fall-through fetch to complete (~42 clk on the SoC's QSPI
    bus) and then threw it away. ex_nofetch (replacing ex_cti) now covers
    them all; on a NOMMU Linux syscall that is one wasted fetch on the ecall
    and one on the mret.
    Only decode-only terms are used: ex_trap and ex_illegal_insn can change
    while EX waits (forwarded operands, misa.C during a CSR-write stall), and
    imem_req must never drop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
2026-10-04 chore(agent-memory): record the area-cut design review
    The reviewer's notes on the area-optimised core: no Critical or Major
    findings, the five coverage gaps proven with mutants (now directed
    tests), and the recurring patterns it checked (stall sources vs
    irq_inject/flush/next_pc, the fetch-handshake rule).
2026-10-04 test(directed): mprv_lock must not read a2 before writing it
    With every register starting X (RUN_PLUSARGS=+RF_X) mprv_lock failed its
    trace compare: its 'addi a2, a2, 7' read a2, which the test never wrote.
    It is now 'addi a2, zero, 7' (same trace length); reference regenerated
    with Spike. Core and SoC pass it with and without +RF_X.
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2026-10-04 docs(area): record the river_core regression of the final tree
    65d5d44, conformance plus three random rounds: conformance 175/176
    (rv32ui-ma_data, known), rrag 3000/3000, riscv-dv 225/228 -- one program
    that never terminates on either model (traces identical to 200,000
    retires) and two Spike LR/SC interleave yields (LR and SC straddle a
    5000-step window, Spike fails the SC). No DUT divergence, no false pass.
2026-10-10 chore(agent-memory): record the 2026-10-09 compliance and PPA reviews
    The riscv-design-reviewer's notes on the pre-PR review of this branch at
    c7e6325. Compliance: no Critical or Major findings; ex_nofetch proven
    decode-only by 3,005 lockstep runs and 20 mutants, though no repository
    test pins that property, and +RF_X misses an X that only steers a branch.
    PPA: the relative area cut holds (-24% in the TT flow's cell set), but the
    tile figures come from a recipe that allows cells LibreLane excludes
    (TT-flow synthesis 16.58 -> 12.52 tiles), no TinyTapeout harden completes
    on main or here (hold buffers on the register file's enable loops), and
    the register-file reset removal saves nothing in th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
2026-10-10 test(directed): mie_disable must not count from a register it never wrote
    mie_disable increments s2 three times without ever writing it first.
    With every register starting at X (RUN_PLUSARGS=+RF_X) its dumps carry
    x18 = X (core, lines 13-15; SoC, line 14), yet both runs passed: s2 is
    not one of the registers the expect line checks, and the expect checks
    cannot see X (fixed in the next commit). 6b10d3b initialised the four
    tests the trace compares caught and missed this one.
    s2 is now cleared at entry. That moves every instruction by 4 bytes, so
    the alternative mepc in MANIFEST (the interrupt taken before the csrc,
    as Spike and the QSPI-speed SoC take it) moves from 0x8000002c to
    0x80000030.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
2026-10-10 test(directed): fail a run whose dump holds an X
    The expect mode could not see X. rd() took a register's last value
    with 0x[0-9a-f]+, so an all-X write (x10 0xxxxxxxxx) did not match and
    the previous hex value was returned instead, and a partial X
    (0x0000000x) matched as 0x0000000. sane() never looked for X at all.
    Under RUN_PLUSARGS=+RF_X that let a read of a never-written register
    pass: a control `li a0,5; add a0,a1,zero` (a1 never written) checked
    with `expect x10=0x5` failed without +RF_X (x10 = 0) and passed with it.
    It covered all 24 core and 11 SoC expect runs -- every interrupt, WFI,
    timer and LR/SC-trap test.
    sane() now fails a run that has an x or z digit anywhere in its dump,
    nam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
2026-10-10 docs: say what +RF_X does not catch
    regFile.v, run.sh and CLAUDE.md said that with +RF_X "any read of a
    register a program never wrote" shows up and fails the trace compare.
    Not quite: an X that only decides a branch never reaches the trace. The
    simulator takes the not-taken arm of `if (X)`, and when Spike, whose
    registers start at 0, also falls through, the traces agree. The audit's
    control rfx_bnez (bnez on a never-written t0) passes with +RF_X while
    its beqz twin fails; the review's rfx_blind/rfx_caught pair shows the
    same. The text now says an unwritten read fails on the X it leaves in
    the dump (written to a register, CSR or memory, or used as an address)
    and names the branch case as the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
2026-10-10 docs: give the stall cycles the SoC does not hide
    CLAUDE.md said that in the SoC "only a branch pays its rs2 phase", and
    the reference that the fetch PMP checks and the CSR-write cycle are
    hidden behind the next fetch. The PPA review measured what does show:
    - U-mode (or a locked entry): every jump and branch pays its fetch PMP
    cycle, +1 clock (jal 43 -> 44, bnez 43 -> 44); compiled C in U-mode is
    0.23% slower than in M-mode (48.43 -> 48.54 clk/instr; no difference
    on main).
    - An instruction after a CSR write pays the stall when it is one of the
    ex_nofetch ones (csrw mepc; mret).
    - Interrupts wait for an M op or shift in EX: timer latency in a loop of
    31-bit shifts averages 433 cl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
2026-10-10 chore(agent-memory): correct the area notes the review disproved
    The area-optimizer's notes quoted recipe tile figures as if they were
    TT-flow figures ("10.04 t, 81% of 6x2", "9.03 t, 73% of 6x2") and said
    LibreLane excludes neither dlclkp nor edfxtp. Both are wrong for the
    ttsky26c flow: its no_synth.cells excludes every dlclkp, edfxtp_1 and
    141 `_1` cells, so the recipe runs 20-24% low (LibreLane synthesis
    16.58 -> 12.52 tiles), and no harden of the SoC completes. The notes now
    say so up front, name the recipe that matches LibreLane, and point fit
    questions at the submission repository.
    The reviewer's notes: imem_req is gated by ex_nofetch, not ex_cti; the
    2026-10-04 finding's "river_core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
2026-10-10 docs(review): add the pre-PR review of the area-cut branch
    The adversarial review of this branch before its PR (2026-10-09/10), as
    an HTML report: an RTL compliance and hazard pass, a PPA and claims pass
    that ran the SoC through TT's LibreLane flow, and a verification audit.
    It records the verdict per area (RTL holds; tile, shape and timing claims
    did not), every finding with its proof and fix, the claims checked, the
    gaps still to close, what each finding's status is after the fixes on
    this branch, and the map from the SHAs the review cites to this branch
    after the history rewrite. area-audit.md points to it.
    The detailed reports, probes, mutants and logs stay in localFiles/
    (gitignored);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
2026-10-10 feat(soc): add the TinyTapeout top level
    tt_um_alfadelta10010_alphaone_soc puts alphaone_soc on the project's 24
    pins, as docs/pins-and-peripherals.md has them: the QSPI Pmod on uio,
    UART TX and RTS# on uo_out[4] and [5], RX on ui_in[3], GPIO OUT on the
    other six outputs, GPIO IN from all of ui_in, and the qspi_rd_late strap
    on ui_in[0].
    Reset is asserted asynchronously by rst_n and released on the second
    clock edge after it rises. The doc's plan was a plain two-flop
    synchroniser, which cannot work on the demo board: its firmware, loading
    a project with no config.ini section, stops the clock, pulses rst_n for
    2 ms and only then starts the clock (tt-micropython-firmware,
    demoboard.py: clock_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
2026-10-10 test(soc): add a pins-only bench for the TinyTapeout top level
    tb/tb_tt_um.v drives tt_um_alfadelta10010_alphaone_soc through its 24
    pins, clk and rst_n and refers to nothing inside it, so the same bench
    runs on a gate-level netlist. The board is wired from the pinout table,
    not from the wrapper: the QSPI Pmod model on uio with pulled-up chip
    selects and floating SCK and data, and the RP2350 UART model.
    tests/soc/tt_pins.S boots from flash and reports over the UART alone. It
    is reset three times and has to start again each time:
    1. the firmware's way: the clock stopped, a pulse on rst_n, the clock
    started afterwards;
    2. with the clock running, off the clock edge, while the flash d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
2026-10-10 docs: describe the TinyTapeout top level
    pins-and-peripherals.md said the wrapper was not built and planned a
    two-flop synchroniser for rst_n. It now describes what is built: the
    reset set by rst_n itself and released on the second clock edge, why (the
    demo board's firmware resets with the clock stopped), the pins while it
    is high, how long the strap has to be held, and that the board starts
    the clock by itself only when info.yaml's clock_hz is not 0.
    soc-architecture.md's board prerequisites and CLAUDE.md follow, and
    CLAUDE.md lists make test-wrapper.
    Docs only.
2026-10-10 chore(agent-memory): record the TinyTapeout wrapper review
    The riscv-design-reviewer's note on the first version of the wrapper:
    the reset needed clock edges the demo board's firmware does not give
    during its reset pulse, the bench's second reset missed the flash read
    it aimed at, and a missing synchroniser passed. The note ends with what
    was changed in answer; all of it is in the three commits before this
    one.
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2026-10-13 test(tb): check every register read against a shadow register file
    The register file reads synchronously, so the core must put on its read
    addresses in each cycle the registers the EX instruction will use in the
    next. A slip reads another register, or the right one a cycle stale, and
    a trace only shows it if the value happens to differ.
    tb_rivercore now checks, on every cycle with a valid instruction in EX
    and for each source register it names other than x0, that the macro took
    that register's address on the edge that started the cycle and that its
    data equals a shadow register file kept from the write port. A mismatch
    prints an ERROR line (run.sh fails on it) and ends the run with a
    DUT-AB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
2026-10-13 test(directed): register-file aliasing and capture-edge tests
    Five tests for the synchronous, write-first register file, each
    trace-compared with Spike and run under several memory timings:
    - rf_amo_alias: all nine AMOs with rd == rs2, rd == rs1 and
    rd == rs1 == rs2; LR with rd == rs1; SC with each aliasing, succeeding
    and failing; an AMO chain through rd -> rs2. KianV's sky25b FSM broke
    on AMO rd == rs2 under this macro; the suite had 1 such AMO in 45.
    - rf_load_alias: lw/lh/lhu/lb/lbu, c.lw and c.lwsp into their own base,
    a pointer chase, stores whose data is the base.
    - rf_raw_stall: read-after-write across the M unit, the serial shifts,
    the CSR-write stall, loads, SC, JALR/c.j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
2026-10-13 docs: describe the register file on the rf_top macro
    docs/CLAUDE.md and the CPU reference still described the one-port flop
    register file and its rs2_phase cycle. They now say what replaced them:
    the rf_top macro (views in macro/rf_top/, model src/rf_top.v), its
    synchronous write-first read, the read addresses taken from the fetch
    (rf_fields) or held on the EX instruction (rf_hold, with its equation in
    the stall list), x0 never written and masked on the decoded field, the
    operands read once in EX so AMO/LR/SC aliasing is safe, the testbench's
    read check, and the placeholder liberty as a known limitation.
    The zero-wait core bench figure is updated with the measurement: the C
    bench (cb_O2.elf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
2026-10-13 chore(agent-memory): record the final review of the register-file macro branch
    No Critical. Two Majors, both documented in a8228d4 and left to the user: the core relies on the macro's same-edge write-through (load-use, distance-2 RAW), which only the model, the author's slides and KianV's sky25b errata attest, timing uncharacterised (a one-entry bypass, ~0.13 t, would remove the dependence); and the harden settings put the macro mid-die where the precedents use the left edge, with two waivers that could hide an unconnected power pin.
2026-10-13 docs(macro): the 3x4 harden that routes clean
    With KianV's sky26c config -- the one that taped this macro out at 3x4
    -- adapted to our instance path and TT's 20 ns clock, the TinyTapeout
    top hardens at 3x4 on the sandbox's LibreLane 3.0.14 (58 min): detailed
    routing converges to 0 (14,466 -> 0 in nine iterations), DRC 0, LVS 0,
    antenna 0, PDN 0 with no waivers, lint 0 errors; LibreLane synthesis
    keeps exactly one rf_top; 8.67 tiles of std cells at synthesis, 11.08
    after PnR plus the macro, 55.4 % utilisation; 592 hold buffers and no
    hold violation at any corner; setup +2.55 ns at tt, -13.28 ns at ss.
    No harden of the flop-register-file SoC had completed before.
    The README now gives that con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
2026-10-13 perf(core): do not forward memory data from WB to EX
    WB forwarded wb_data to EX, which includes data read from memory. That
    value was never consumed: a load, LR or AMO in WB whose rd the EX
    instruction reads holds that instruction in EX for as long as it is in WB
    (load_use_hazard; tb_controller checks that everything writing memory
    data to rd sets memRD), what EX does with its operands on a stalled
    cycle is not kept (redirects, the M unit's start, WFI and the MRET and
    FENCE.I commits all wait for !stall), and the instruction reads the value
    from the register file in the cycle after it is written. EX now gets
    wb_fwd, the ALU-or-SC half of the write-back mux.
    Structurally the old mux put the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
2026-10-13 docs: WB forwards everything but memory data
    docs/CLAUDE.md and the CPU reference described WB->EX forwarding as
    carrying load data that may not be valid yet during a stall. It carries
    wb_fwd now: the ALU result, link address, CSR value or SC result. A
    load's value reaches its consumer through the register file after the
    load-use stall.
    Claude-Session: https://claude.ai/code/session_01DNy7PVxknBRXNYABu6mx2z
2026-10-13 perf(core): keep the address trap causes out of muldiv_want
    muldiv_want is "an M op or a shift is in EX and it is not trapping", and
    used ex_trap for the second half. Three of ex_trap's causes wait for the
    ALU's address -- misaligned access, access fault, misaligned branch
    target -- and an M op or shift can raise none of them: it makes no
    memory access and no jump (tb_controller sweeps this). ex_trap_decode is
    the rest -- ECALL, EBREAK, fetch fault, illegal instruction -- and is all
    muldiv_want needs.
    With ex_trap there, the ALU, the PMA compare and the PMP check sat in
    front of muldiv_stall, so in front of `stall` and of the enable of every
    pipeline register. In the 3x4 harden of 0c0ec3c t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
2026-10-13 perf(core): drop the interrupt exception from the EX/WB hold and bubble
    The EX/WB register held on `wb_mem_stall && !irq_inject` and bubbled on
    `stall && !irq_inject`. irq_inject requires !stall_other and
    !muldiv_want; wb_mem_stall is part of stall_other, and stall is
    stall_other || muldiv_stall with muldiv_stall implying muldiv_want. So
    irq_inject is never set on a cycle either condition holds, and the
    exception could not fire. It dates from when an interrupt could be
    injected during a stall.
    Dead as logic, it was live as a path: irq_inject contains !ex_trap, so
    the ALU and the PMP check reached every EX/WB register's enable through
    it as well.
    Checked at this commit: both testbench build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
2026-10-13 perf(core): expand a compressed instruction in IF, not in EX
    compressed_decoder moves from behind IF/EX to in front of it. IF/EX
    holds the instruction in its 32-bit form (ifex_instr), a compressed
    instruction's own 16 bits (ifex_raw16) for the trace and mtval, and the
    reserved-encoding verdict (ifex_c_illegal); ifex_raw_instr is rebuilt
    from them. A 32-bit instruction is its own expansion, so only the 16
    bits are extra: 17 flops, 101,898 to 102,653 um^2 at LibreLane synthesis
    (+0.06 tile).
    The expansion had been moved into EX to save a second 32-bit copy of the
    instruction (the comment this replaces). That put the decompressor in
    front of the decoder, the operand selects, the ALU and the br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
2026-10-13 perf(core): take mcycle's upper-half carry from a flop
    mcycle + 1 synthesises, area first, to one 64-bit ripple. inc64, new in
    csr.v, gives q + 1 with the carry into the upper half taken from a flop,
    c32, which says the low 32 bits are all ones. c32 is kept from the value
    loaded into the counter on the same edge, so mcycle's next value becomes
    a wire (mcycle_d) that is loaded on every edge, reset included. The
    write, inhibit and mcycle_wr_q rules are unchanged, and the EX read port
    still returns mcycle_next.
    In the 3x4 harden of 0c0ec3c the path from the CSR write address into
    mcycle was 43 cells, -6.93 ns at ss against 20 ns.
    minstret and mtime follow in their own commits.
    Checked at thi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
2026-10-13 perf(soc): take mtime's upper-half carry from a flop
    As for mcycle and minstret in csr.v: mtime's next value is a wire
    (mtime_d) and its + 1 comes from inc64. Register to register through the
    64-bit ripple it was 47 cells, -4.33 ns at ss in the 3x4 harden of
    0c0ec3c.
    With the three counters on inc64 and the rest of this series, the same
    harden flow gives -2.76 (mtime), -2.22 (mcycle) and -1.64 ns (minstret)
    at ss. What is left in front of them is the bus's write decode and the
    reset fan-out, not the carry.
    The tree at this commit is the one the series was verified on:
    make test-all; the directed suite, core 137/137 and SoC 86/86, each
    plain and with +RF_X +RF_COLLIDE_X; river_core conforma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
2026-10-13 test(directed): check the mcycleh write without counting clocks
    cnt_xhalf's third case wrote mcycleh and read mcycle in the next
    instruction, and compared the value with Spike: 0x201. Spike counts one
    per instruction and the core counts clocks, so the two only agree while
    every instruction between the mcycle write and the read takes exactly
    one clock. That pins the suite to the pipeline's timing: any change
    that costs an instruction a cycle fails the test without anything being
    wrong with the counter.
    The case moves to cnt_xcycle, which does not look at the value. It runs
    the same five instructions twice, the second time with the second write
    aimed at mscratch. Both runs take the same clock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
2026-10-13 perf(core): keep the SYSTEM and CSR checks out of muldiv_want
    The second group of slow-corner violators (44 endpoints, worst -1.82 ns
    on the routed rfm2-a3fo netlist) runs from the opcode through the
    whole trap decode into muldiv_want, from there into `stall`, and from
    stall to the enable of every pipeline register: 21.4 ns. 3.6 ns of it
    is the part of ex_trap_decode that an M instruction or a shift can
    never raise -- ECALL, EBREAK, the malformed SYSTEM encodings, WFI in
    U-mode, LR with rs2, and the CSR address and privilege checks.
    muldiv_want now tests ex_trap_iter: a fetch fault, the controller's
    `illegal`, a reserved compressed encoding, and a compressed
    instruction with misa.C clear. F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
2026-10-13 test(tb): say what the controller sweep's memRD property is for now
    The sweep's second property -- whatever writes memory data to rd is a
    read access -- was what load_use_hazard stood on while every other
    result was forwarded. 5db699d replaced that stall with use_hazard, on
    exwb_regWR, so the core no longer depends on it. The check stays, as a
    statement of what wbSel 01 means, and the comment stops naming a
    signal that is gone.
2026-10-13 docs: describe the register-write wait and the two-cycle EX
    The reference and the working notes still described WB->EX forwarding,
    the load-use stall and a one-cycle EX. They now say what 5db699d,
    ba7cd35 and 2683499 built: nothing is forwarded and a reader of the WB
    instruction's register waits (use_hazard); the ALU and comparator
    results are registered (alu_r, br_r) and an instruction stays in EX
    until they are its own (ex_wait, ex_ph); muldiv_want tests
    ex_trap_iter. The stall equations, the hazard table, the redirect
    rule, the PMP data check and the "why three stages" rationale are
    brought in line, with the reason the extra EX cycles cost nothing
    behind a QSPI fetch.
2026-10-13 perf(core): hold a register reader through ex_wait alone
    On the routed design of ba7cd35 the worst slow-corner path (+2.38 ns
    at 20 ns) is opcode -> decoder's rs2 field -> compare with exwb_rd
    (use_hazard) -> stall -> rf_hold -> the register file's read-address
    mux -> its bypass compare (rf.hit2), with the read address pins 1.1 ns
    behind it.
    use_hazard does not need to be a stall term. It already keeps ex_ph
    clear, and an instruction with ex_ph clear is held by ex_wait; once
    ex_ph is set, use_hazard cannot rise again, because EX/WB only takes a
    bubble while EX holds, so no writer can get in front of the
    instruction. So it leaves stall_nofetch, and with it the decoder's
    register fields and t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
2026-10-13 perf(soc): gate the pins with a reset flop of their own
    uo_out and the output enables are gated with the SoC's reset so that
    the pins sit at their reset values while it is held. rst is one flop
    feeding every flop of the SoC, so after placement it is a buffer tree
    about a dozen cells deep, and the pin gates ended up at the far end of
    it: on the routed design of ba7cd35 a change of rst reaches uio_oe
    10.6 ns after its clock edge at the slow corner, and with the flow's
    4 ns output delay those are the second-worst paths in the design
    (+2.59 ns at 20 ns), on the pins that hand the QSPI bus over.
    The gates now take `run`, the same signal the other way up from a
    flop of its own: cleared by rst_n,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
2026-10-13 perf(core): read the register file with the EX instruction's own addresses
    The register file reads synchronously, and until now its addresses
    were those of the instruction that would be in EX after the next edge:
    the fetched instruction's when IF/EX was about to take it, the EX
    instruction's own while it stayed (rf_hold). That saved a cycle and
    made the macro's address pins the end of the pipeline's longest
    control chain: every stall term, and the fetched word's field decode,
    in front of a hard macro's setup time and of regFile's bypass compare.
    On the routed design of ba7cd35 those are the three longest
    slow-corner path groups in the core (rf.hit2 +2.38 ns, the address
    pins +3.50, rf.hit1 +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
2026-10-14 docs(macro): harden results after EX was split, and why the flow missed ss
    The README's harden section ended at the A + B row, -4.89 ns at the
    slow corner. It gets a section for what followed:
    - the same config on ba7cd35 and bc7d28d: +2.38 and +3.35 ns at ss,
    +8.64 and +9.32 ns at tt, at 12.61 and 12.75 tiles;
    - the reason the resizer never worked on the slow corner: its wire
    capacitance estimate is 0.0815 fF/um where extraction gives 0.21 to
    0.23, so the layout that signs off at -4.89 ns looked like +2.24 ns
    to it (measured on the 4d21e43 run by re-timing its final layout
    both ways);
    - three runs with the estimate calibrated (LAYERS_RC, the RC layers,
    a 0.5 ns setup margin): a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
2026-10-15 test(tb): drive tb_tt_um's power pins from nets
    With USE_POWER_PINS the bench tied the netlist's power pins to
    constants, .VPWR(1'b1) and .VGND(1'b0). A hardened TinyTapeout netlist
    declares them inout, and iverilog refuses a constant on an inout port:
    tb_tt_um.v:72: error: expression not valid as argument to inout port: 1'd1
    tb_tt_um.v:72: error: Inout port expression must support continuous assignment.
    That stopped the gate-level run of the rfm2-a3fo-hg netlist before it
    started. VPWR and VGND are now wires assigned 1 and 0, as in
    TinyTapeout's own test bench. RTL runs do not define USE_POWER_PINS and
    compile the same code as before.
    Claude-Session: https://claude.ai/code/session_01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
2026-10-18 docs(macro): harden the split EX with the ff hold guard, both flows
    Two more runs of b5077cd at 3x4, now with main's ff-corner mapping to
    rf_top.ff-hold-guard.lib: A + B at 20 ns, and A + B + C with the 0.2 ns
    hold margin at 16 ns. Both route to 0, DRC, LVS and antenna 0, no setup
    or hold violation at any corner. The guard costs 0.02 tile on either
    flow; setup moves by placement noise (ss +3.28 ns at 20 ns, +0.54 ns at
    16 ns).
    A second table gives the hold at the macro's 48 inputs, every corner,
    from OpenSTA on each run's SPEF (it matches LibreLane's min.rpt to the
    picosecond): without the guard the split EX survives 0.63 to 0.65 ns at
    ff, below every fabricated user of the macro; with it 0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
2026-10-18 test(mutate): a mutation runner and 239 faults to measure the benches
    A bench that has never failed proves nothing about the design. This
    measures which benches can fail: tb/mutate/mutants.py lists 239 faults,
    each a find/replace on one file of src/ -- inverted conditions,
    off-by-one compares, stuck bits, dropped resets and enables, swapped
    priorities, removed stall and hazard terms, broken bypasses, wrong
    fields -- across every RTL file but the rf_top macro model. Each says
    what bug it stands for, and where it is known to be equivalent at the
    core level (fyracore never exercises the difference), it says so.
    tb/mutate/run.py applies one fault to a copy of src/ under build/mut/,
    never to src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
2026-10-18 test(tb): check the ALU against RV32I on corners and seeded random
    tb_alu was 43 hand-picked vectors, plus two that pinned the RTL's 0
    for control codes the controller never issues. It now compares the
    seven issued ops (ADD, SUB, SLT, SLTU, XOR, OR, AND) with an RV32I
    model on every pair of twelve boundary operands and 200,000 seeded
    random pairs (+SEED=, +N=), half of them drawn from the boundaries,
    one in sixteen with equal operands. SUB/SLT/SLTU come through the
    shared comparator, wired as fyracore wires it.
    Nothing is asked of the output for codes never issued, so it is no
    longer checked: mutant ALU07 (those codes give d1) now survives, as it
    should, since no specification gives that ou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
2026-10-18 test(tb): let a PSRAM broadcast's second select join before the first SCK edge
    The Pmod model decides who a transaction is for on the first change of
    its chip selects. The PSRAM broadcasts at start-up (reset enable,
    reset, enter QPI) select both chips, and in a zero-delay simulation
    both selects fall on one event. In the SDF-annotated gate-level runs of
    the 16 ns netlist at max_ss, CS2 falls 8 ps before CS1: the model took
    the broadcast for PSRAM B's alone, PSRAM A stayed in SPI mode, and the
    run failed at PSRAM A's first access, 29,000 clocks later, with an
    unsupported command 84h.
    Each chip sees its own select, so a second select that falls before any
    SCK edge of the transaction now joins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
2026-10-18 test(tb): make tb_tt_um's clock and edge timings defines, for runs with delays
    For the SDF-annotated gate-level runs the pins bench needed its clock
    period, the two inputs it drives just after a clock edge, and the
    reset-to-pins check as parameters, and an $sdf_annotate hook. They are
    defines whose defaults are the bench as it always ran: TCLK_NS 10,
    IN_DLY_NS 1, RST_CHK_NS 2, no SDF_FILE.
    IN_DLY_NS is the one that matters. The bench releases rst_n and moves
    the ui_in[0] strap 1 ns after an edge. The SDC puts every input at
    0.2 * TCLK, and at ss the clock reaches the flops 2.65 ns after the pin
    while rst_n takes 1.55 ns, so with real delays the release beat the
    edge it was meant to follow: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
2026-10-19 test(tb): a CLINT bench against its register map and timer rules
    clint.v had no unit bench, and the directed suite killed only one of
    eight CLINT mutants: MTIP a count late, a byte lane crossed in
    mtimecmp_hi or mtime_hi, msip written by any lane, mtimecmp resetting
    to 0, mtimecmp_hi reading the low half and mtime_lo unwritable all
    passed it.
    tb_clint runs a cycle model written from CPU reference section 4 and
    clint.v's header: msip bit 0, mtimecmp low/high (all ones after reset),
    mtime low/high (0 after reset, counting every clock with the 64-bit
    carry), every other offset reading 0 and ignoring writes, byte lanes on
    every write, an mtime write done instead of that clock's increment, and
    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
2026-10-19 test(tb): give tb_regFile, tb_inc64 and tb_rf_fields a PASS line
    The three benches ended with "ALL ... TESTS PASSED" and printed no
    summary at all on a failure. They now print "PASS <bench> (<n> checks)"
    or "FAIL <bench>: <n> failures", like the rest of the unit benches, so
    the make targets can require a PASS line and a failure says how many
    checks failed.
2026-10-19 test(make): fail a unit bench on its exit status, ERROR/FATAL, or no PASS
    run_tb piped vvp into tee, so make saw tee's exit status, never vvp's:
    a bench that stopped on $fatal passed. It grepped only for ^FAIL and
    ^TIMEOUT, so an ERROR or FATAL line passed too, and so did a bench that
    ended early without printing anything conclusive -- nothing required a
    PASS line. Probed with three throwaway benches: one calling $fatal, one
    printing PASS then $error, one printing neither PASS nor FAIL; all three
    passed the old run_tb and all three fail the new one (make exit 2).
    run_tb now writes the log, keeps vvp's exit status, prints the log, and
    passes only if the status is 0, a line starts with PASS,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
2026-10-19 test(tb): bound every memory request's wait in tb_qspi_stress
    tb_qspi_stress drives 400,000 clocks of core-shaped traffic and
    printed PASS at the end however little of it was served: a memory
    path that deadlocked part-way, or a port the arbiter starved, simply
    ran out the clock and passed with smaller counts in its PASS line.
    On every clock a request now has WAIT_LIMIT (4000) clocks to see
    ready, on both ports; the first to exceed it fails the run at once. A
    transaction is about 50 clocks, a fetch waiting behind a data access
    about 150, a start-up sequence after a reset a few hundred: the
    longest waits in the four runs are 167 clocks for a fetch and 86 for
    a data access. At the end the run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
2026-10-19 test(make): run the seeded unit benches over several seeds
    Ten unit benches draw random stimulus from a seed (+SEED=): tb_alu,
    tb_branchCtrl, tb_signExt, tb_decoder, tb_csr, tb_muldiv, tb_pmp,
    tb_clint, tb_uart and tb_gpio. test-all runs each with seed 1. `make
    test-seeds` runs all ten once per seed in SEEDS (default 1-8), each
    through run_tb, and stops at the first failure with the bench and seed
    to rerun. The benches print the seed they started from, so a failing
    line reproduces with `vvp <bench> +SEED=<n>`.
    Seed 2 runs clean in 236 s, including the default-seed runs it depends
    on.
2026-10-19 test(tb): check every bus transaction against the access the trace shows
    The trace prints a memory access as the instruction sees it -- the
    address from exwb_alu_result and, for a store, the data at its width --
    and the comparison with Spike checks those. Nothing in it shows what
    went on the bus. A store in the wrong byte lanes, with unreplicated
    data or to the wrong word passed until a later load happened to read
    it back, and a stray transaction passed altogether: mutant FC28 (a
    failing SC issuing a bus read) survived the whole directed suite.
    On every retire of a load, store, LR, SC or AMO, tb_rivercore now
    checks the transaction completing with it against what the trace says
    (CPU referen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
2026-10-19 test(directed): U-mode takes an M interrupt whatever mstatus.MIE is
    Two interrupt mutants passed the suite: U-mode interrupts masked by
    MIE (FC12) and an interrupt writing the pc into mtval (FC60).
    irq_umode makes an MSI pending and enabled in mie while MIE = 0, so
    M-mode never takes it, then MRETs to U-mode with MIE still 0. Priv
    3.1.6.1: interrupts for a higher privilege are always enabled, so it
    must be taken at the first U-mode instruction. The handler reads
    mcause, mtval (0 for an interrupt), mepc and mstatus, clears msip and
    returns. mtimecmp is set to -1 first so MTIP agrees between the models
    (their reset values differ). Spike checks it; also under waits.
    Claude-Session: https://cl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
2026-10-19 test(directed): MEI, MSI, MTI pending together are taken in that order
    The interrupt priority of Priv 3.1.9 was not tested with all three
    pending: mutant FC11 (MSI ahead of MEI) passed the suite.
    irq_prio raises MEIP through the testbench's hook, MSIP through msip
    and MTIP with mtimecmp = 0, all with MIE = 0, then sets MIE. Each
    handler run records its cause and clears its source; x10 collects the
    causes a byte each and must read 0x000b0307, x11 the count, 3. Expect
    mode, because Spike has no device behind MEIP; skipped in the SoC run,
    which has no MEIP hook.
    Claude-Session: https://claude.ai/code/session_01MJaHJiMQKuQ3SGVs55UuFB
2026-10-19 docs: describe the new test targets, runner knobs, mutation and formal
    The test section of docs/CLAUDE.md now lists test-pmp, test-clint and
    test-seeds; says what makes a unit bench fail (exit status, a PASS line,
    no FAIL/TIMEOUT/ERROR/FATAL line) and that each prints its check count
    and reproducing seed; documents `./run.sh refs <name>...`, the
    FYRA_SRC / OUT_DIR / FAILFAST knobs, and the bus-contract and
    bus-transaction checks in memory_model and tb_rivercore; and gives the
    commands for mutation testing (tb/mutate/run.py) and the CSR proof
    (tb/formal/run.sh).
    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
2026-10-19 docs: what the 62.5 MHz clock means for the UART divisor, rd_late and speed
    The 3x4 harden now closes timing at 16 ns at every corner, and the
    submission's clock_hz becomes 62.5 MHz. Three statements assumed
    50 MHz:
    - the UART's reset divisor, 27, is 115200 baud only at 50 MHz; at
    62.5 MHz it gives 144,676 and 115200 needs 34 (-0.3 %);
    - the rd_late strap: at 62.5 MHz two clocks are 32 ns, against a pad
    round trip of a little over 20 ns plus the device's clock-to-output,
    which is the late edge of rd_late = 0's window and well inside
    rd_late = 1's, so use 1, as near 66 MHz;
    - "0.89 MIPS at 50 MHz, a clock no timing analysis has confirmed":
    62.5 MHz is now confirmed, about 1.1 MIPS,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
2026-10-20 chore(agent-memory): record the verification upgrade's state
    Environment and tool quirks, the plan's status and commit hashes, TB
    bugs found and fixed, spec ambiguities (interrupt vs exception order,
    muldiv operand hold, unspecified ALU/branch outputs, Spike's shrunken
    CLINT aperture), coverage holes and waivers.
    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
2026-10-22 chore(agent-memory): record the verdicts on the surviving mutants
    The verification agent checked whether any surviving mutant points at an
    RTL fix. None does. FC02 (no csr_wb_hazard), FC49 (muldiv_ready kept
    across a flush) and MD07 (borrow from sum[32]) are proven equivalent by
    k-induction on the core or on muldiv alone; FC27 (rd written on every
    memory-stall cycle) is equivalent by argument; RG01/RG04 are killed by
    test-regfile. The Spike CLINT window above 0x0200C000 is a testbench
    question, recorded with the options. A U-mode WFI with TW=0 is retired
    by Spike and treated as a NOP by the core, both legal, so its test has
    to be expect mode.
    Claude-Session: https://claude.ai/code/session_0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
2026-10-22 test(mutate): add mutants for resets that work from power-on only
    FC80-FC85 keep a register's power-up reset and ignore later resets; the
    suite has no mid-run reset yet, so they survive it.
    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
2026-10-22 test(tb): drop resets into a running program with +RESETS/+RESET_AT
    +RESETS=<k> [+RESET_AT=<n>] [+RESET_STRIDE=<s>] [+RESET_LEN=<l>] raises
    rst k times on the falling edge. The core and CLINT reset, memory keeps
    its contents; every checker forgets what the reset cut off.
    State audit of tb_rivercore on a reset:
    - dump writer, terminate logic, bus check: gated by !rst already; the bus,
    muldiv_want and use_hazard checks hold no state across clocks.
    - register-file check: disarmed while rst is high (rf_chk_armed). The
    shadow follows the write port, as the register file does.
    - spin detector: streak cleared while rst is high.
    - not reset: terminate, saw_tohost, post_tohost_retires, the dump,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
2026-10-22 test(tb): sweep RX's rise across the end of a framing error's low-line count
    The random driver keeps out of the window where the outcome flips; only
    nothing or a break is legal there, never a data byte (UA07).
    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
2026-10-22 chore(agent-memory): record the WO-03 review
    The reset bench (cf4af8c, b5f0301) is approved with nothing blocking.
    The notes record why each of the coder's deviations is safe, that the
    river_core flow sees no change without the new plusargs, and the two
    optional follow-ups: an ERROR when a mid-run reset lands after the
    tohost store, and the EX-valid bit on the reset NOTE line.
    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
2026-10-22 test(directed): list what core_reset's resets actually land on
    LR, DIV, store, AMO, ECALL, the M-mode WFI wait, the timer interrupt and
    both handlers. Comment only.
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2026-10-22 test(formal): report a yosys crash as ERROR, not as a failed proof
    A yosys error or timeout printed FAILED, and the mutation runner scored
    that as KILLED, so a tool crash inflated the kill count. FAILED now needs
    a counterexample (or induction hitting the depth limit) in the log; no
    verdict prints ERROR and exits 2. The runner records that as ERROR and
    --report counts it apart from killed and survived.
2026-10-22 chore(agent-memory): record the WO-06 review
    The core memory-port harnesses (813d77a, 49b8589) are approved with
    nothing blocking. The length-1 induction on core_hold is real: the
    harness's start values apply to the base case only, every assertion
    is checked in the step, nothing is assumed, and the register-file
    stub's free read data can only add behaviours. REQ-MEM-001 is now
    proven on both ports; REQ-MEM-002 is checked 10 cycles from reset.
2026-10-22 docs: add a roadmap from PR #11 to Linux, FPGA and power
    Records the 2026-10-23 decisions (stay at 3x4; SPI controller for an SD
    card and the OLED; a full syscon; RTL lock before the Verilator port,
    Linux bring-up and FPGA ports) and every approach considered, chosen or
    not: the tiny_spi-compatible SPI register map, the syscon map and its
    reset path, fetch word reuse, area to win back, the formal coverage at
    b8d8627 and what to prove next, FPGA boards, and the power levels the
    sky130 hd library and the TT flow allow.
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2026-10-23 test(soc): move EVENT, VALUE and VALUE2 to syscon +0x7F0
    The syscon's RESET_CAUSE and BOOT_MODE sit at the old +0x4 and +0x8.
    +0x7F0 stays in reach of a 12-bit store offset, and the bench decodes
    the mailbox exactly. periph_access's read-0 probe leaves +0x10 (STRAPS)
    for the spare word +0x7FC.
    Claude-Session: https://claude.ai/code/session_019zkognLPfixN4kyHZggwa9
2026-10-23 test(soc): drain UART and SPI before FINISH and take the verdict there
    A FINISH that powers the SoC off must not cut a character or a pixel,
    nor trip the port checkers on the fetch it cuts. Output after FINISH
    fails the run.
    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
2026-10-23 feat(soc): syscon block -- reboot, power-off, reset cause, boot mode, chip ID, straps
    sifive_test's FINISH convention at +0x00, so Linux's generic syscon
    drivers and the benches use the same register. The sticky state is on
    the pin reset; syscon drives the reset of everything else (rst_soc).
    Nothing instantiates it yet.
    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
2026-10-23 feat(soc): reset every block but syscon from it, and hold the rd_late strap across reboots
    A reboot holds the SoC reset for two edges, as the shortest pin reset
    does; power-off holds it until rst_n. syscon is unreachable in the
    lockstep benches, whose traces do not change. tests/directed/run.sh gains
    syscon in the SoC source list.
    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
2026-10-23 feat(soc): syscon watchdog in the DesignWare WDT layout, reset through the reboot path
    Linux's dw_wdt (snps,dw-wdt) runs it unchanged at syscon +0x100..+0x1FF.
    It ticks from mtime[29:14], with a 2-bit count: never early, at most 1.5x
    late. A TORR write kicks and makes no tick; once enabled it cannot be
    stopped. Its flops are on rst_soc, so it disables itself through its own
    reset; expiry raises rq like a FINISH reboot and sets RESET_CAUSE bit 2
    (WDT, sticky, W1C, pin reset only). Also corrects the alphaone_soc.v header:
    rq, rq2 and off are on rst too.
    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
2026-10-23 docs(soc): syscon -- register map, reset architecture, power-off and device tree
    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
2026-10-23 docs(pins): reboot and power-off at the pins; the strap is latched at the pin reset
    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
2026-10-23 docs(soc): keep the recipe's flat SoC figure apart from syscon's own
    The area paragraph summed syscon's stand-alone TT-cell figure into the
    recipe's flat 0.7 tiles and called the total flat. CLAUDE.md also left
    syscon's reboot and power-off flops out of what the pin reset resets.
    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
